jorgenmk/avr-cansat/rapport/acronym.tex

\chapter*{Forkortelser}
\begin{acronym}
	\acro{ESR}{Ekvivalent Serie Resistans}
	\acro{GGA}{Global Positioning System Fixed Data}
	\acro{NMEA}{National Marine Electronics Association}
	\acro{MOSFET}{Metal Oxide Semiconductor Field Effect Transistor}
	\acro{SCL}{Serial Clock}
	\acro{SDA}{Serial Data}
	\acro{CS}{Chip Select}
	\acro{SS}{Slave Select}
	\acro{MISO}{Master Input/Slave Output}
	\acro{MOSI}{Master Output/Slave Input }
	\acro{SCLK}{Serial Clock}
	\acro{DR}{Dead Reckoning}
	\acro{ADC}{Analog-to-Digital Converter}
	\acrodef{AD}{Analog-til-Digital}
	\acro{AGC}{Automatic Gain Control}
	\acro{AES}{Advanced Encryption Standard}
	\acro{AM}{amplitudemodulasjon}
	\acro{API}{Application Programming Interface}
	\acro{AVR}{Alf og Vegards RISC-prosessor}
	\acro{bps}{Baud per second}
	\acro{CAN}{Controller-Area Network}
	\acro{CMOS}{Complementary metal-oxide-semiconductor}
	\acro{CMRR}{Common-Mode Rejection Ratio}
	\acro{CPU}{Central Processing Unit}
	\acro{CTS}{Clear to Send}
	\acro{DAC}{Digital-to-Analog Converter}
	\acro{DC}{Direct Current}
	\acro{EMI}{Electromagnetic Interference}
	\acro{ERC}{European Radiocommunications Office}
	\acro{FAT}{File Allocation Table}	\acro{FET}{Field-effect transistor}
	\acro{FM}{frekvensmodulasjon}
	\acro{IC}{Integrated Circuit}
	\acro{ID}{identifikasjon}
	\acro{IEEE}{Institute of Electrical and Electronics Engineers}
	\acro{I$^{2}$C}{Inter-Integrated Circuit}
	\acro{IR}{infrarød}
	\acro{I/O}{In/Out}
	\acro{ISP}{In-System Programming}
	\acro{JTAG}{Joint Test Action Group}
	\acro{ksps}{Kilo Samples per Second}
	\acro{LED}{Light Emitting Diode}
	\acro{LIN}{Local Interconnect Network}
	\acro{LDO}{Low-Dropout}
	\acro{LSB}{Least Significant Bit}
	\acro{MMC}{Multi-Memory card}
	\acro{MSB}{Most Significant Bit}
	\acro{NAROM}{Nasjonalt senter for romrelatert opplæring}
	\acro{NiCd}{Nickel-Cadmium}
	\acro{NiMH}{Nickel-Metal Hydride}
	\acro{OFM}{overflatemontert}
	\acro{PC}{Personal Computer}
	\acro{PM}{fasemodulasjon}
	\acro{PLL}{Phase Locked Loop}
	\acro{PWM}{Pulse With Modulation}
	\acro{QFN}{Quad Flat No leads}
	\acro{RC}{Resistor-Capacitor}
	\acro{RISC}{Reduced Instruction Set Computer}
	\acro{RF}{radiofrekvens}
	\acro{RPSMA}{Reverse Polarity SMA}
	\acro{RTC}{Real-time Clock}
	\acro{RTS}{Request to Send}
	\acro{RTTY}{Radioteletype}
	\acro{SAR}{Successive Approximation Register}
	\acro{SD}{Secure Digital}
	\acro{SDHC}{Secure Digital High Capacity}
	\acro{S/H}{Sample and Hold}
	\acro{SMA}{SubMiniature version A}
	\acro{SMBus}{System Management Bus}
	\acro{SOT}{Small Outline Transistor}
	\acro{SPI}{Serial Peripheral Interface}
	\acro{SRD}{Short Range Device}
	\acro{TI}{Texas Instruments}
	\acro{UART}{Universal Asynchronous Receiver/Transmitter}
	\acro{UHF}{Ultra High Frequency}
	\acro{USB}{Universal Serial Bus}
	\acro{VCO}{Voltage-controlled oscillator}
	\acro{RH}{Relative Humidity}
	\acro{SMD}{Surface Mounted Device}
	\acro{NTC}{Negative Temperature Coefficient}
\end{acronym}
