jorgenmk/avr-cansat/rapport/handlelister.tex

\chapter{Regnskap}
\label{app:regnskap}

Ett av arbeidsgivers rammer var en øvre økonomisk grense på 5000 norske kroner. Vedlegg \ref{app:regnskap} vil dokumentere alle utgifter relatert til oppgaven.

Tabellene \ref{tab:farnell1}, \ref{tab:farnell3}, \ref{tab:spark}, \ref{tab:spark2}, \ref{tab:farnell2}, \ref{tab:elfa} og \ref{tab:annet} viser detaljerte handlelister fra hver bestillingsrunde. Totalt beløp for alle utgifter havner på 4408 kroner.

\begin{table}[htb]
\centering
\begin{tabular}{llllllllll}
\toprule
\textbf{Komponent}&\textbf{Varenr.}&\textbf{Min antall}&\textbf{Antall}&\textbf{Stk. Pris}&T\textbf{Totalt}\\
\midrule
100 nF kondensator&1414664&Min 10&10&0.31&3.1\\
33 nF kondensator&1414688&Min 10&10&0.4&4\\
22 pF kondensator&1414678&Min 10&10&0.31&3.1\\
10 $\mu$F kondensator&9402136&Min 10&10&3.37&33.7\\
100 $\mu$F kondensator &9695672&&4&3.84&15.36\\
10 pF kondensator&9753559&Min 10&10&0.24&2.4\\
2.2 $\mu$F kondensator&9402152&Min 10&10&2.02&20.2\\
4,7 $\mu$F kondensator&1650928&&1&0.61&0.61\\
8.2 k$\Omega$&9234128&Min 50&50&0.24&12\\
33 k$\Omega$ motstand&9334378&Min 50&50&0.33&16.5\\
10 k$\Omega$ motstand&9332391&Min 50&50&0.37&18.5\\
300 $\Omega$ motstand&9332987&Min 50&50&0.37&18.5\\
1 M$\Omega$ motstand&9332413&Min 50&50&0.37&18.5\\
1 k$\Omega$ motstand&9332383&Min 50&50&0.37&18.5\\
2,2 $\Omega$ shunt&1652978&&1&0.74&0.74\\
5,6 $\Omega$ shunt&1399730&Min 10&10&0.77&7.7\\
1,5 $\Omega$ shunt&1399714&Min 10&10&0.77&7.7\\
100 $\Omega$&9333703&Min 50&50&0.16&8\\
4.22 k$\Omega$&1653139&&2&0.74&1.48\\
2.2 k$\Omega$ motstand&1469887&Min 50&50&0.3&15\\
100 k$\Omega$&1652905&&2&0.74&1.48\\
INA193AIDBVT&1564940&&3&24.06&72.18\\
LP2985IM5-3.3&9778284&&3&14.09&42.27\\
LP2985IM5-5.0&9778306&&1&13.76&13.76\\
MMBT2222&1459098&&4&0.25&1\\
BSS138 N-MOSFET&1431319&&2&1.51&3.02\\
BAS16 DIODE&1621825&Min 10&10&0.48&4.8\\
LED 0805 green&1685052&&4&3.02&12.08\\
LED 0805 red&1685054&&1&3.03&3.03\\
IR RECEIVER &4913139&&1&17.99&17.99\\
3.6864MHz Krystall&1079075&&4&6.02&24.08\\
32kHz Krystall&1457088&&1&7.87&7.87\\
Bus-connector&359907&&5&40.06&200.3\\
Thermistor&1187086&Min 5&5&7.75&38.75\\
Thermistor&9707174&&1&50.3&50.3\\
Fuktsensor&1566264&&1&67.1&67.1\\
Akselerometer&1566157&&1&110.06&110.06\\
Hex spacer&R401001402 &&1&104.2&104.2\\
\midrule
Total kostnad:&&&&&999.86\\
\bottomrule
\end{tabular}
\caption{Første handleliste Farnell(alle priser i NOK)}
\label{tab:farnell1}
\end{table}

\begin{longtable}{p{2.3cm}lllllllll}
\caption{Tredje handleliste Farnell(alle priser i NOK)}
\label{tab:farnell3}\\
\toprule
\textbf{Varenr.} & \textbf{Antall} & \textbf{Komponent} & \textbf{Stk. Pris} & \textbf{Totalt}\\
\midrule
\endfirsthead

\multicolumn{4}{l}{{\bfseries \tablename\ \thetable{} -- forts. fra forrige side}}\\
\textbf{Komponent}&\textbf{Varenr.}&\textbf{Antall}&\textbf{Stk. Pris}&\textbf{Totalt}\\
\midrule
\endhead

\multicolumn{4}{l}{\bfseries \tablename\ \thetable{} forst. neste side}\\
\multicolumn{3}{r}{{}}
\endfoot

\bottomrule
\endlastfoot

1056234 & 10 & SOCKET, SMD, 6WAY & 4.58 & 45.8\\
1081473 & 5 & MOSFET, N, SOT-23 & 2.19 & 10.95\\
1100337 & 5 & RESISTOR, 1206 0R2 & 5.13 & 25.65\\
1212263 & 1 & CHARGE MANAGER LIION LDO, SMD, 2057 & 36.39 & 36.39\\
1216982 & 1 & PLUG, LOW VOLTAGE, 0.7MM & 9.49 & 9.49\\
1216988 & 1 & SOCKET, LOW VOLTAGE, 0.65MM & 10.53 & 10.53\\
1294480 & 5 & CAPACITOR, 0603, 100PF, 200V, C0G & 2.3 & 11.5\\
1362560 & 10 & CAPACITOR, 0805, 47PF, 50V, NP0 & 0.26 & 2.6\\
1399696 & 10 & RESISTOR, 0R3 1\% 0805 0.125W & 0.79 & 7.9\\
1414573 & 10 & CAPACITOR, 0402, 1NF, 50V, X7R & 0.13 & 1.34\\
1414664 & 30 & CAPACITOR, 0805, 100NF, 50V, X7R & 0.32 & 9.6\\
1414678 & 10 & CAPACITOR, 0805, 22PF, 50V, NP0 & 0.32 & 3.2\\
1437701 & 1 & SLIDE SWITCH, SPDT, R/A, ON-ON & 47.75 & 47.75\\
1515671 & 5 & FERRITE BEAD, 0603 CASE, 1KOHM & 0.67 & 3.35\\
1559374 & 1 & Voltage Regulator IC & 12.65 & 12.65\\
1564940 & 1 & CURRENT SHUNT MONITOR, 500KHZ & 25.3 & 25.3\\
1576013 & 5 & RESISTOR, 97K6, 0805 0.1\% 25PPM 0.1W & 5.68 & 28.4\\
1578142 & 5 & RECEPTACLE, FREE, 6WAY & 1.22 & 6.1\\
1578205 & 5 & HEADER, R/ANGLE, SMT, 6WAY & 6.18 & 30.9\\
1640891 & 1 & CRYSTAL, 8.000MHZ & 15.74 & 15.74\\
1650863 & 1 & CAPACITOR, CERAMIC MULTILAYER & 0.65 & 0.65\\
1652811 & 1 & THICK FILM CHIP RESISTOR & 0.74 & 0.74\\
1652905 & 2 & THICK FILM CHIP RESISTOR & 0.74 & 1.48\\
1652924 & 2 & THICK FILM CHIP RESISTOR & 0.74 & 1.48\\
1652925 & 1 & THICK FILM CHIP RESISTOR & 0.74 & 0.74\\
1653139 & 2 & THICK FILM CHIP RESISTOR & 0.74 & 1.48\\
1656583 & 2 & LEAD, SKT/FREE END, 150MM, PK10 & 41.72 & 83.44\\
1685052 & 3 & LED, SMD, 0805, PURE GRN & 3.02 & 9.06\\
359907 & 1 & SOCKET, PC104, THROUGH, 40WAY & 40.06 & 40.06\\
3908021 & 1 & RECEPTACLE, SMT, U.FL & 18.74 & 18.74\\
613009 & 50 & RESISTOR, 0805 180R & 0.09 & 4.65\\
7568355 & 5 & CAPACITOR, 0603, 27PF, 100V & 3.09 & 15.45\\
9227806 & 10 & CAPACITOR, 0805, 1UF, 16V & 0.42 & 4.2\\
9227849 & 10 & CAPACITOR, 0805, 4.7UF, 16V & 2.8 & 28\\
9234284 & 50 & RESISTOR, RC11 0805 180K & 0.24 & 12\\
9236392 & 50 & RESISTOR, RC11 0805 10M & 0.19 & 9.6\\
9332456 & 50 & RESISTOR, 0805 11K & 0.18 & 9.05\\
9333991 & 50 & RESISTOR, 0805 16K & 0.16 & 8\\
9334580 & 50 & RESISTOR, 0805 4K7 & 0.16 & 8\\
9334653 & 50 & RESISTOR, 0805 51K & 0.16 & 8\\
9402136 & 10 & CAPACITOR, 0805, 10UF, 10V, X5R & 3.37 & 33.7\\
9402152 & 10 & CAPACITOR, 0805, 2.2UF, 10V, X7R & 2.02 & 20.2\\
9406352 & 10 & CAPACITOR, 0805, 10NF, 50V & 0.52 & 5.2\\
9526625 & 5 & TRANSISTOR, PNP, SOT-223 & 16.27 & 81.35\\
9695672 & 1 & CAPACITOR, CASE D, 100UF, 16V & 3.84 & 3.84\\
9728937 & 1 & HEADER, SOCKET, 2MM, 50WAY & 59.44 & 59.44\\
9753559 & 10 & CAPACITOR, 0805, 10PF, 50V & 0.24 & 2.4\\
9778284 & 1 & V REG LDO +3.3V, SMD, 2985, SOT235 & 14.37 & 14.37\\
9778306 & 1 & V REG LDO +5.0V, SMD, 2985, SOT235 & 14.04 & 14.04\\
9846336 & 1 & MOSFET, P, SOT-23 & 7.73 & 7.73\\
9962832 & 1 & SWITCH, SPNO, SMD & 2.74 & 2.74\\
\midrule
Totalt: &  &  &  & 1143.71
\end{longtable}

\begin{table}[htb]
\centering
\begin{tabular}{lllll}
\toprule
\textbf{Varenummer}&\textbf{Beskrivelse}&\textbf{Antall}&\textbf{Pris}&\textbf{Totalt}\\
\midrule
COM-08226 & DOSOnChip & 2 &12,95 & 25,90\\
GPS-00178 & GPS-antenne ekstern & 1 &18,95 & 18,95\\
GPS-08418 & GPS chipantenne & 2 &2,95 & 5,90\\
GPS-08825 & GPS mottaker MN5010HS & 2 &39,95 & 79,90\\
PRT-00127 & microSD socket & 2 &3,95 & 7,90\\
\midrule
Frakt: &&&& 4,20\\
Totalt:&&&& 142,75\\
\bottomrule
\end{tabular}
\caption{Første handleliste Sparkfun.com(alle priser i US\$)}
\label{tab:spark}
\end{table}

\begin{table}[htb]
\centering
\begin{tabular}{lllll}
\toprule
\textbf{Varenummer}&\textbf{Beskrivelse}&\textbf{Antall}&\textbf{Pris}&\textbf{Totalt}\\
\midrule
PRT-00341 & Li-Ion Batteri & 2 & 8,95 & 17,90\\
COM-00650 & FT232USB-UART & 1 & 3,95 & 3,95\\
PRT-08612 & Batterikonnektor SMD & 4 & 0,95 & 3,80\\
PRT-00587 & MiniUSB konnektor & 1 & 1,50 & 1,50\\
\bottomrule
\end{tabular}
\caption{Andre handleliste Sparkfun.com(alle priser i US\$)}
\label{tab:spark2}
\end{table}

\begin{table}[htb]
\centering
\begin{tabular}{lllll}
\toprule
\textbf{Varenummer} & \textbf{Beskrivelse} & \textbf{Antall} & \textbf{Pris} & \textbf{Total}\\
\midrule
359907 & SOCKET, PC104, THROUGH, 40WAY & 3 & 40.06 & 120.18\\
9778284 & V REG LDO +3.3V, SMD, 2985, SOT235 & 4 & 14.37 & 57.48\\
3908100 & RECEPTACLE, SMT, H.FL & 1 & 25.5 & 25.5\\
1564940 & CURRENT SHUNT MONITOR, 500KHZ & 3 & 25.3 & 75.9\\
7569564 & CAPACITOR, S/TERM, 0805, 100NF, 50V & 20 & 0.96 & 19.2\\
9695672 & CAPACITOR, CASE D, 100UF, 16V & 3 & 3.84 & 11.52\\
1685052 & LED, SMD, 0805, PURE GRN & 1 & 3.02 & 3.02\\
1685054 & LED, SMD, 0805, RED & 1 & 3.03 & 3.03\\
1651700 & SPACERS, 15MM & 12 & 4.46 & 53.52\\
1632238 & PCB Connector  & 2 & 15.87 & 31.74\\
\midrule
Total: &  &  &  & 576.36\\
\bottomrule
\end{tabular}
\caption{Andre handleliste Farnell(alle priser i NOK)}
\label{tab:farnell2}
\end{table}

\begin{table}[htb]
\centering
\begin{tabular}{lllll}
\toprule
\textbf{Varenummer}&\textbf{Beskrivelse}&\textbf{Antall}&\textbf{Pris}&\textbf{Totalt}\\
\midrule
43-543-12 & Plugg & 1 & 12,60 & 12,60\\
43-544-03 & Motstykke  & 1 & 0,92 & 0,92\\
43-544-78 & Ledning & 6 & 10,10 & 60,60\\
48-012-43 & Distans & 20 & 2,80 & 56,00\\
65-612-52 & EMI-filter & 5 & 8,65 & 43,25\\
\midrule Totalt: &&&&173,37\\
\bottomrule
\end{tabular}
\caption{Handleliste Elfa(alle priser i NOK)}
\label{tab:elfa}
\end{table}

\begin{table}[htb]
\centering
\begin{tabular}{lll}
\toprule
\textbf{Beskrivelse}&\textbf{Totalt}\\
\midrule
Jernvare Clas Ohlsson & 188,00\\
Fallskjerm & 150,00\\
Tollutgifter første bestilling Sparkfun & 249,00\\
\midrule
Totalt: & 587,00\\
\bottomrule
\end{tabular}
\caption{Andre utgifter(alle priser i NOK)}
\label{tab:annet}
\end{table}
