jorgenmk/avr-cansat/rapport/title.tex

\begin{titlepage}

\begin{center}

% Upper part of the page
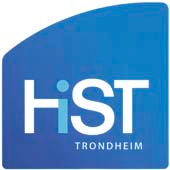
[picture p11: rapport/logo.png]
\\[1cm]
 %bb=0 0 170 170,
\textsc{\LARGE HiST Bacheloroppgave}\\[1.5cm]

% Title
\HRule \\[0.4cm]
{ \huge \bfseries CanSat}\\[0.4cm]

\HRule \\[1.5cm]

\textsc{\Large Satelitt i en colaboks}\\[0.5cm]
% Author and supervisor
\begin{minipage}{0.4\textwidth}
\begin{flushleft} \large
\emph{Gruppedeltakere:}\\
Mats Møller \textsc{Bæren}\\
Jørgen Moe \textsc{Kvalvaag}\\
Gaute \textsc{Nilsson}\\
Joakim André \textsc{Tønnesen}\\[0.5cm]
\emph{Studieretning}\\
\textsc{Elektronikk}\\[0.5cm]
\emph{Oppdragsgiver}\\
\textsc{narom}
\end{flushleft}
\end{minipage}
\begin{minipage}{0.4\textwidth}
\begin{flushright} \large
\emph{Startdato}\\
6 Januar 2009\\[0.5cm]
\emph{Veiledere:} \\
Valdemar \textsc{Finanger}\\
Stein \textsc{Øvstedal}\\[0.5cm]
\emph{Prosjektnummer}\\
\textsc{hpe} 0914\\[0.5cm]
\emph{Kontaktperson hos oppdragsgiver}\\
Torstein \textsc{Wang}\\
Jøran \textsc{Antonsen}
\end{flushright}
\end{minipage}

\vfill

% Bottom of the page
{\large \today}

\end{center}

\end{titlepage}
