jorgenmk/avr-cansat/rapport/GPS-Software-flytskjema.pdf

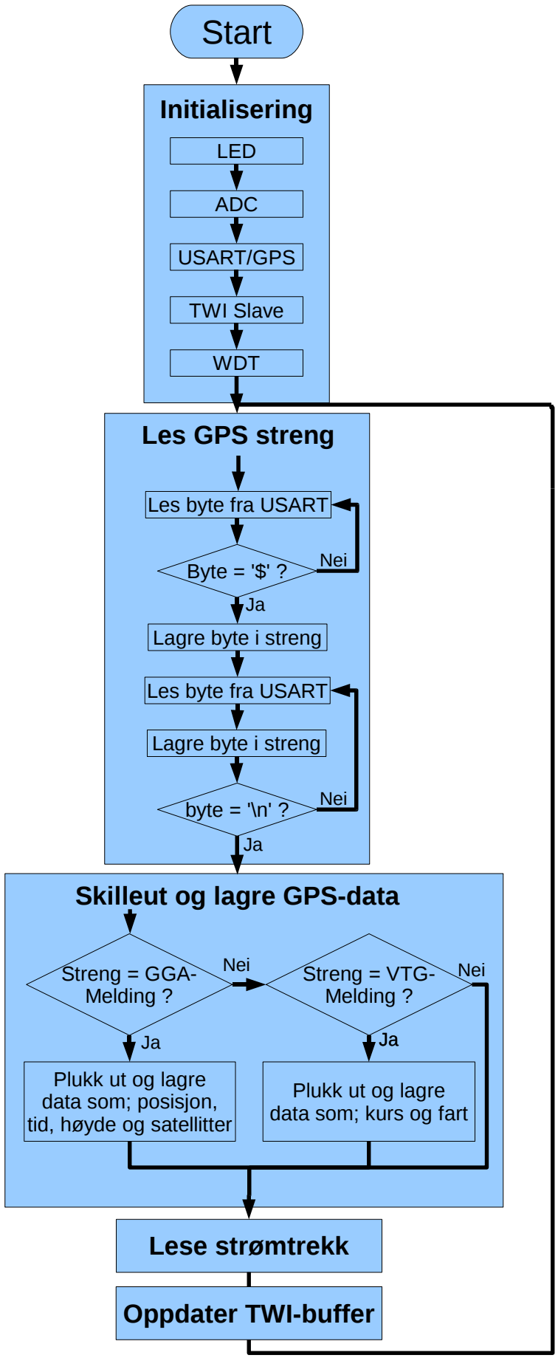
[picture p13: figure]
Start; LED; Initialisering; ADC; USART/GPS; TWI Slave; WDT; Les byte fra USART; Oppdater TWI-buffer; Byte = '$' ?; Lagre byte i streng; Les GPS streng; byte = '\n' ?; Plukk ut og lagre data som; posisjon, tid, høyde og satellitter; Skilleut og lagre GPS-data; Streng = VTG- Melding ?; Plukk ut og lagre data som; kurs og fart; Streng = GGA- Melding ?; Nei; Lese strømtrekk
