jorgenmk/avr-cansat/rapport/datablad/TN-090013-1D_Cansat_TX.pdf

# Technical Note

# Cansat TX

TN-090013

TN-090013 revision 1

Revision | 1
Date | 2009-03-13
Prepared by | SK

Checked by

Approved by

# 1. Introduction

This note contains some ideas for implementation of a telemetry transmitter in the 860MHz band for low data rates up to 10km distance.

# 2. Transmission budgets

Transmission loss calculated from the free space loss equation (860MHz, 10km):

A=20×log

L
4××d

=20×log

0.349m
4××10000m

=−111.1dB

and the thermal noise:

P=k×t×b=1.38×10

−23×300=−173.8dBm/Hz

Norbit AS | TN-090013-1 Cansat TX | 2/5
| dB | dBm | Comments
TX power | | 27 | 0.5W
TX antenna gain | 0 | 27
Free space loss | -111.1 | -84.1 | 10km, 860MHz
RX antenna gain | 0 | -84.1
| RX signal level | -84.1 | Signal power at RX
Thermal noise | | -173.8 | ktb
RX bandwidth | 37 | -136.8 | 5kHz
RX noise figure | 5 | -121.8 | Noise power at RX
Signal to noise | 10 | -126.8 | Depends on BER
| RX sensitivity | -121.8
Link margin | 37.7

# 3. Block diagram

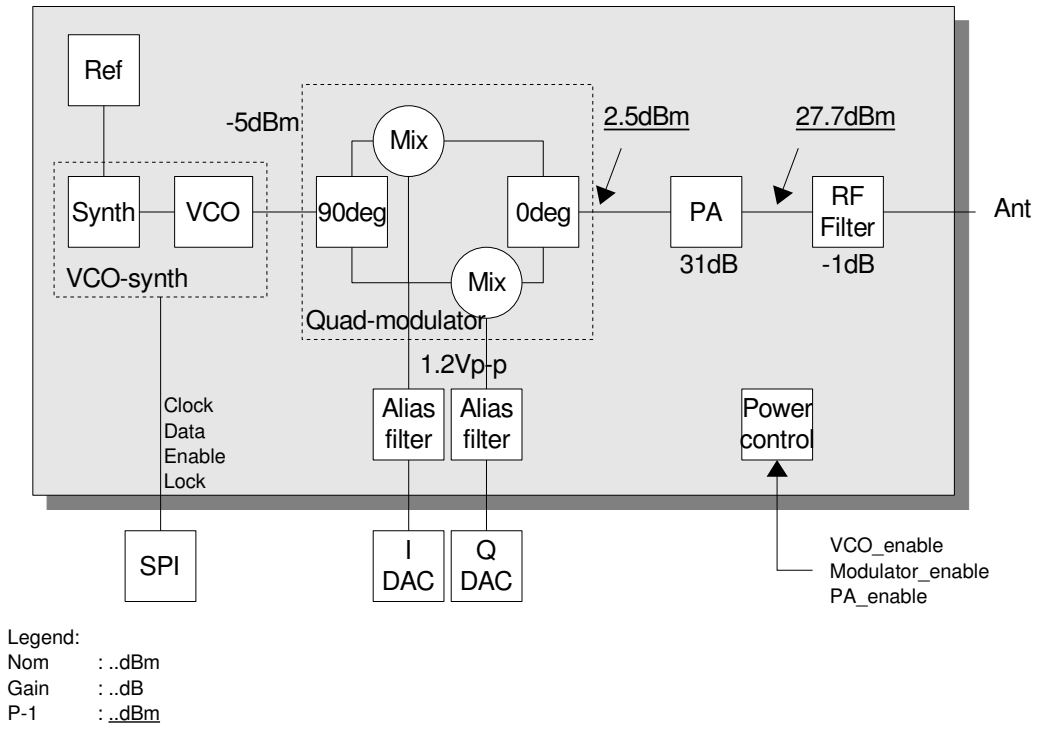
[picture p14: figure]
Ref; Synth; VCO; Alias filter; 90deg; Mix; 0deg; RF Filter; Ant; I DAC; Q DAC; SPI; -5dBm; 2.5dBm; 27.7dBm; Quadmodulator; VCO-synth; Legend:; Nom; : ..dBm; Gain; Clock Data Enable Lock; Power control; VCO_enable Modulator_enable PA_enable

# 4. Specifications

Frequency | : 860MHz band, programmable
Accuracy | : +/-2ppm
Transmit power : 27dBm | 0.5W
Power supply : 3V, 85mA
| : 5V, 240mA
Modulation | : FM, PSK, AM
Bandwidth | : DC .. 4kHz | narrow
: DC .. 100kHz wideband
Programming : 3-wire serial

5

C

o

# mponent

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
oscilla

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
Clip

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
vice

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
vice

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
m I/Q: 1.2Vpp diff
e

r

e

n

tial hig

h im

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
Minici

rcuit

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
filt

e

r

:
Minici

rcuit

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
alias

filt

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
vice

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
m I/Q : 1Vpp 5V, 100mA Opt modulator (

p

assiv

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
Minici

rcuits

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
868 .. 895MHz
LO: 10dBm
P-1: 1dBm

Opt driver:
Analog Devices, ADL5541
15dB
6GHz
P-1: 19.7dBm
5V, 90mA

Opt PA:
Analog Devices, ADL5322
700 .. 1000MHz
Gain: 20dB
P-1: 27dBm
5V, 320mA

Opt Antialias filter (2 of): Analog Devices, AD8132
2.7 .. 5.5V, 10mA
