jorgenmk/avr-cansat/rapport/Hovedkort/flytskjema.pdf

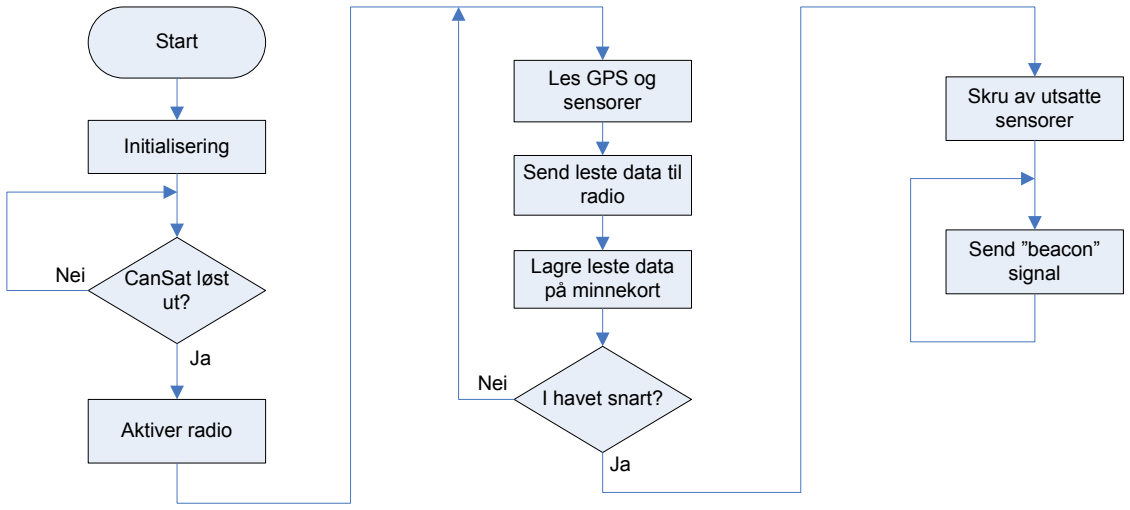
[picture p15: figure]
CanSat løst ut?; Start; Aktiver radio; Nei; Les GPS og sensorer; Send leste data til radio; Lagre leste data på minnekort; I havet snart?; Skru av utsatte sensorer; Send ”beacon” signal; Initialisering
