jorgenmk/avr-cansat/rapport/sensorkort/flytskjema.pdf

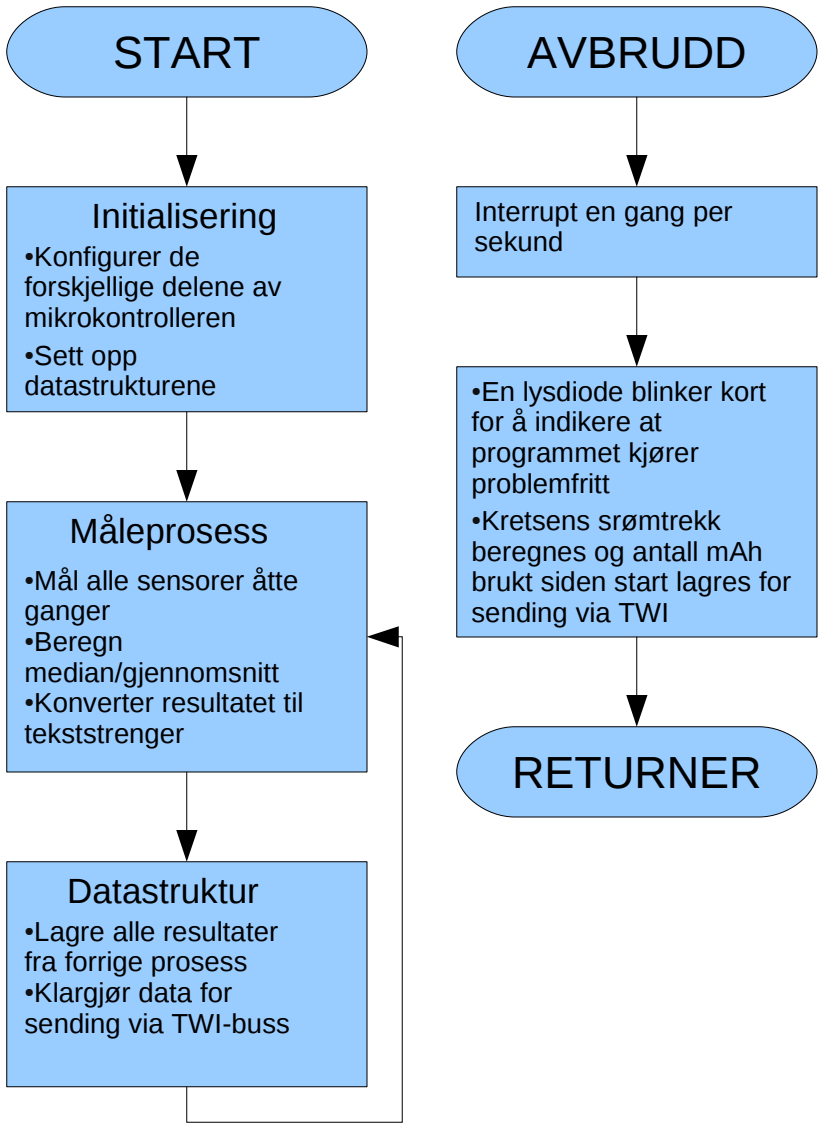
[picture p16: figure]
START; Initialisering ●Konfigurer de forskjellige delene av mikrokontrolleren ●Sett opp datastrukturene; Måleprosess; ●Mål alle sensorer åtte ganger ●Beregn median/gjennomsnitt ●Konverter resultatet til tekststrenger; Datastruktur ●Lagre alle resultater fra forrige prosess ●Klargjør data for sending via TWI-buss; Interrupt en gang per sekund; ●En lysdiode blinker kort for å indikere at programmet kjører problemfritt ●Kretsens srømtrekk beregnes og antall mAh brukt siden start lagres for sending via TWI; RETURNER

AVBRUDD | AVBRUDD

Hovedkortet ønsker data
sendt via TWI

Alle lagrede sensordata I
tillegg til kretsens forbruk av mAh sendes tilbake til
hovedkortet

## RETURNER
