jorgenmk/avr-cansat/rapport/intro.tex

\chapter{Innledning}

\section{Hva er CanSat}

Ideen om CanSat oppsto i USA på slutten av nittitallet. Målet var å øke interessen for romfart og teknologi blant studentene. I dag avholdes det årlige konkurranser i USA og Japan.

CanSat er på vei framover også i Norge gjennom romfartsorganisasjonen NAROM, som også er oppdragsgiver for prosjektet. I år er fire videregående skoler med på et pilotprosjekt der de skal sette sammen et CanSat byggesett og skyte dem opp.

\section{Problemstilling}
