jorgenmk/avr-cansat/rapport/master.tex

\documentclass[11pt,norsk,a4paper,twoside]{report}

\usepackage{mystyle}

\date{\today}

\begin{document}
\pagestyle{empty}
\input{./title.tex}
\pagenumbering{roman}
\clearpage
\include{abstract}

\include{forord}
\newpage
\tableofcontents
\listoffigures
\listoftables

\pagestyle{headings}
\include{innledning}
\pagenumbering{arabic}
\include{teori}
\cleardoublepage
\include{hovedkort}
\cleardoublepage
\include{gpskort}
\cleardoublepage
\include{sensorboard}
\cleardoublepage
\include{radiokort}
\cleardoublepage
\include{xbeekort}
\cleardoublepage
\include{konklusjon}
\cleardoublepage
\include{acronym}
\cleardoublepage
\include{bibliografi}
\cleardoublepage
\appendix
\include{handlelister}
\include{kretsskjema}

\end{document}
