jorgenmk/avr-cansat/rapport/moduler.tex

\chapter{Cansat Moduler}

Introduksjon til de forskjellige modulene oppbygning etc
