jorgenmk/avr-cansat/CPU-kort/Rapport/master.tex

%\ifx\pdfoutput\undefined % If you are running latex then:
%\documentclass[a4paper,11pt,twoside,final]{report}
%\usepackage[dvips]{graphicx}
%\else
\documentclass[pdftex,a4paper,11pt,twoside,final]{report}

\DeclareGraphicsExtensions{.pdf,.png,.jpg,.mps}
%\usepackage{hyperref}

%\fi

\date{\today}

\usepackage{mystyle}

\begin{document}

%\input{./title.tex}

%\include{forord}

\tableofcontents
\listoffigures
\listoftables

%\include{abstract}

%\include{intro}

\include{hovedkort}

%\include{gpskort}

%\include{sensorboard}

%\include{radiokort}

%\include{bibliografi}

\end{document}
