jorgenmk/avr-cansat/aliasInngSys.png

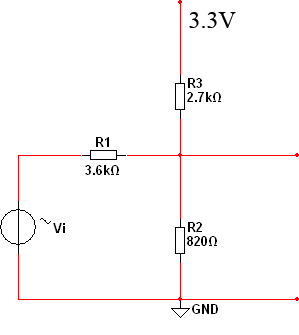
aliasInngSys.png
