jorgenmk/avr-cansat/dobbleBandMod.png

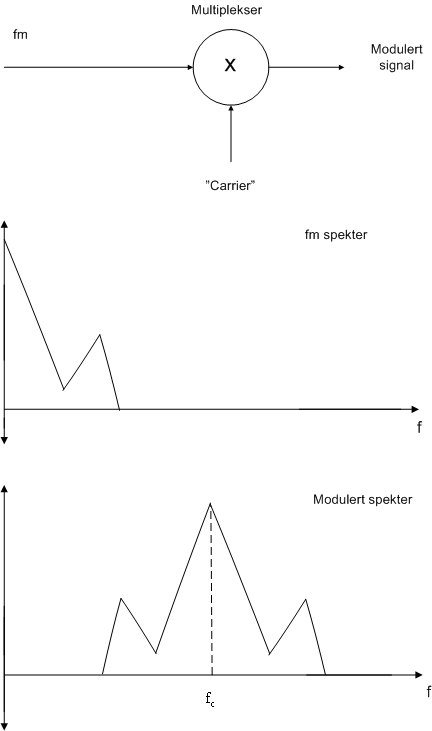
dobbleBandMod.png
