jorgenmk/avr-cansat/fagartikkel/batterikort.jpg

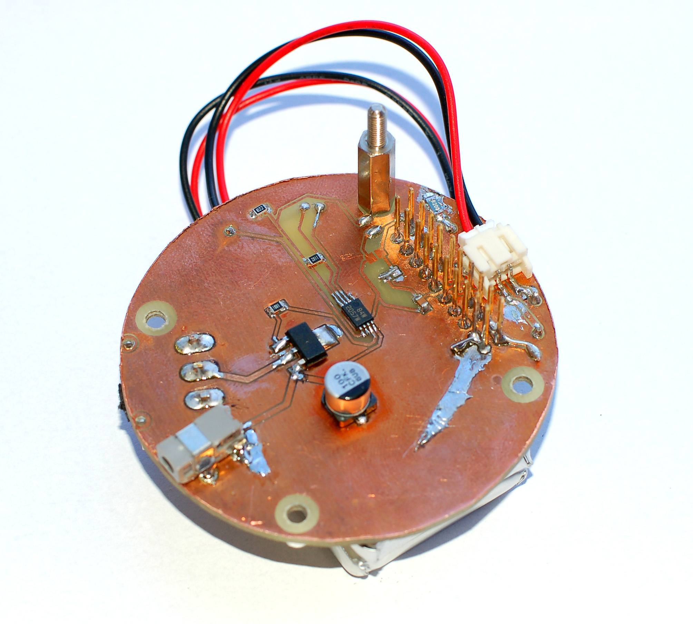
fagartikkel/batterikort.jpg
