jorgenmk/avr-cansat/fagartikkel/cansat2.png

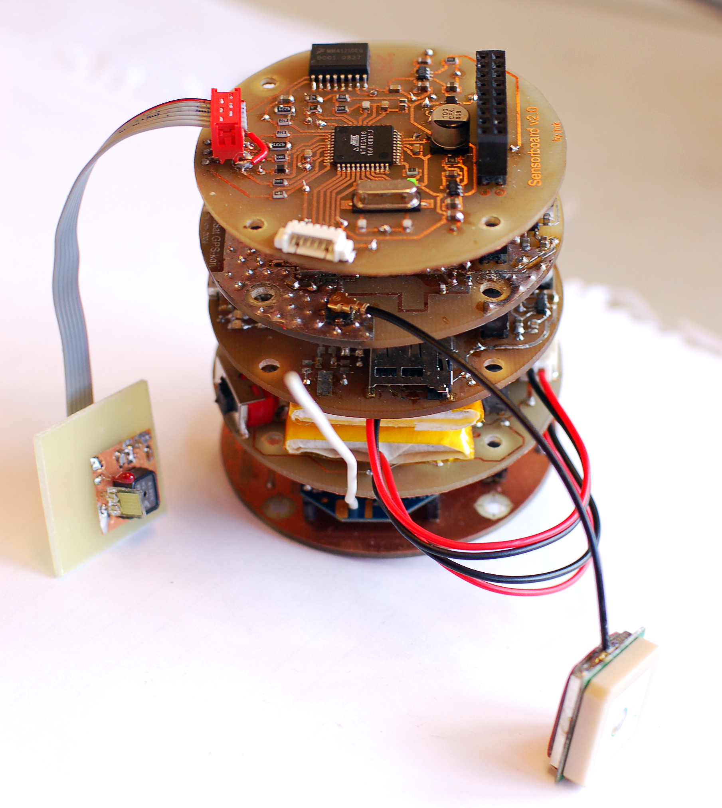
fagartikkel/cansat2.png
