jorgenmk/avr-cansat/fagartikkel/cansat_alle_kort.jpg

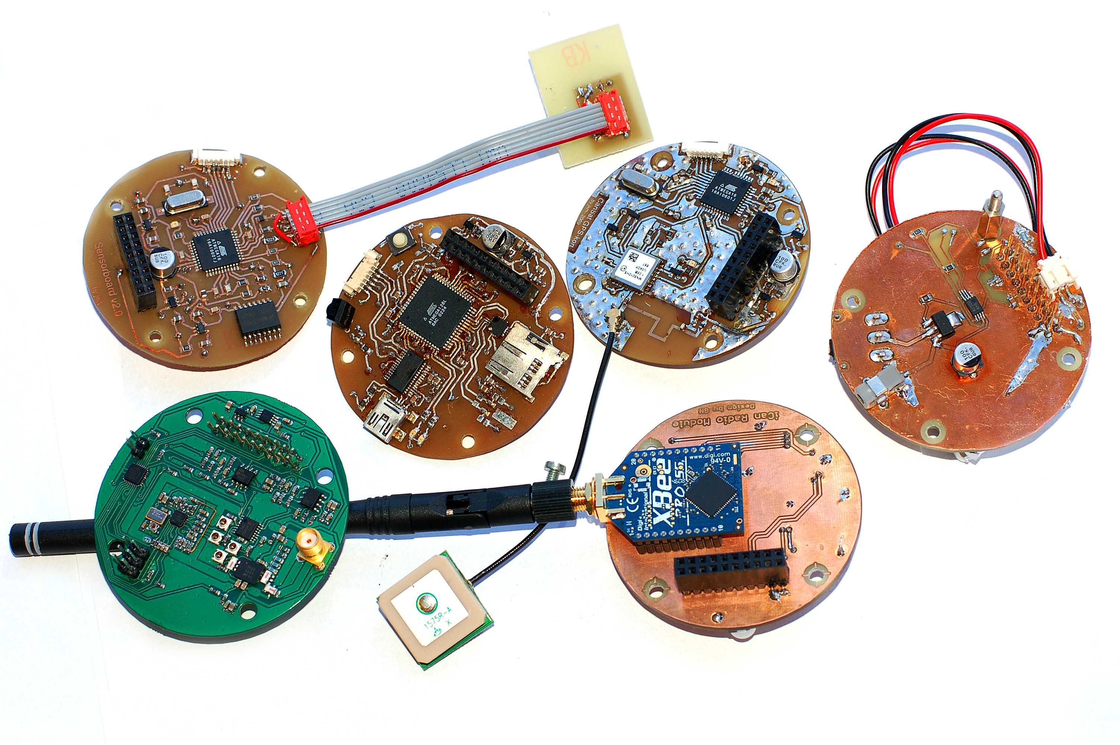
fagartikkel/cansat_alle_kort.jpg
