jorgenmk/avr-cansat/fagartikkel/cansat_hel.jpg

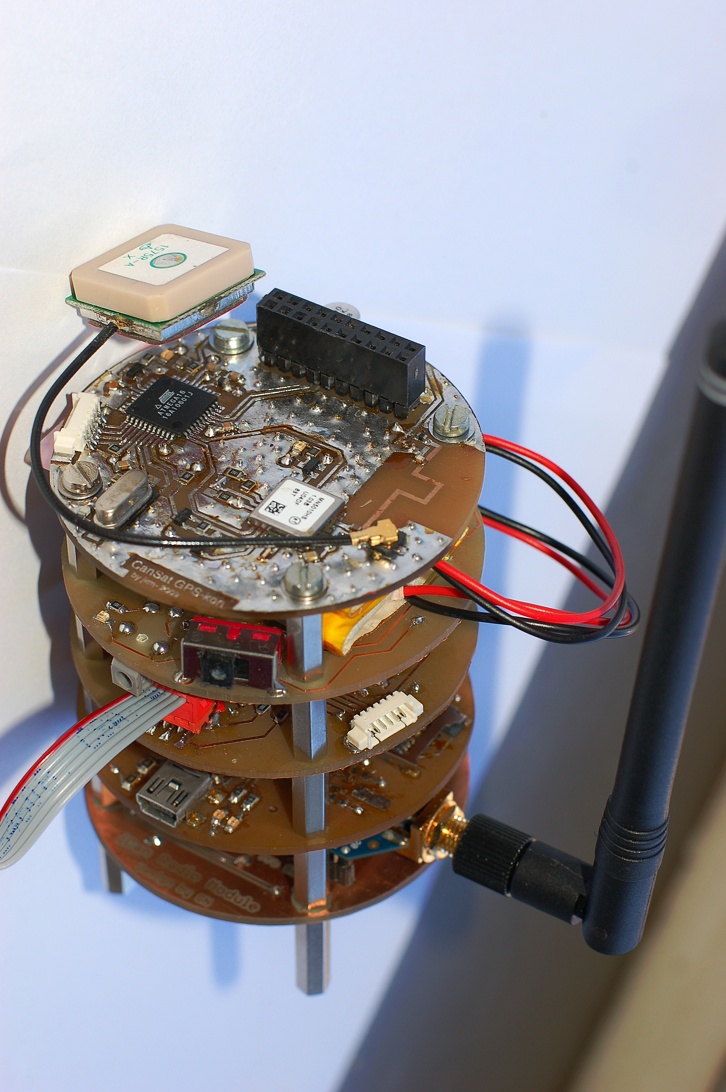
fagartikkel/cansat_hel.jpg
