jorgenmk/avr-cansat/fagartikkel/gpskort.jpg

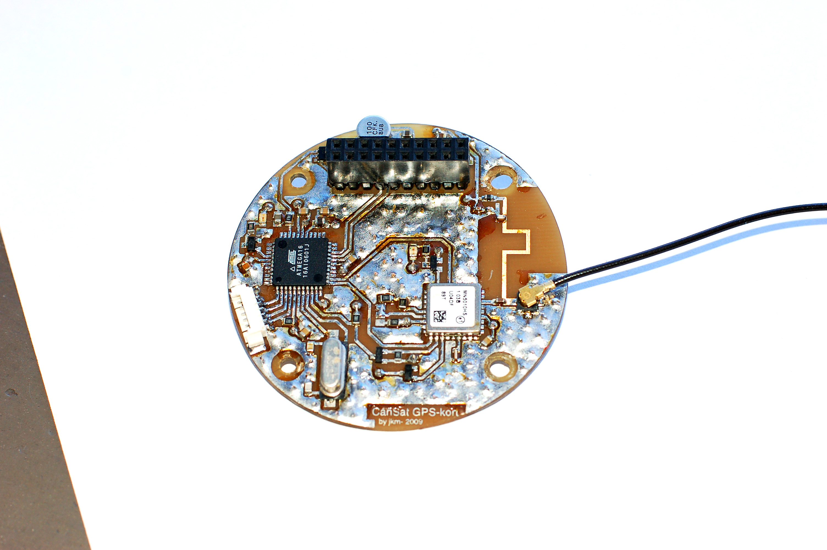
fagartikkel/gpskort.jpg
