jorgenmk/avr-cansat/fagartikkel/hobedkort.jpg

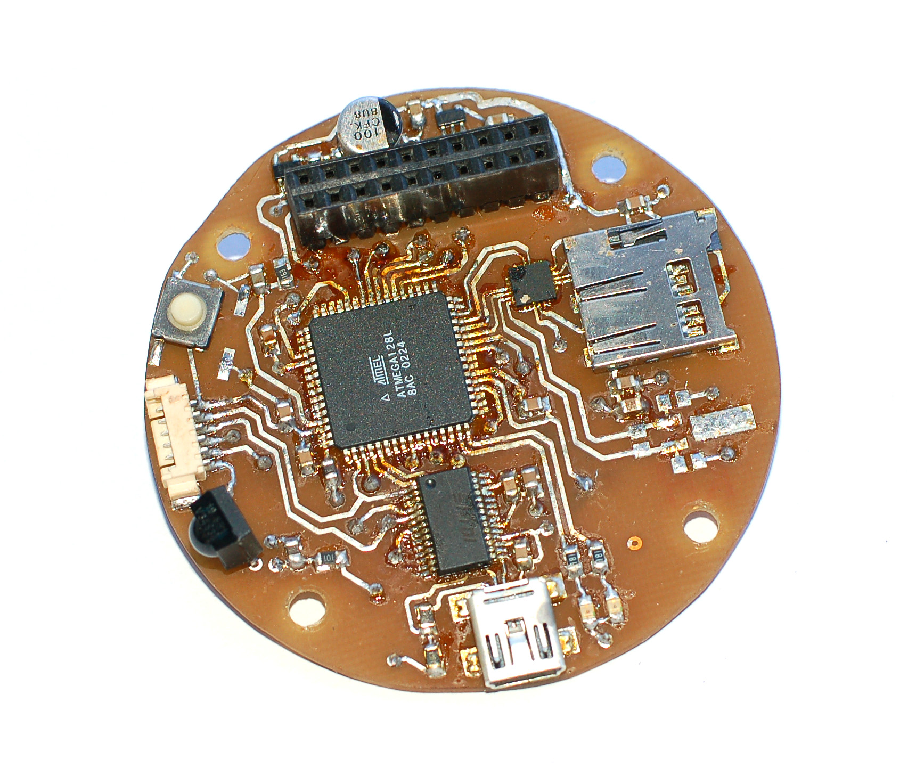
fagartikkel/hobedkort.jpg
