jorgenmk/avr-cansat/fagartikkel/sensorkort.jpg

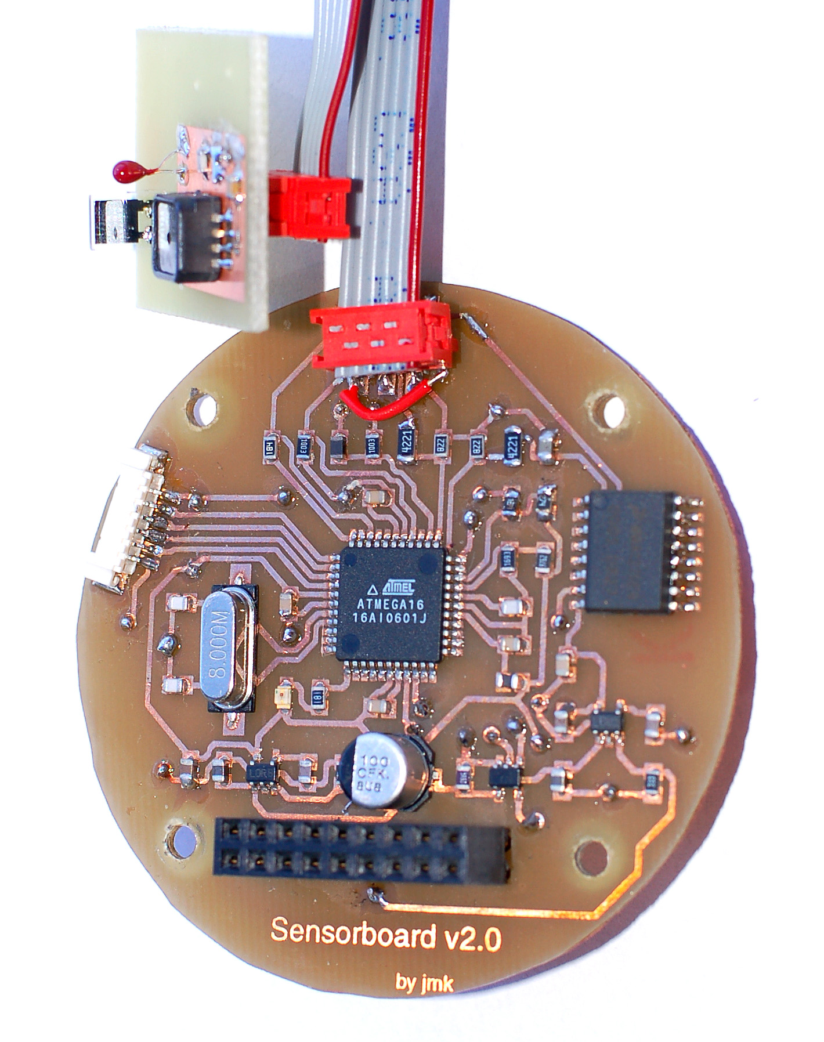
fagartikkel/sensorkort.jpg
