jorgenmk/avr-cansat/fagartikkel/xbeekort.jpg

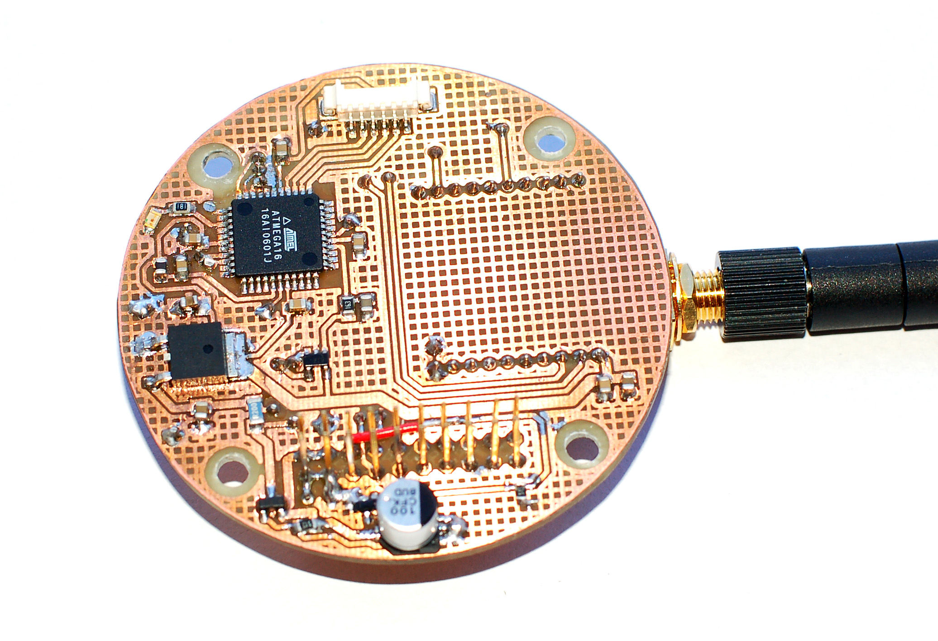
fagartikkel/xbeekort.jpg
