jorgenmk/avr-cansat/rapport/figurer/referanseSP.PNG

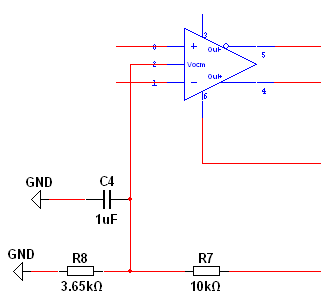
rapport/figurer/referanseSP.PNG
