jorgenmk/avr-cansat/rapport/figurer/singleBandMod.png

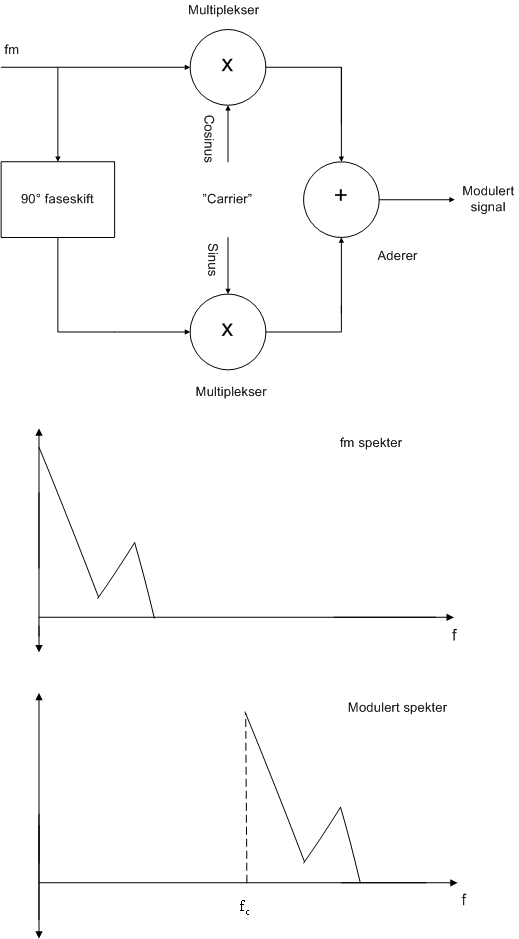
rapport/figurer/singleBandMod.png
