jorgenmk/avr-cansat/rapport/GPSkortbrd.png

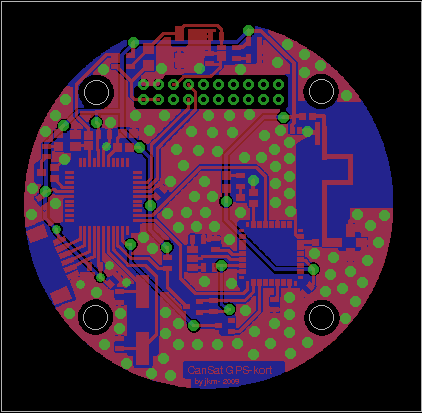
rapport/GPSkortbrd.png
