jorgenmk/avr-cansat/rapport/scope/FSK0XAA.png

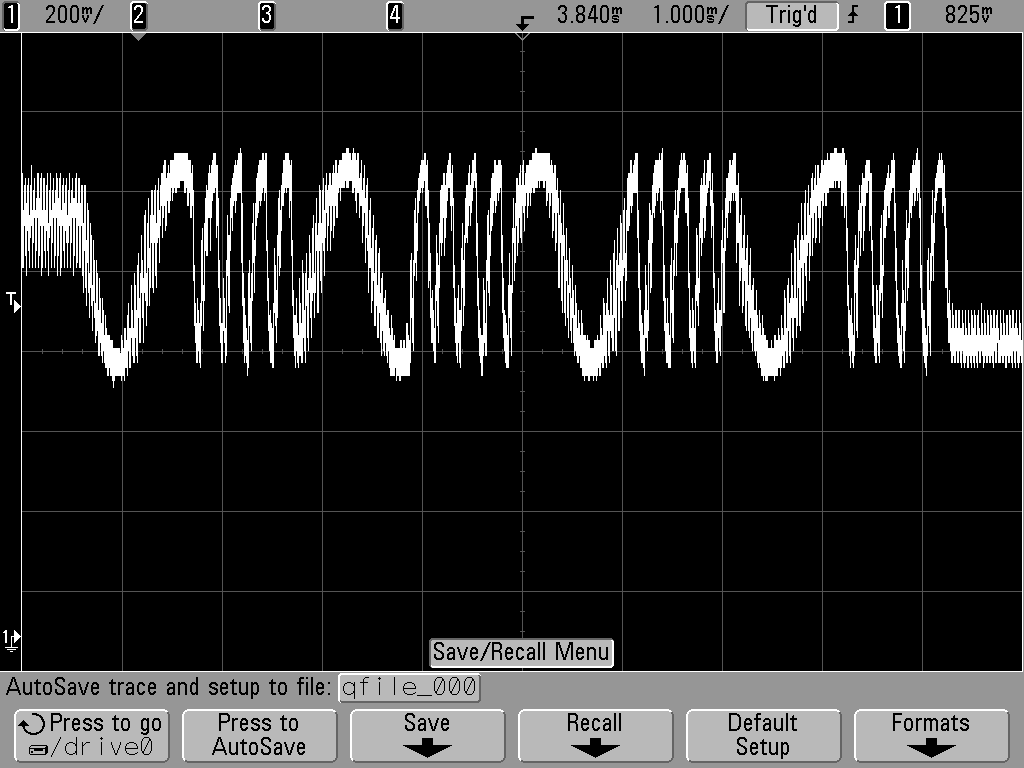
rapport/scope/FSK0XAA.png
