jorgenmk/avr-cansat/rapport/scope/sin250Hz.bmp

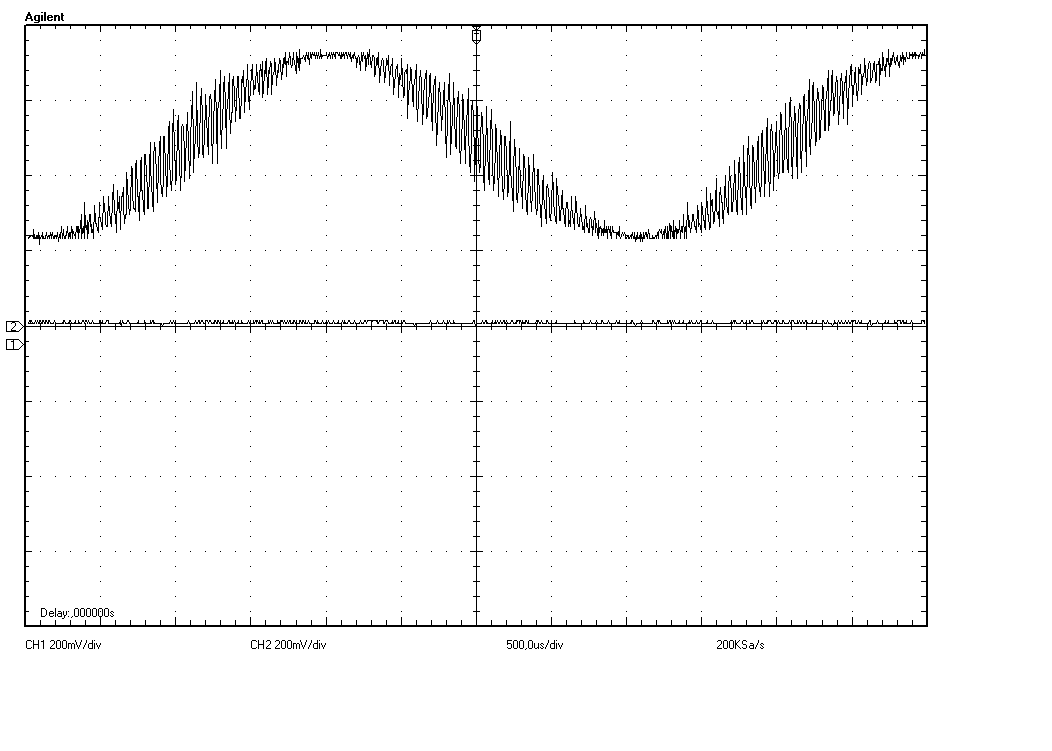
rapport/scope/sin250Hz.bmp
