jorgenmk/avr-cansat/rapport/scope/sin1250HzDCinng.bmp

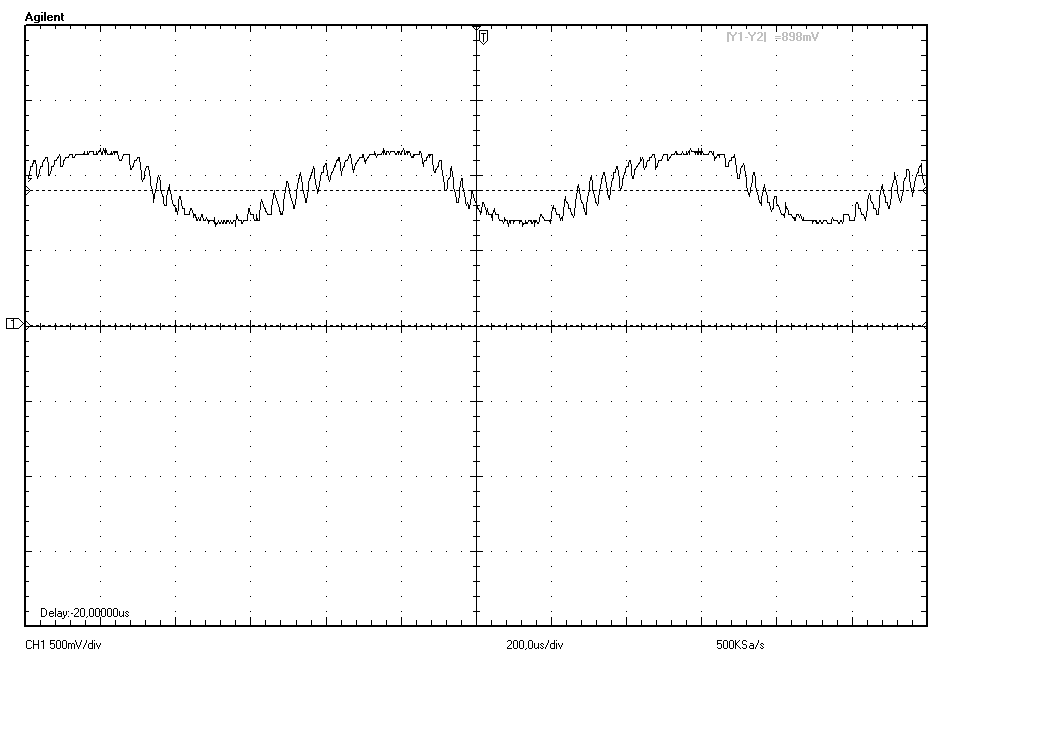
rapport/scope/sin1250HzDCinng.bmp
