jorgenmk/avr-cansat/rapport/scope/sin1250HzVpp.bmp

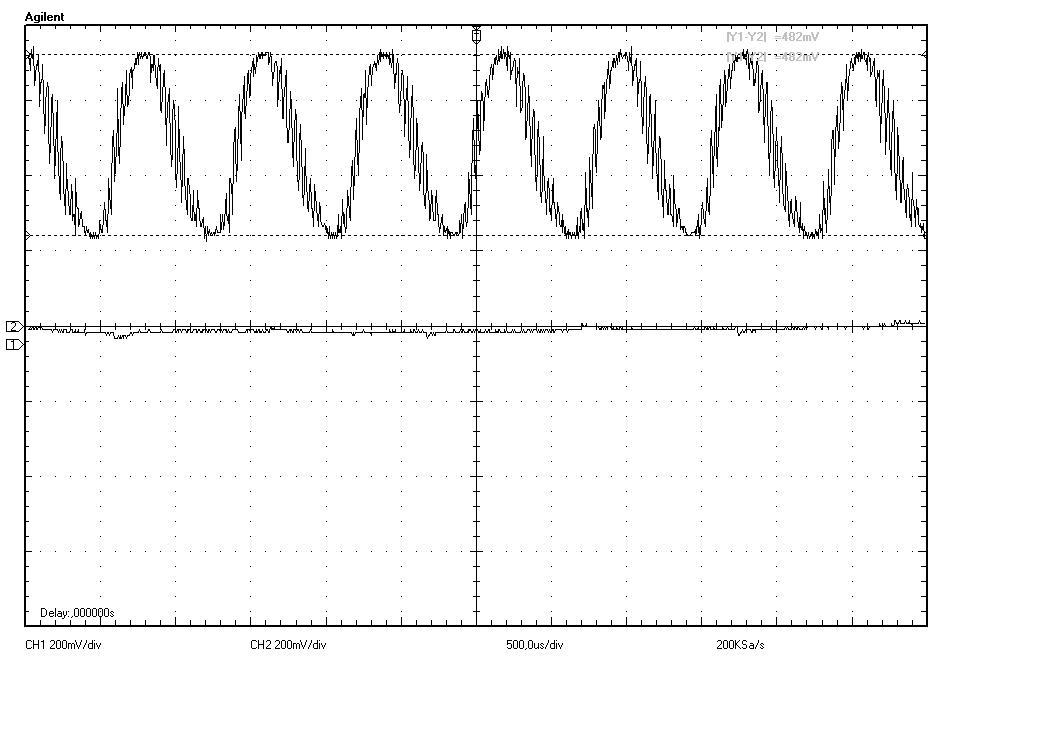
rapport/scope/sin1250HzVpp.bmp
