jorgenmk/avr-cansat/rapport/scope/sin1250HzVppC.bmp

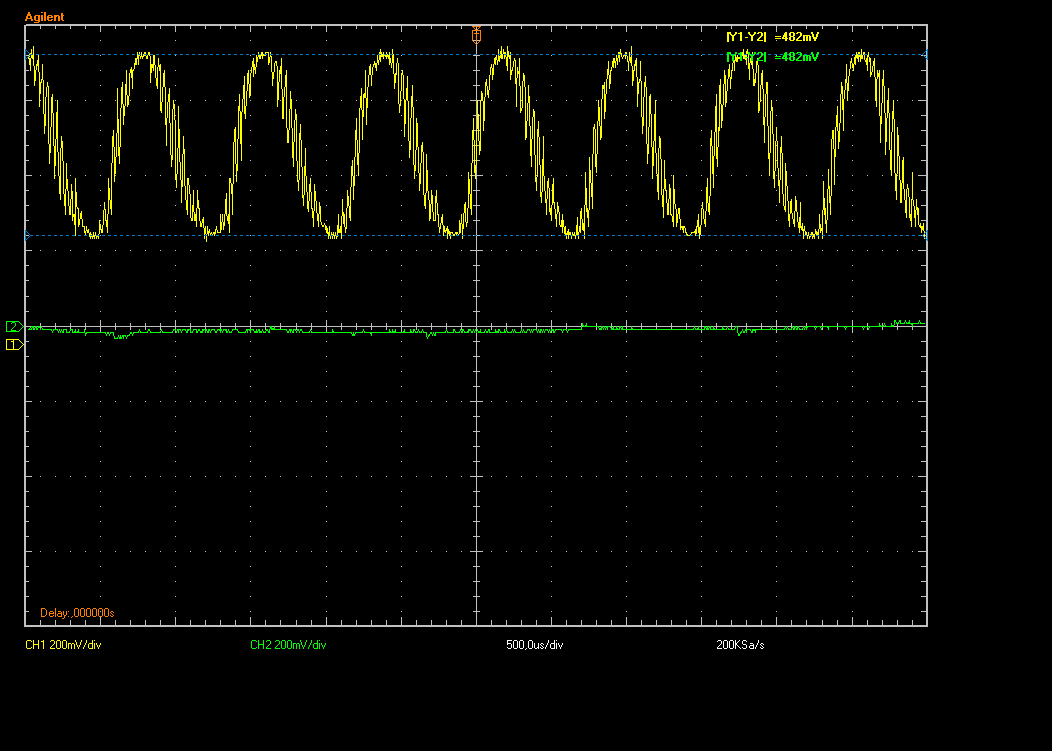
rapport/scope/sin1250HzVppC.bmp
