jorgenmk/avr-cansat/rapport/scope/sinCos1250Hz.bmp

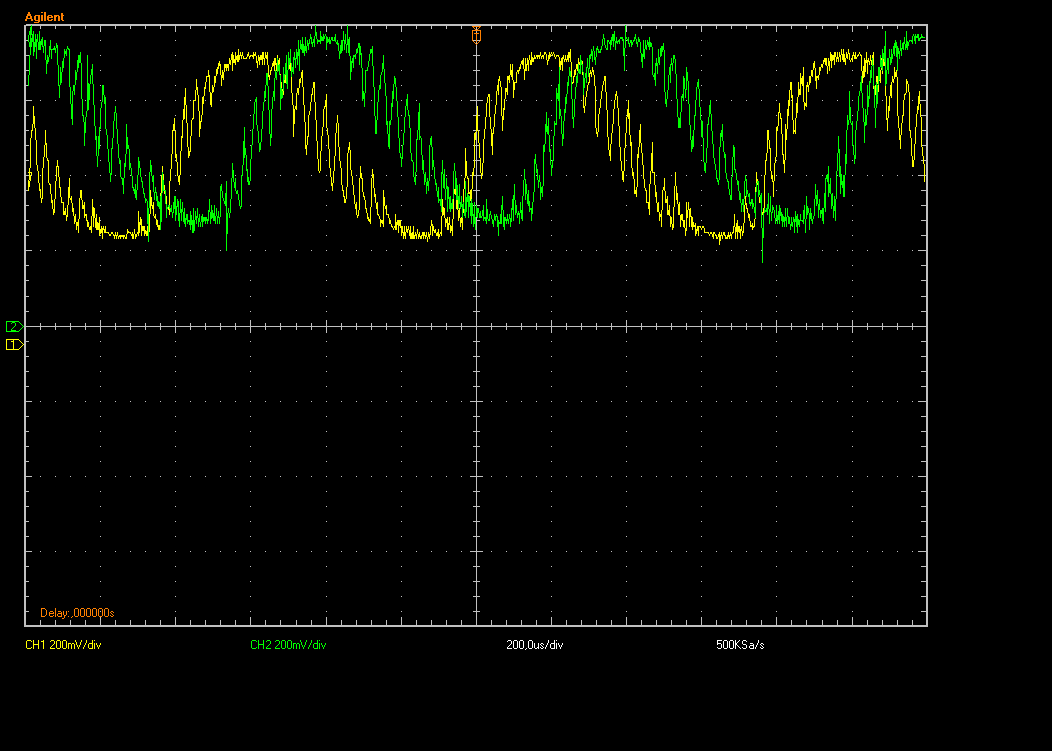
rapport/scope/sinCos1250Hz.bmp
