jorgenmk/avr-cansat/rapport/scope/sinCos1250HzTime2.bmp

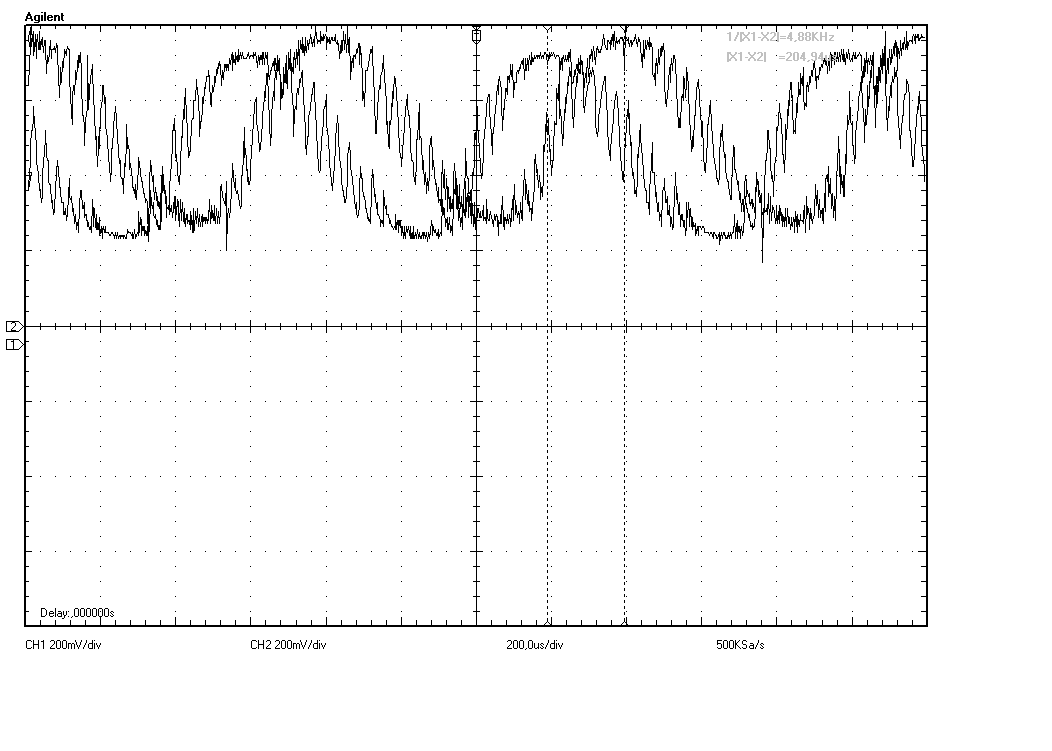
rapport/scope/sinCos1250HzTime2.bmp
