jorgenmk/avr-cansat/rapport/scope/sinCos1250HzZoom.bmp

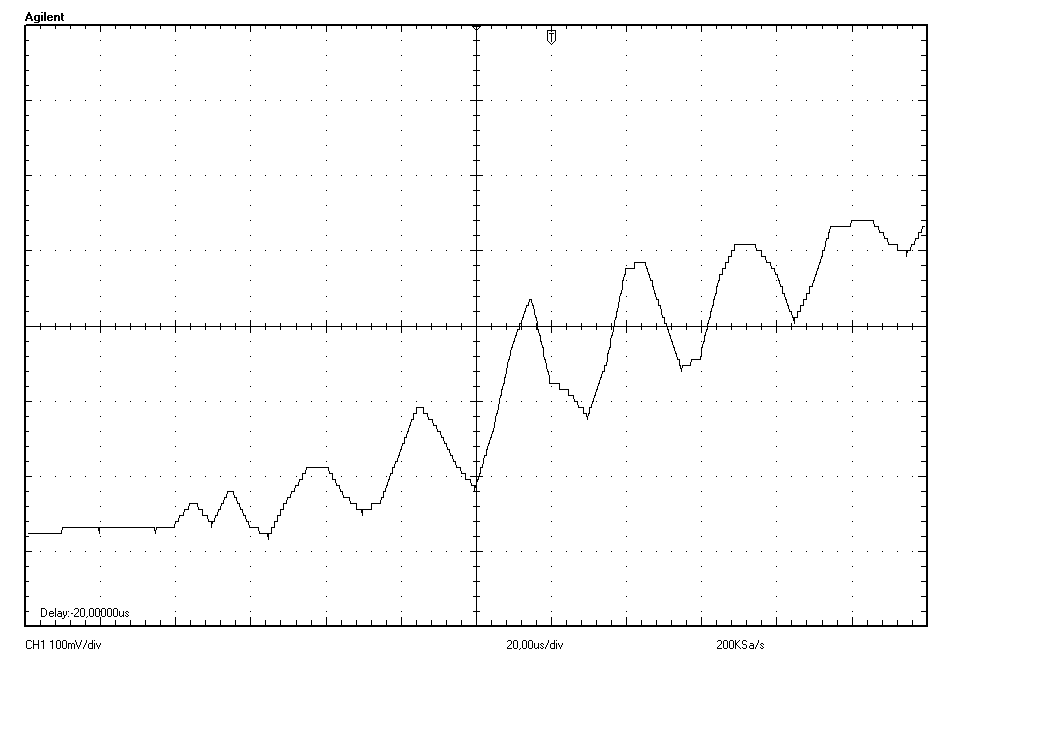
rapport/scope/sinCos1250HzZoom.bmp
