jorgenmk/avr-cansat/rapport/scope/sinus1250Hz.bmp

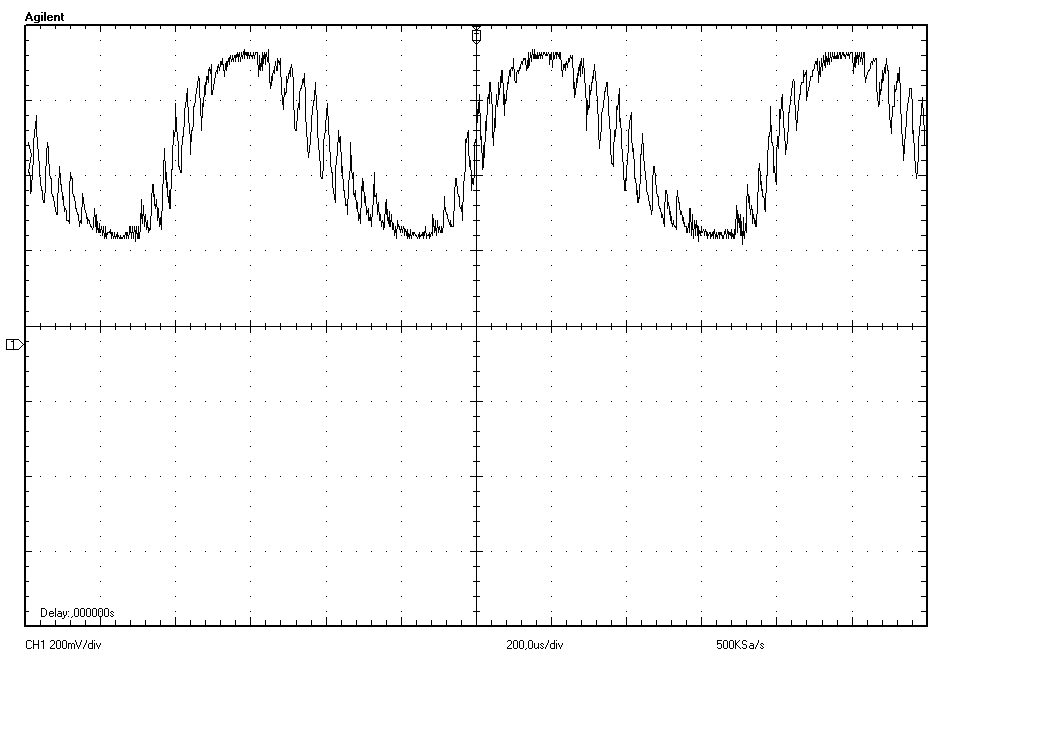
rapport/scope/sinus1250Hz.bmp
