jorgenmk/avr-cansat/rapport/scope/sinus1250HzDiff.bmp

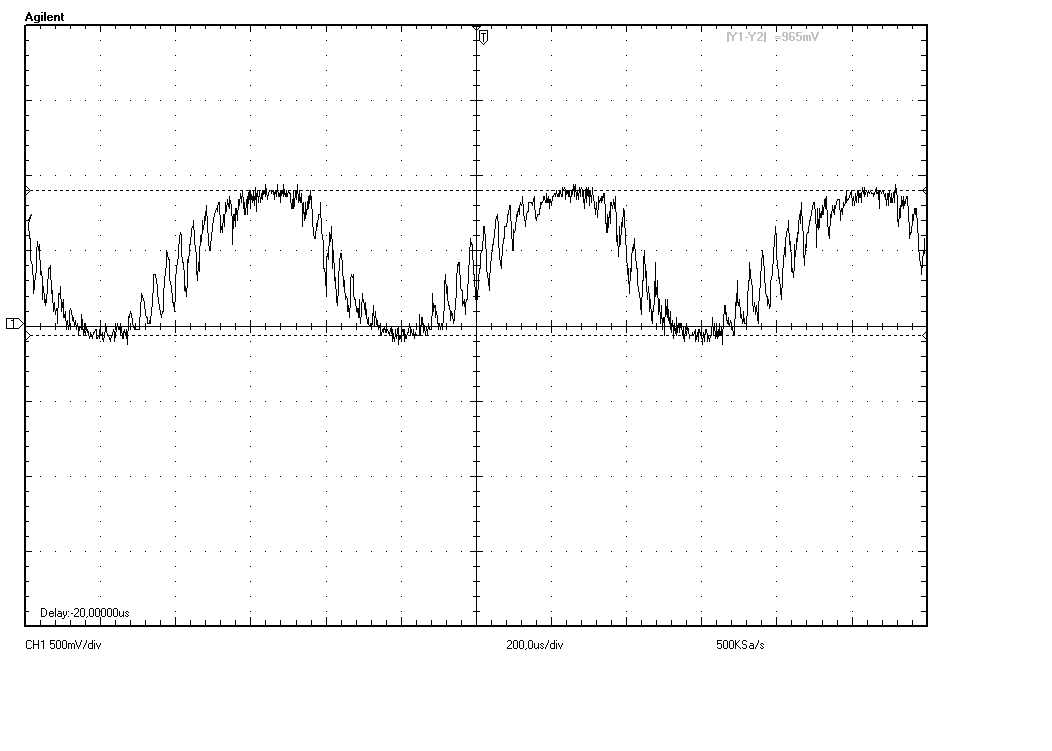
rapport/scope/sinus1250HzDiff.bmp
