jorgenmk/avr-cansat/rapport/spektrum/P130509_12.11.jpg

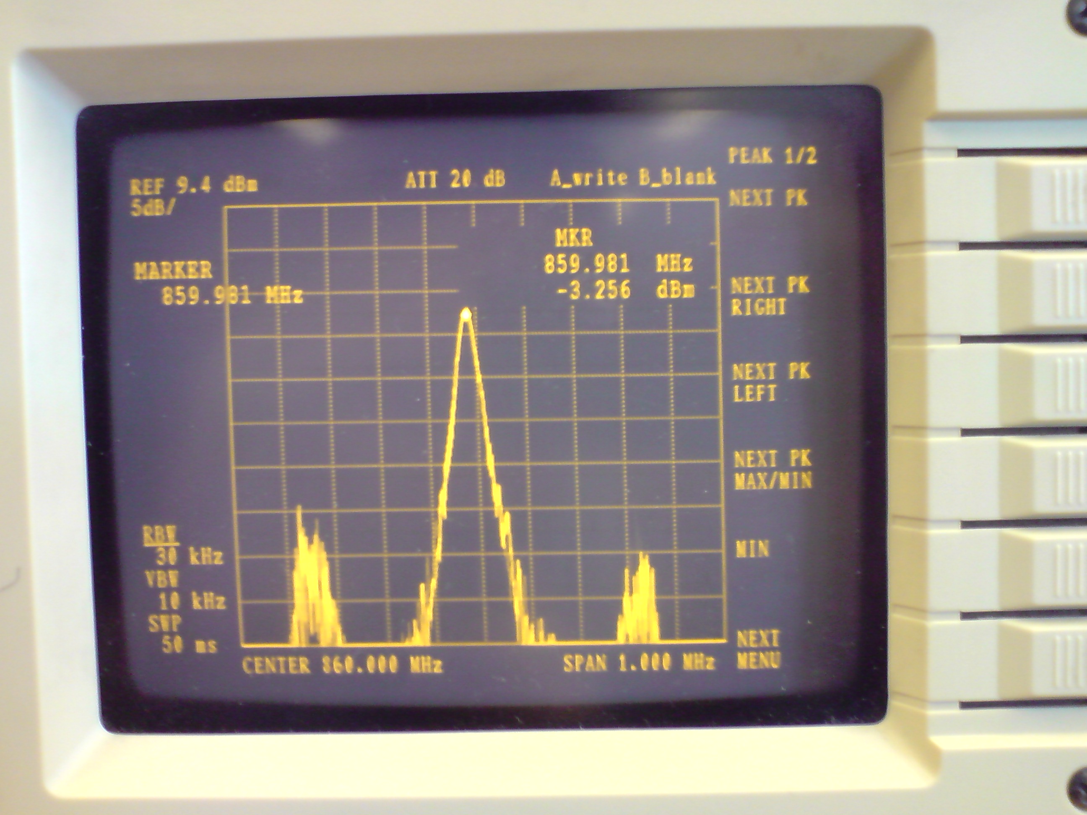
rapport/spektrum/P130509_12.11.jpg
