jorgenmk/avr-cansat/rapport/spektrum/P130509_12.55.jpg

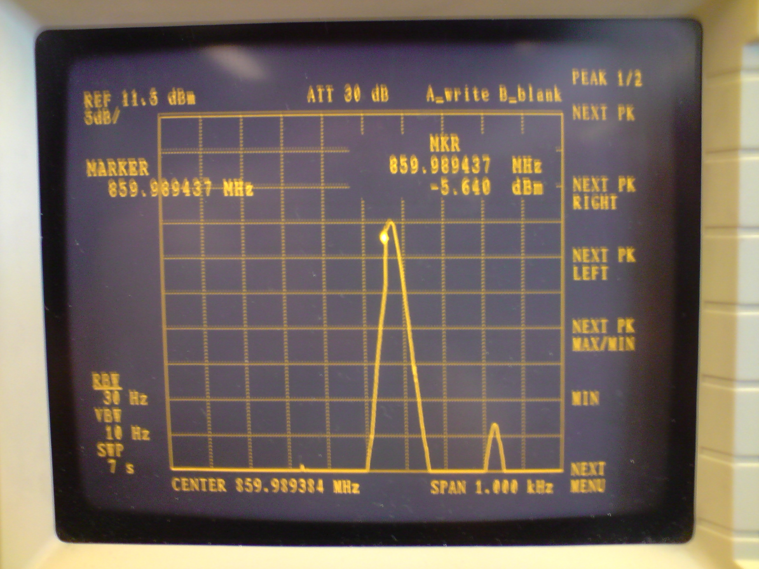
rapport/spektrum/P130509_12.55.jpg
