jorgenmk/avr-cansat/rapport/spektrum/P130509_12.57.jpg

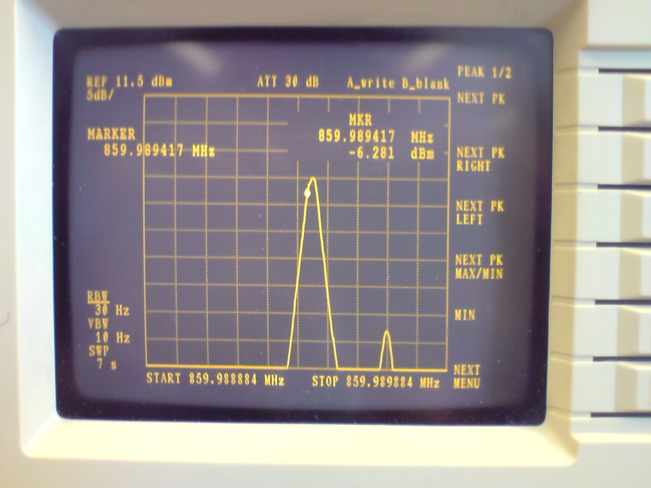
rapport/spektrum/P130509_12.57.jpg
