jorgenmk/avr-cansat/rapport/spektrum/P130509_12.58.jpg

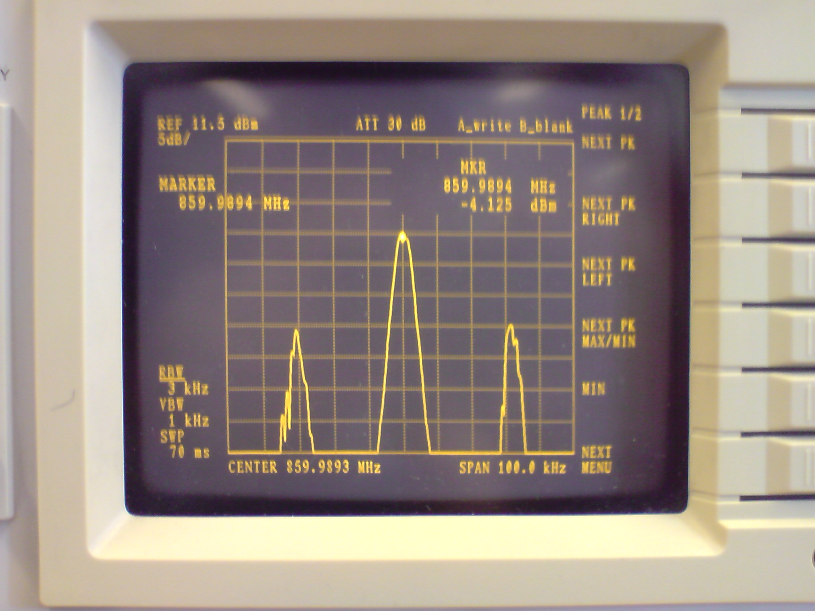
rapport/spektrum/P130509_12.58.jpg
