jorgenmk/avr-cansat/rapport/spektrum/P130509_13.00.jpg

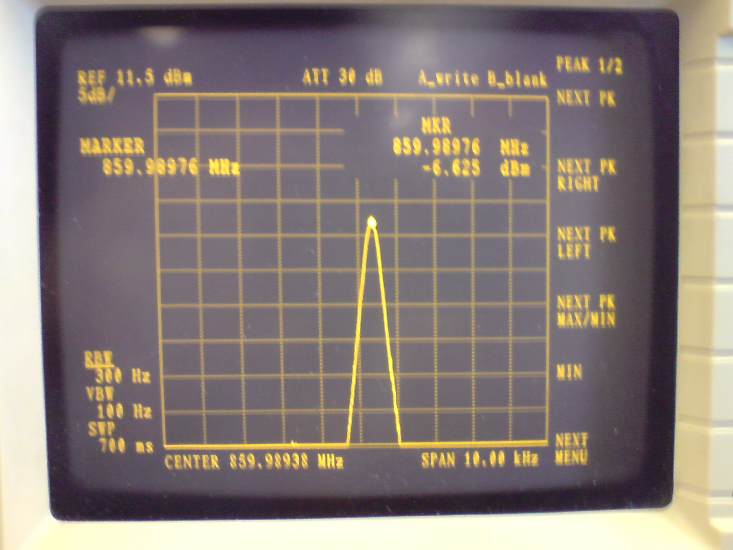
rapport/spektrum/P130509_13.00.jpg
