jorgenmk/avr-cansat/rapport/spektrum/P130509_13.00[01].jpg

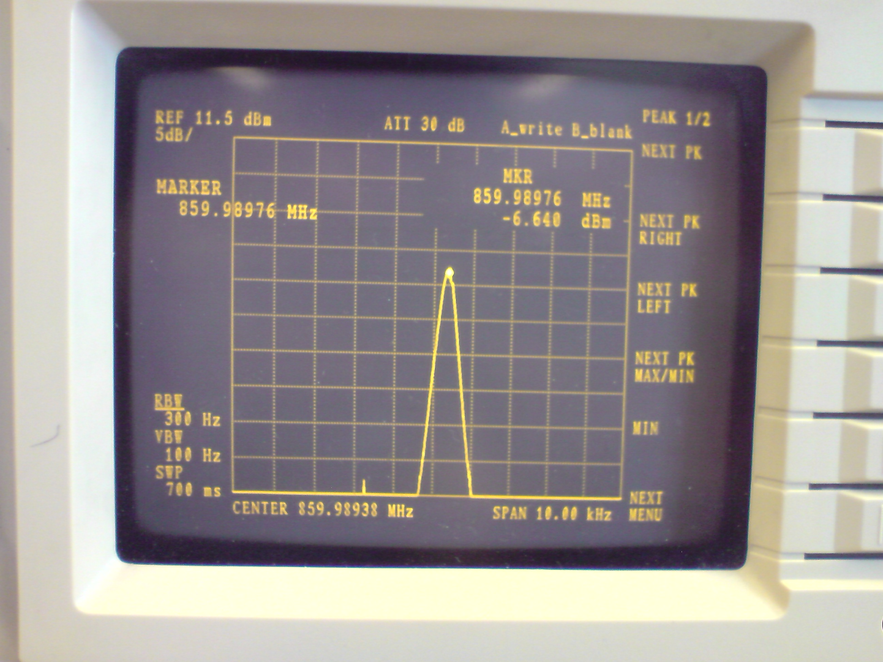
rapport/spektrum/P130509_13.00[01].jpg
