jorgenmk/avr-cansat/rapport/spektrum/P130509_15.41[01].jpg

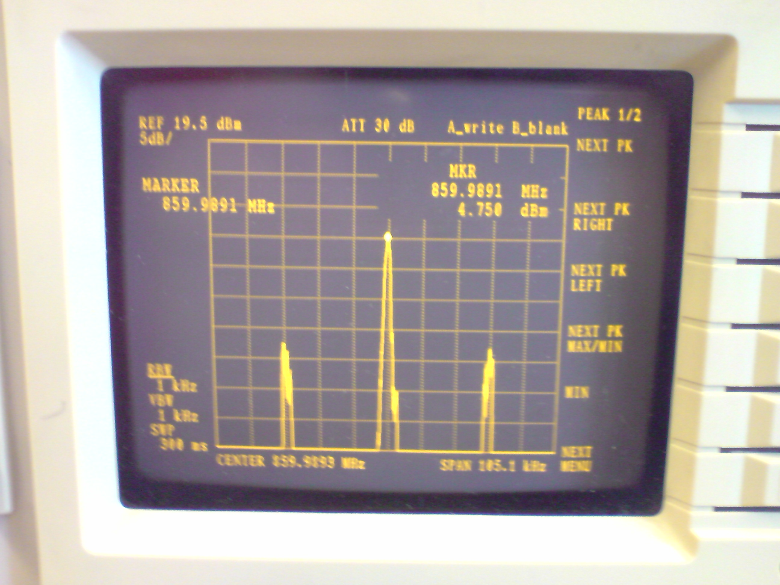
rapport/spektrum/P130509_15.41[01].jpg
