jorgenmk/avr-cansat/rapport/spektrum/P130509_15.44.JPG

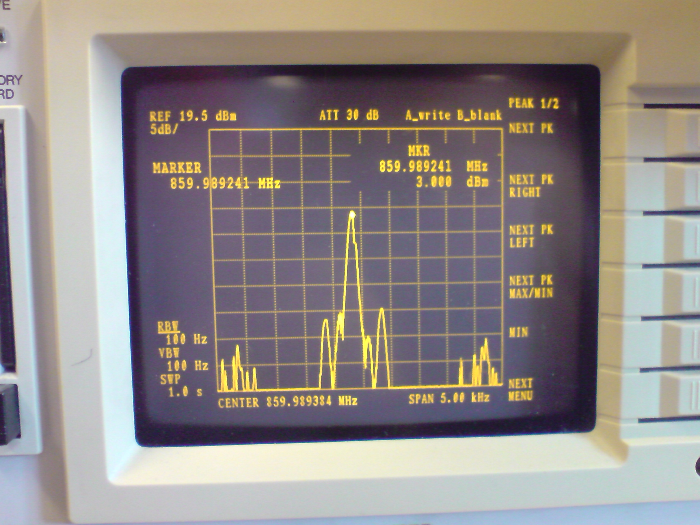
rapport/spektrum/P130509_15.44.JPG
