jorgenmk/avr-cansat/rapport/GPS-kort-skjema.pdf

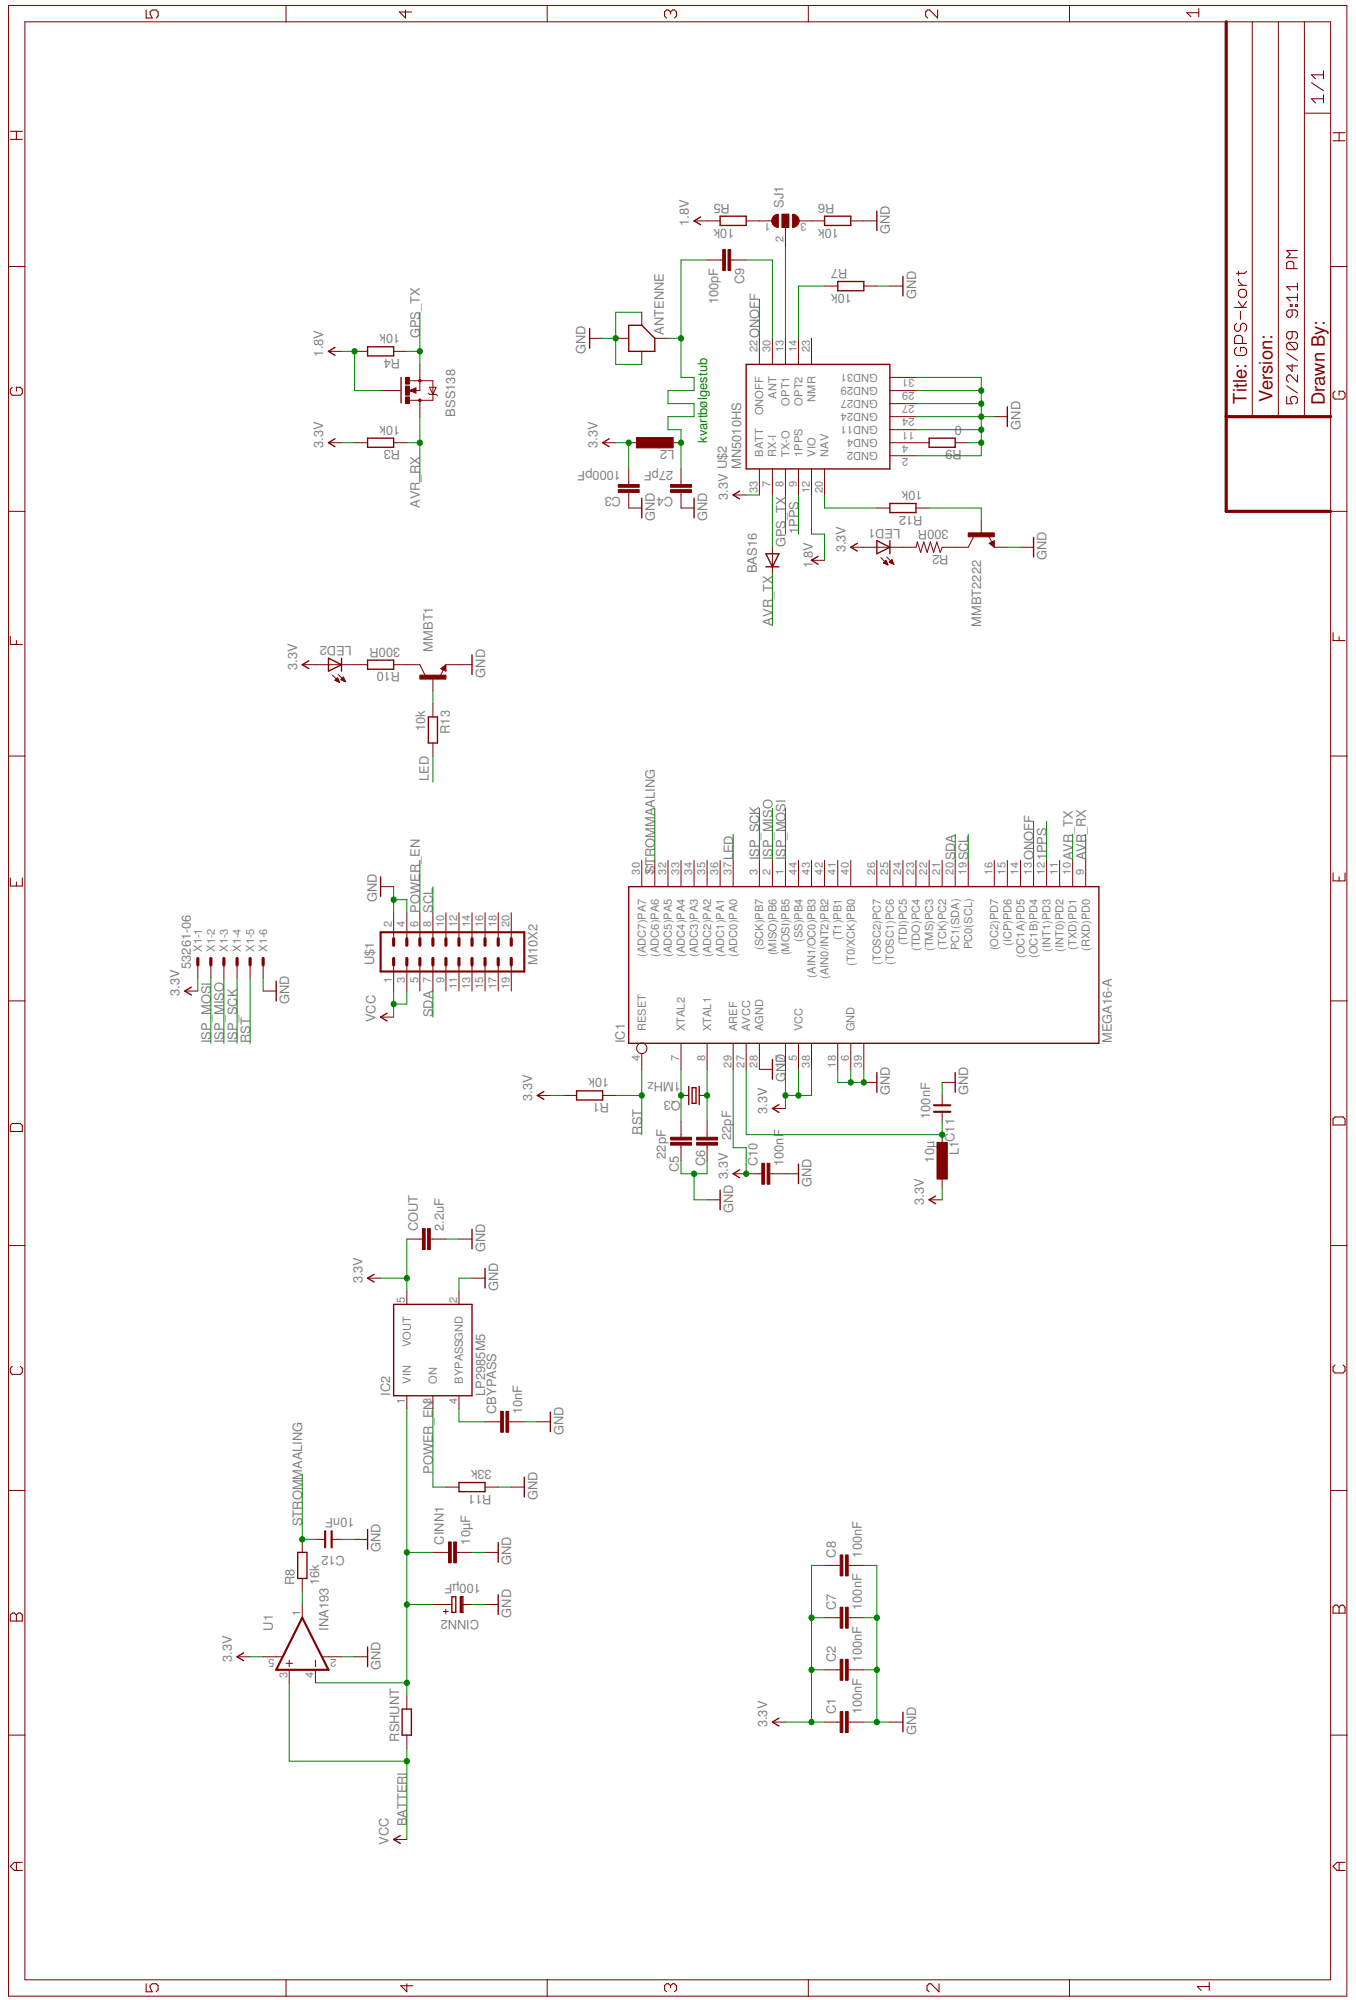
[picture p83: page 1]

MEGA16-A 100nF 100nF 3.3V GND GND GNk01 D MN5010HS 1.8V R003 k01 k01 k01 k01k01 1.8V GND GND 3.3V 0 3.3V 1.8V GND 3.3V GND 3.3V 3.3V GND z HM1 22pF22pF GND M10X2 3.3VR003 GND 100nF 100nF INA193 LP2985M5 GND GND 10µF Fµ001 GND GND 10nF GND 2.2uF GND GNDk33 3.3V VCC 3.3V VCGCND 3.3V53261-06 GND 3.3V Fp0001 Fp72 100pF GND GND 3.3V100nF GND10µ 100nF 3.3V GND 16k Fn01 GND k01 10k (ADC7)PA7 30 (ADC6)PA6 31 (ADC5)PA5 32 (ADC4)PA4 33 (ADC3)PA3 34 (ADC2)PA2 35 (ADC1)PA1 36 (ADC0)PA0 37 (SCK)PB7 3 (MISO)PB6 2 (MOSI)PB5 1 (SS)PB4 44 (AIN1/OC0)PB3 43 (AIN0/INT2)PB2 42 (T1)PB1 41 (T0/XCK)PB0 40 (TOSC2)PC7 26 (TOSC1)PC6 25 (TDI)PC5 24 (TDO)PC4 23 (TMS)PC3 22 (TCK)PC2 21 PC1(SDA) 20 PC0(SCL) 19 AGND 28 AVCC 27 AREF 29 XTAL1 8 XTAL2 71839 RESET 4 (RXD)PD0 9 (TXD)PD1 10 (INT0)PD2 11 (INT1)PD3 12 (OC1B)PD4 13 (OC1A)PD5 14 (ICP)PD6 15 (OC2)PD7 16 IC1 17 VCC 538 GND 6 C1 C2 1 R 1PPS 9 ANT 30 BATT 33 2 DNG 2 11 DNG 11 42 DNG 42 72 DNG 72 92 DNG 92 13 DNG 13 NAV 20 NMR 23 ONOFF 22 OPT1 13 OPT2 14 RX-I 7 TX-O 8 VIO 12 U$2 4 DNG 4 BSS138 MMBT2222 2 R 1 DEL 3 R4 R 1 3 SJ1 2 5 R 6 R7 R 9 R BAS16 3 QC5C6 1 2 3 4 5 U$1 6 7 8 9 10 11 12 13 14 15 16 17 18 19 20 2 DEL 01 R MMBT1 C7 C8 34 1 U1 5 2 VIN 1 ON 3 BYPASS 4 VOUT 5 GND 2 IC2 RSHUNT CINN1 2 NNI C CBYPASS COUT 11 R X1-1 X1-2 X1-3 X1-4 X1-5 X1-6 3 C 4 C C9 2L C10L1C11 R8 21 C 21 R R13 SCL SCL SDA SDA ONOFF ONOFF 1PPS 1PPS POWER_EN POWER_EN STROMMAALING STROMMAALING LED LED ISP_MISO ISP_MISO ISP_MOSI ISP_MOSI ISP_SCK ISP_SCK RST RST ANTENNE BATTERI AVR_RX AVR_RX AVR_TX AVR_TX GPS_TX GPS_TX Drawn By: Title: Version: kvartbølgestub
