jorgenmk/avr-cansat/rapport/hovedkort skjema.pdf

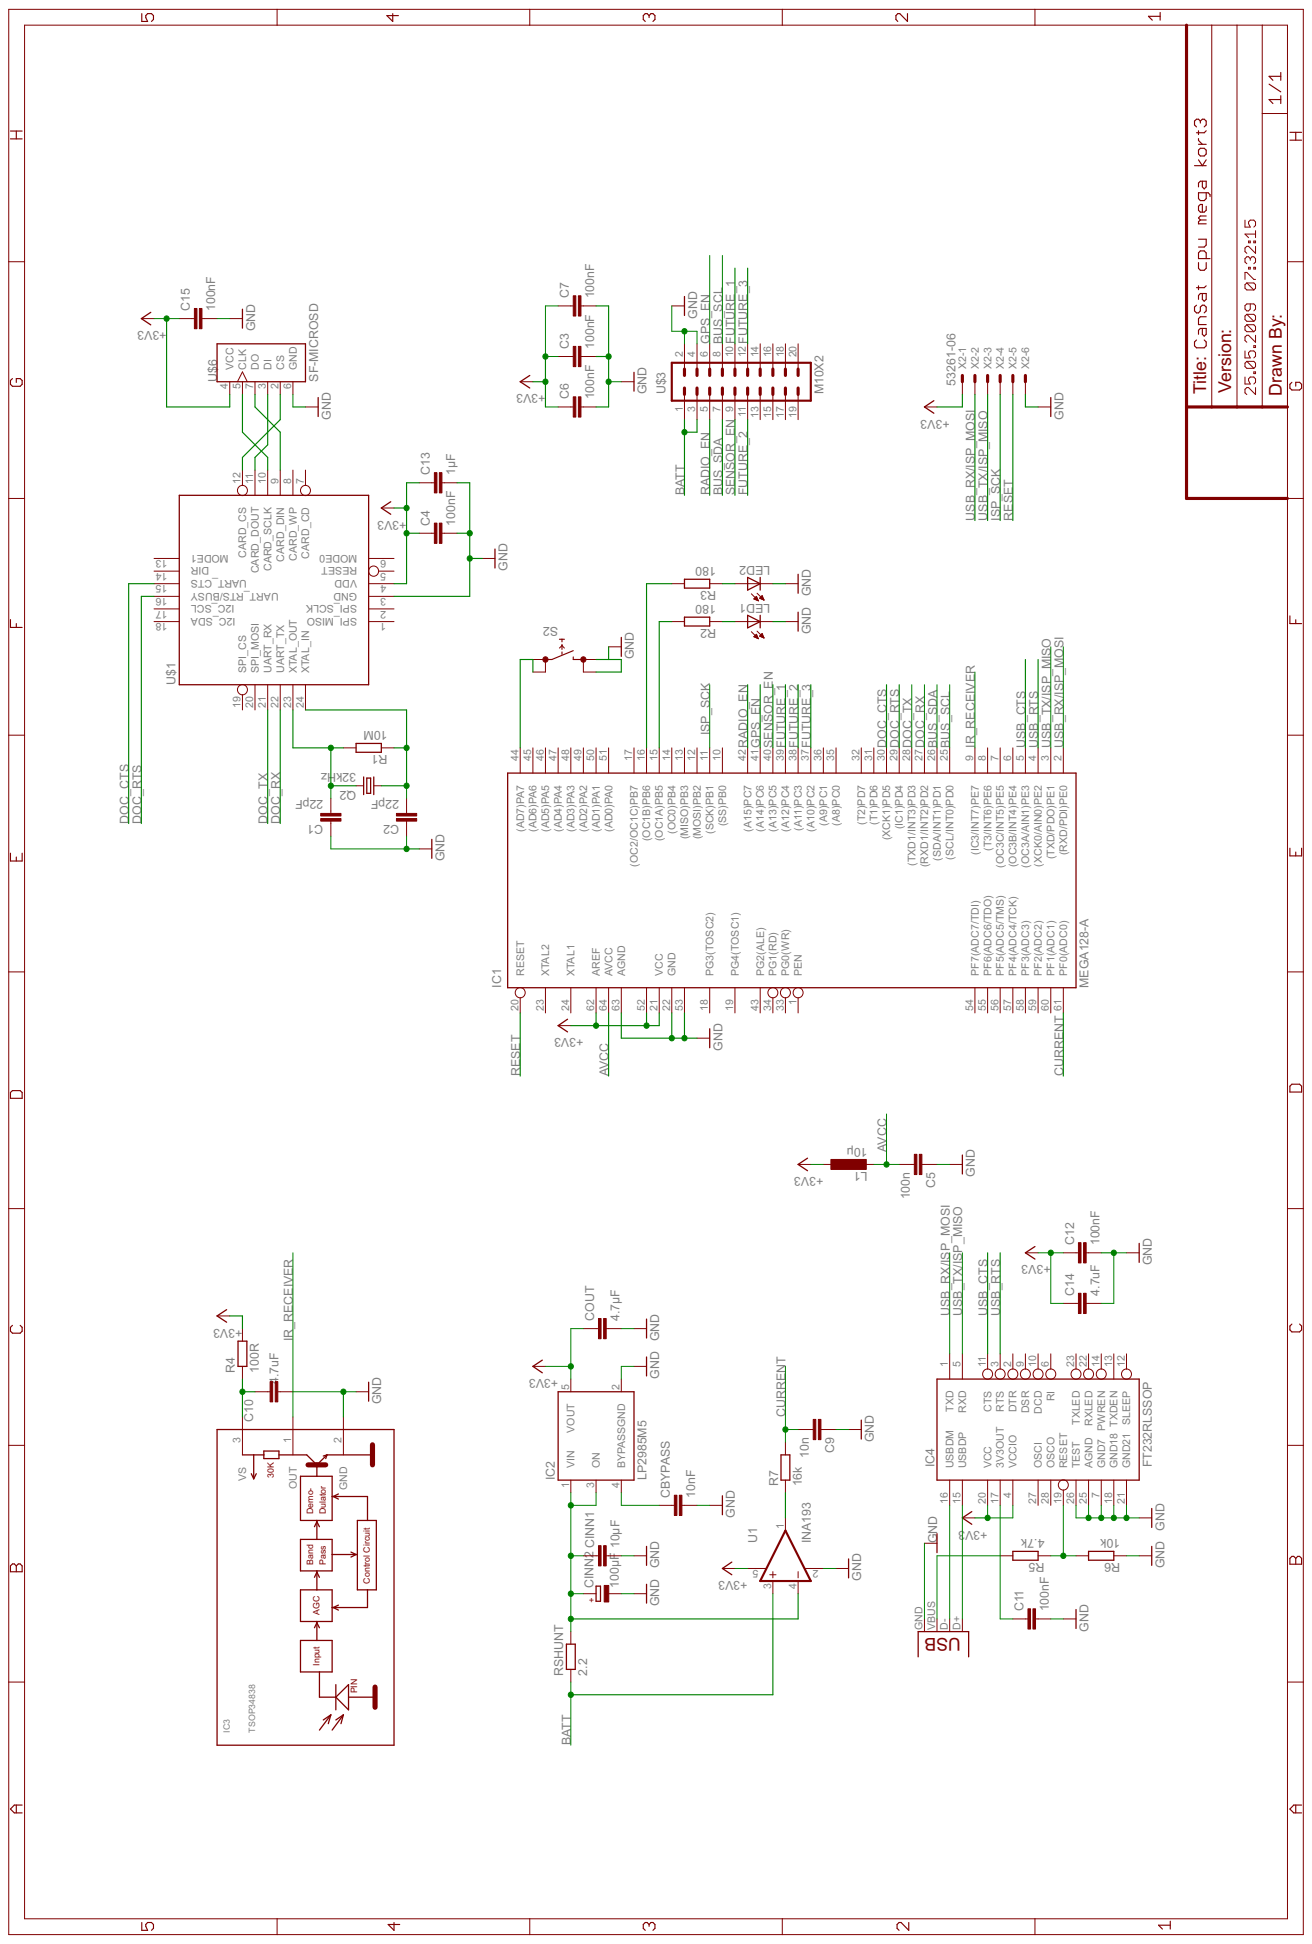
[picture p84: page 1]

Drawn By: Title: Version:

PF0(ADC0) 61 PF1(ADC1) 60 PF2(ADC2) 59 PF3(ADC3) 58 PF4(ADC4/TCK) 57 PF5(ADC5/TMS) 56 PF6(ADC6/TDO) 55 PF7(ADC7/TDI) 54

Band Pass Demo- Dulator Control Circuit
