jorgenmk/avr-cansat/rapport/sprangresponsRC-v2.pdf

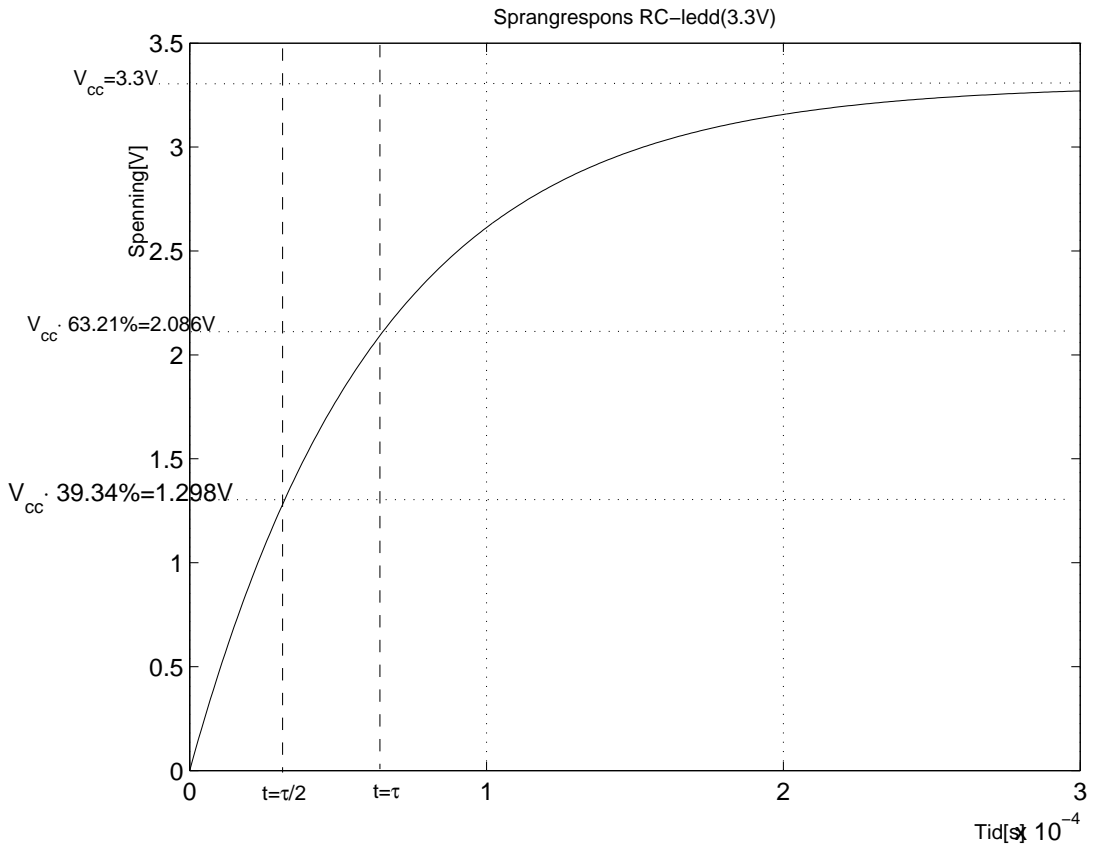
[picture p85: page 1]
Tid[s]; Spenning[V]; Vcc

Sprangrespons RC−ledd(3.3V)
