jorgenmk/avr-cansat/rapport/Hovedkort/shunt-measure-error.pdf

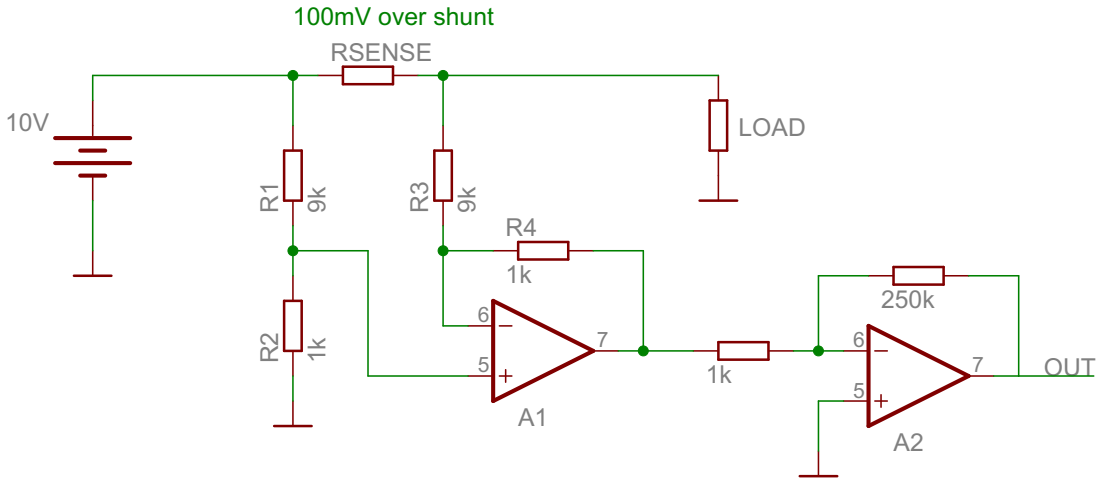
[picture p86: page 1]

1k 1k 9k 1k 9k 10V 250k LOAD A1 A2 56 7 56 7 R2 RSENSE R4 R1R3 OUT 100mV over shunt
