jorgenmk/avr-cansat/rapport/sensorkort/sprangrespons.pdf

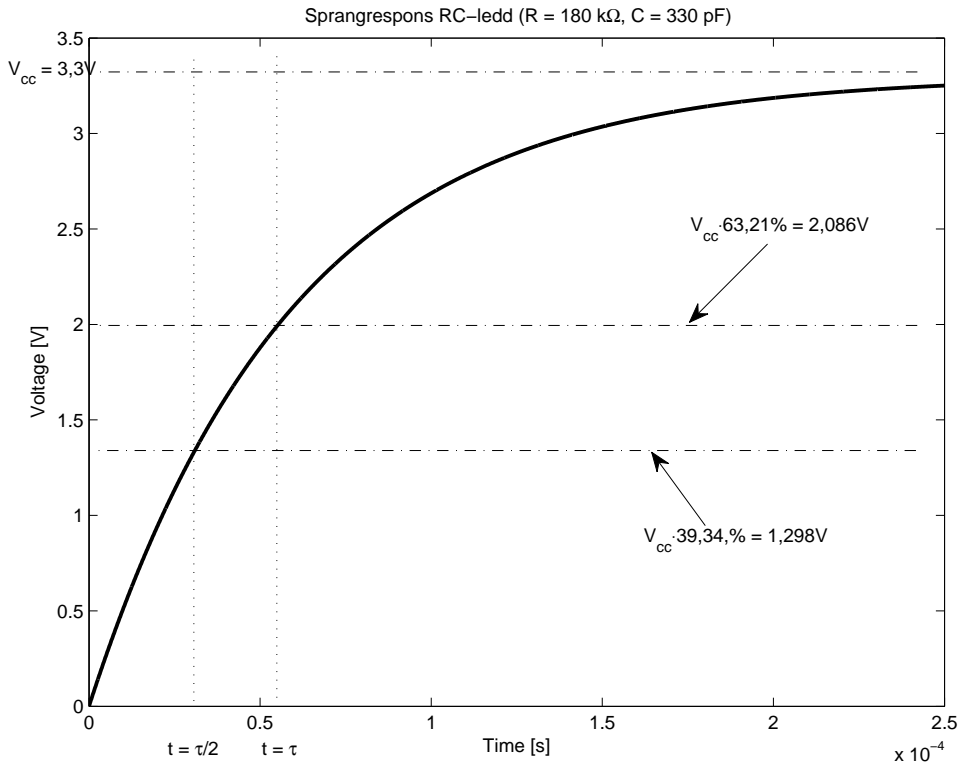
[picture p87: page 1]
Time [s]; Voltage [V]; Vcc

Sprangrespons RC−ledd (R = 180 kΩ, C = 330 pF)
