jorgenmk/avr-cansat/rapport/vedlegg/kretsutleggradiokort.pdf

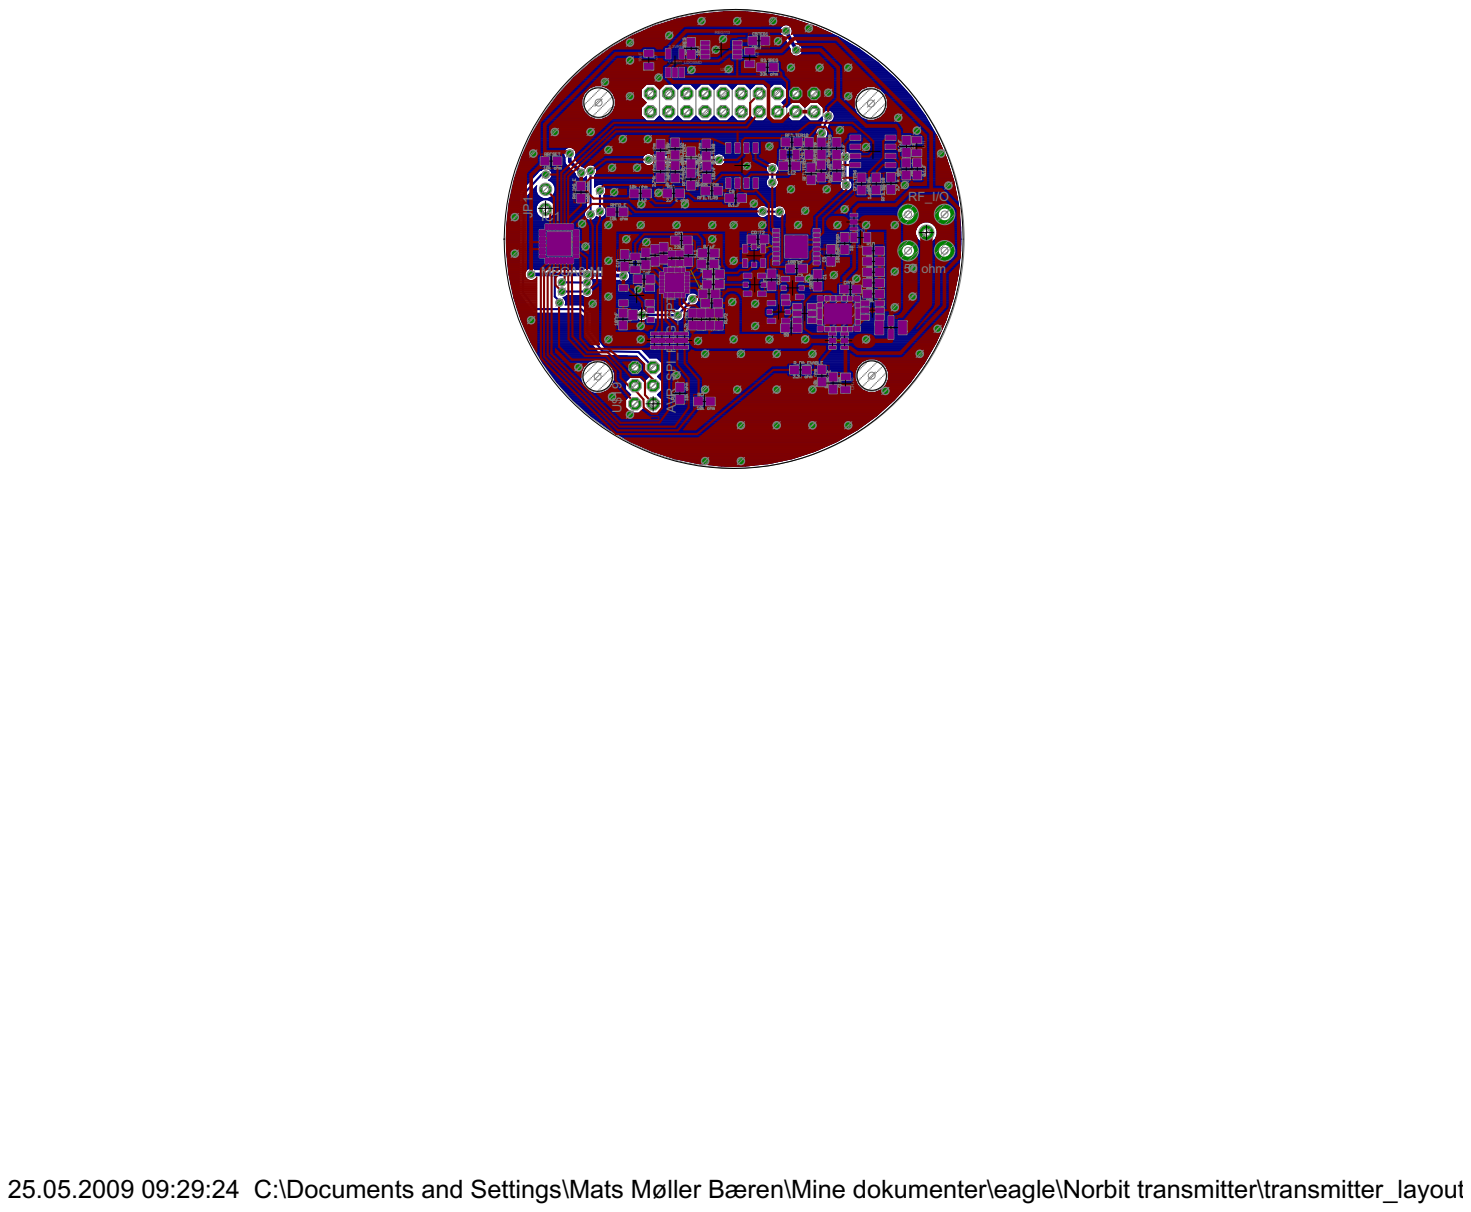
[picture p88: page 1]

2.2uF | 50 ohm

MEGA8-MI

25.05.2009 09:29:24 C:\Documents and Settings\Mats Møller Bæren\Mine dokumenter\eagle\Norbit transmitter\transmitter_layout_v2._mGND.brd
