jorgenmk/avr-cansat/rapport/ATMega16-sch.pdf

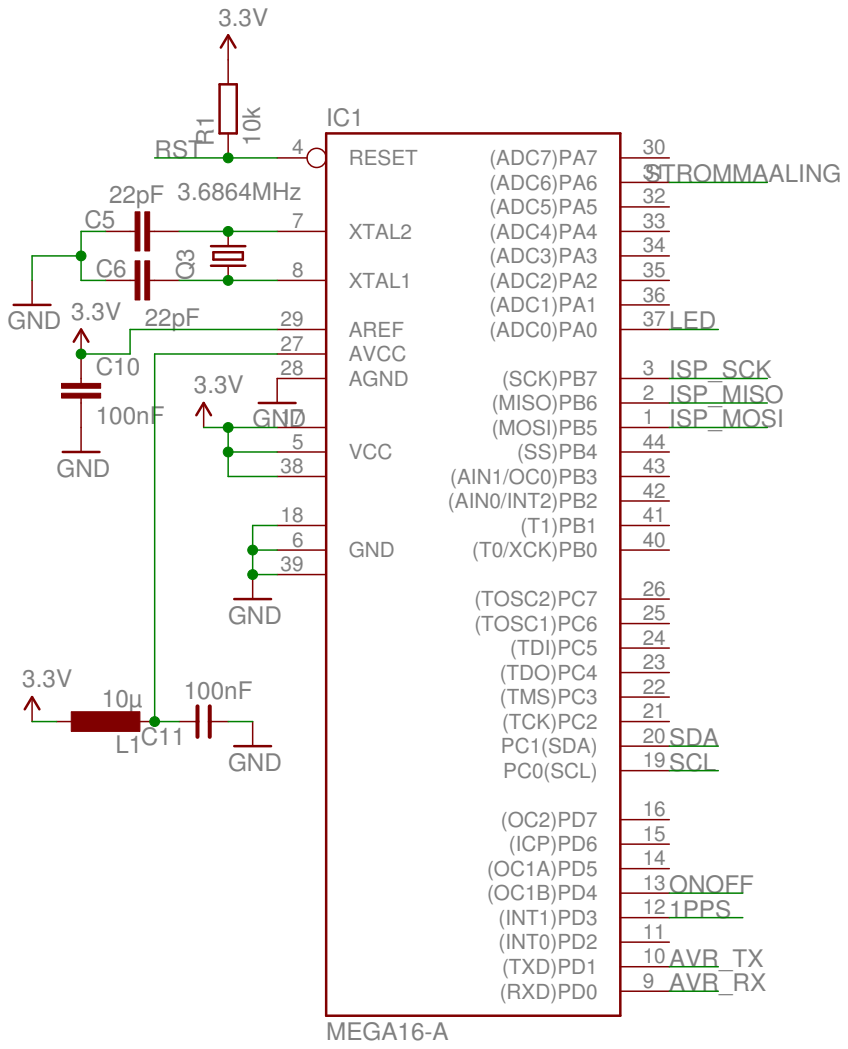
[picture p89: page 1]
