jorgenmk/avr-cansat/rapport/bias-tee.pdf

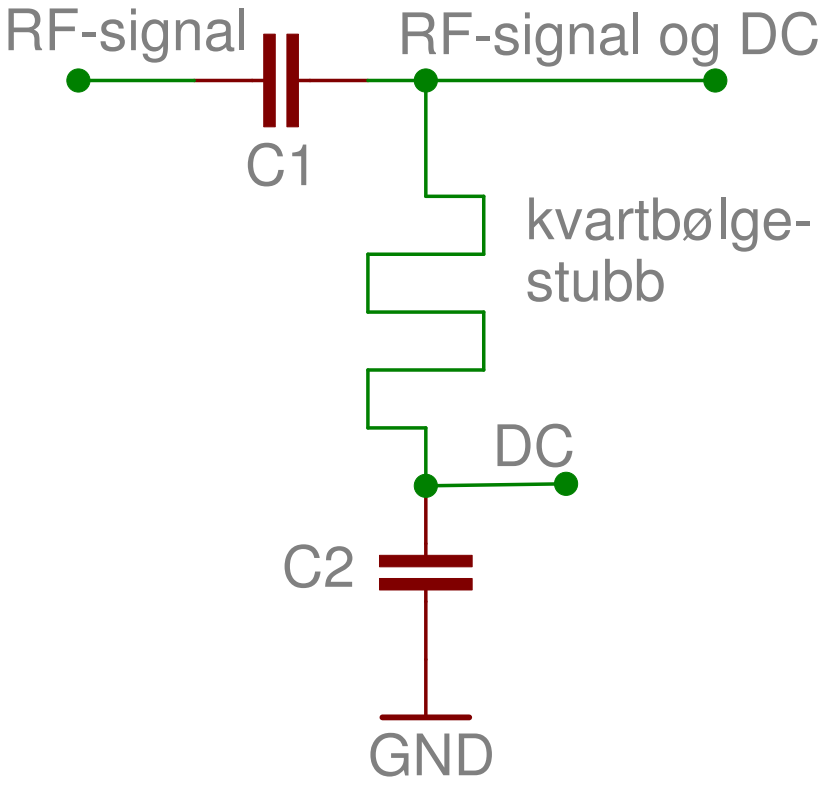
[picture p90: page 1]
