jorgenmk/avr-cansat/rapport/CanSat hoved skjema.pdf

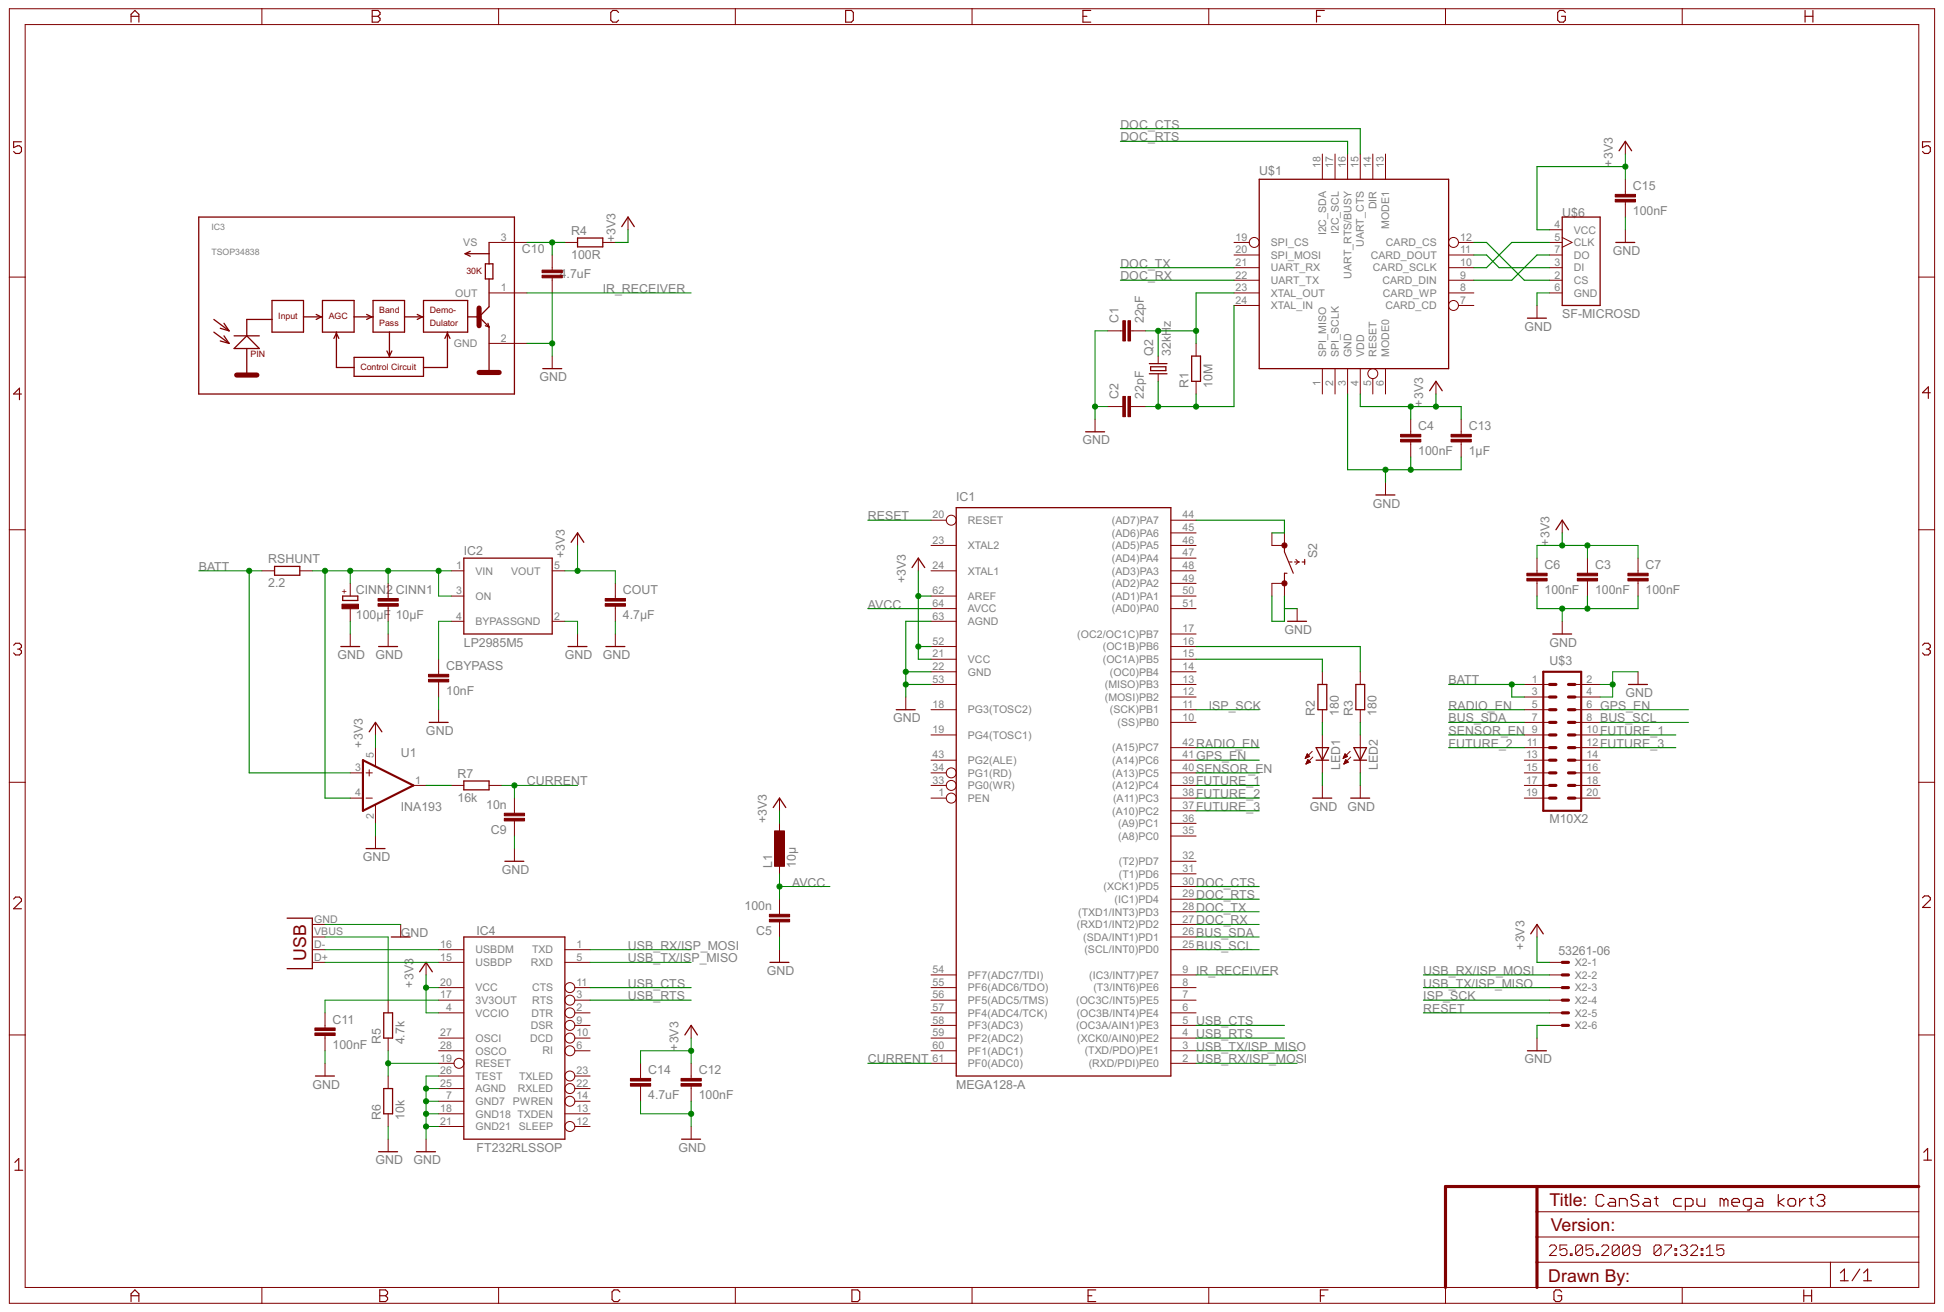
[picture p91: page 1]

Drawn By: Title: Version:
