jorgenmk/avr-cansat/rapport/CanSat hoved utlegg.pdf

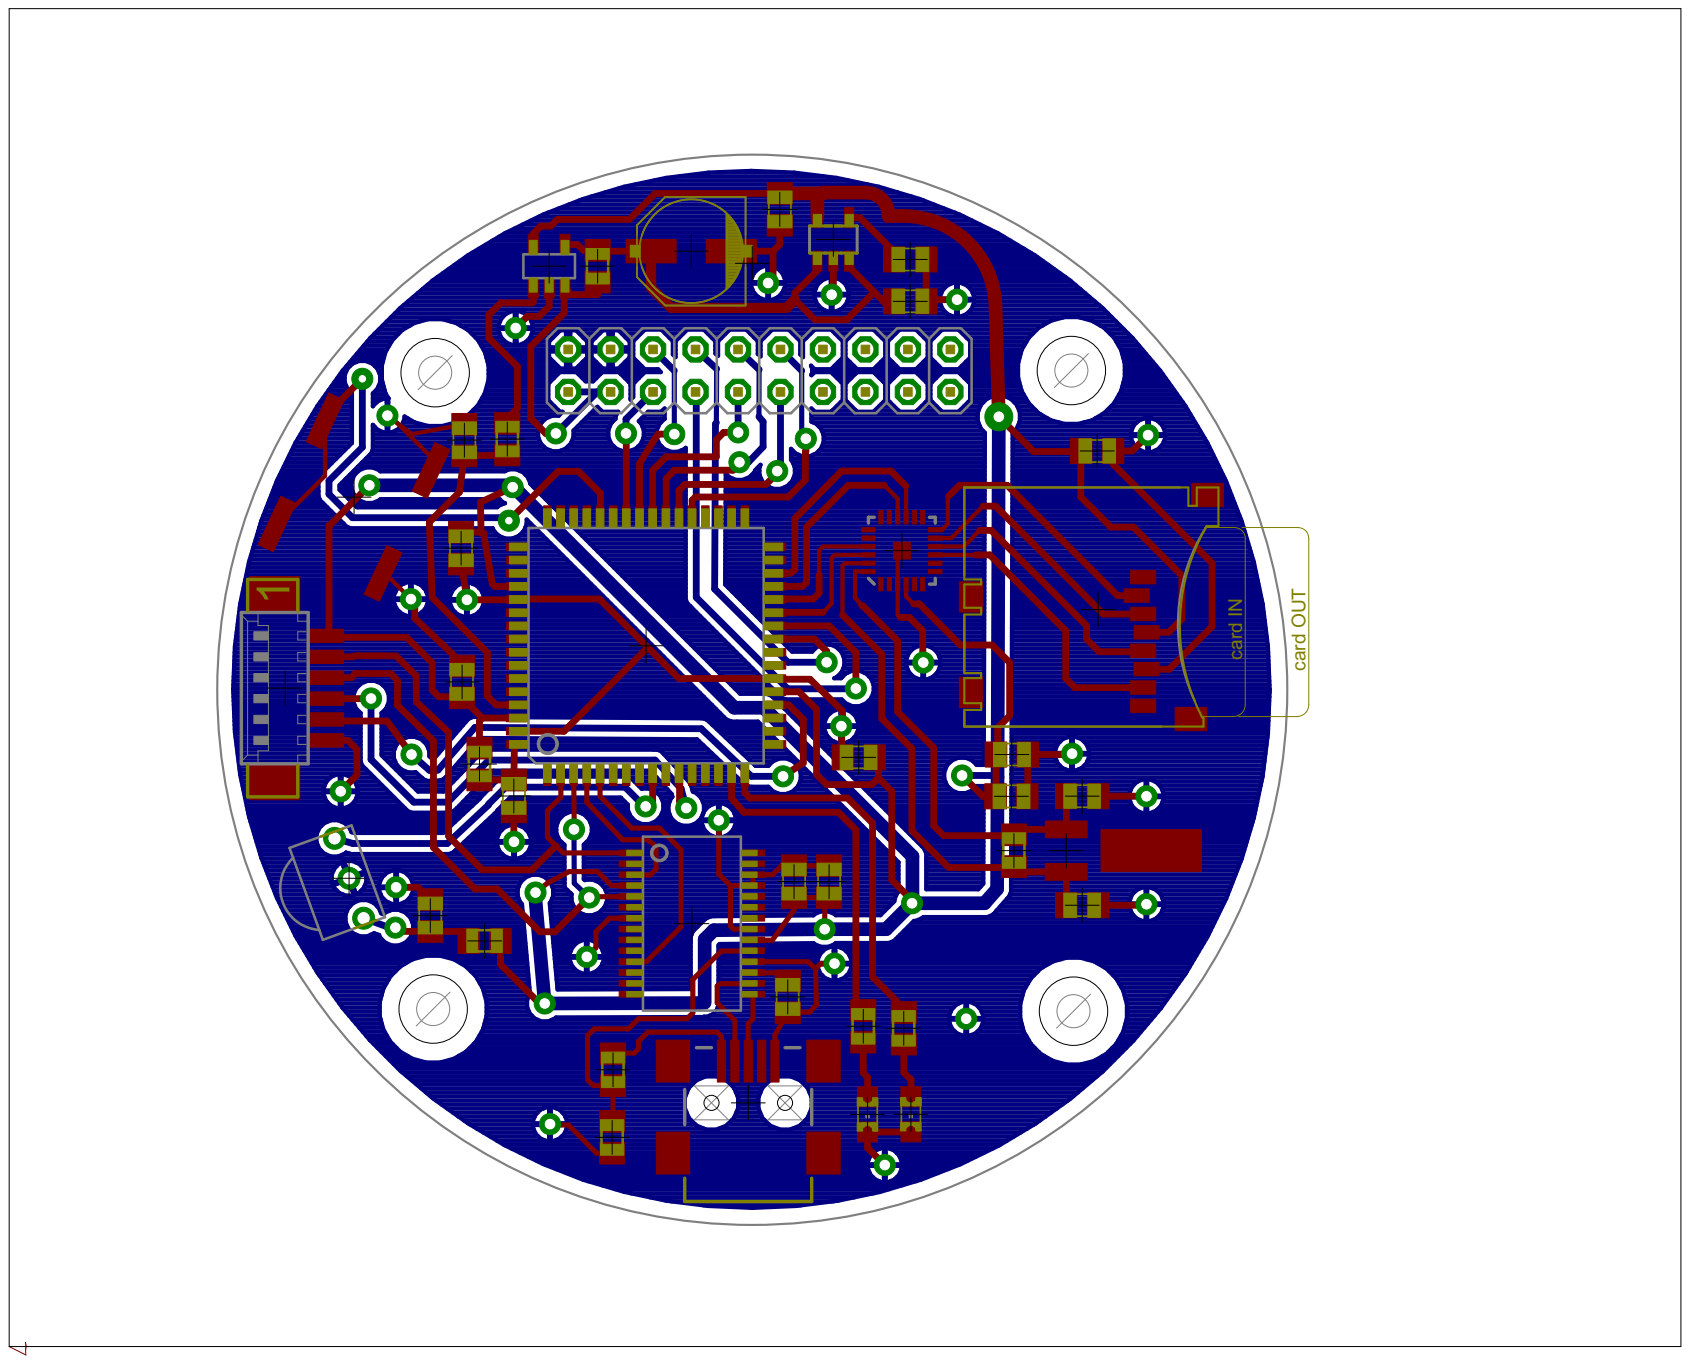
[picture p92: page 1]
