jorgenmk/avr-cansat/rapport/CanSat xbee skjema.pdf

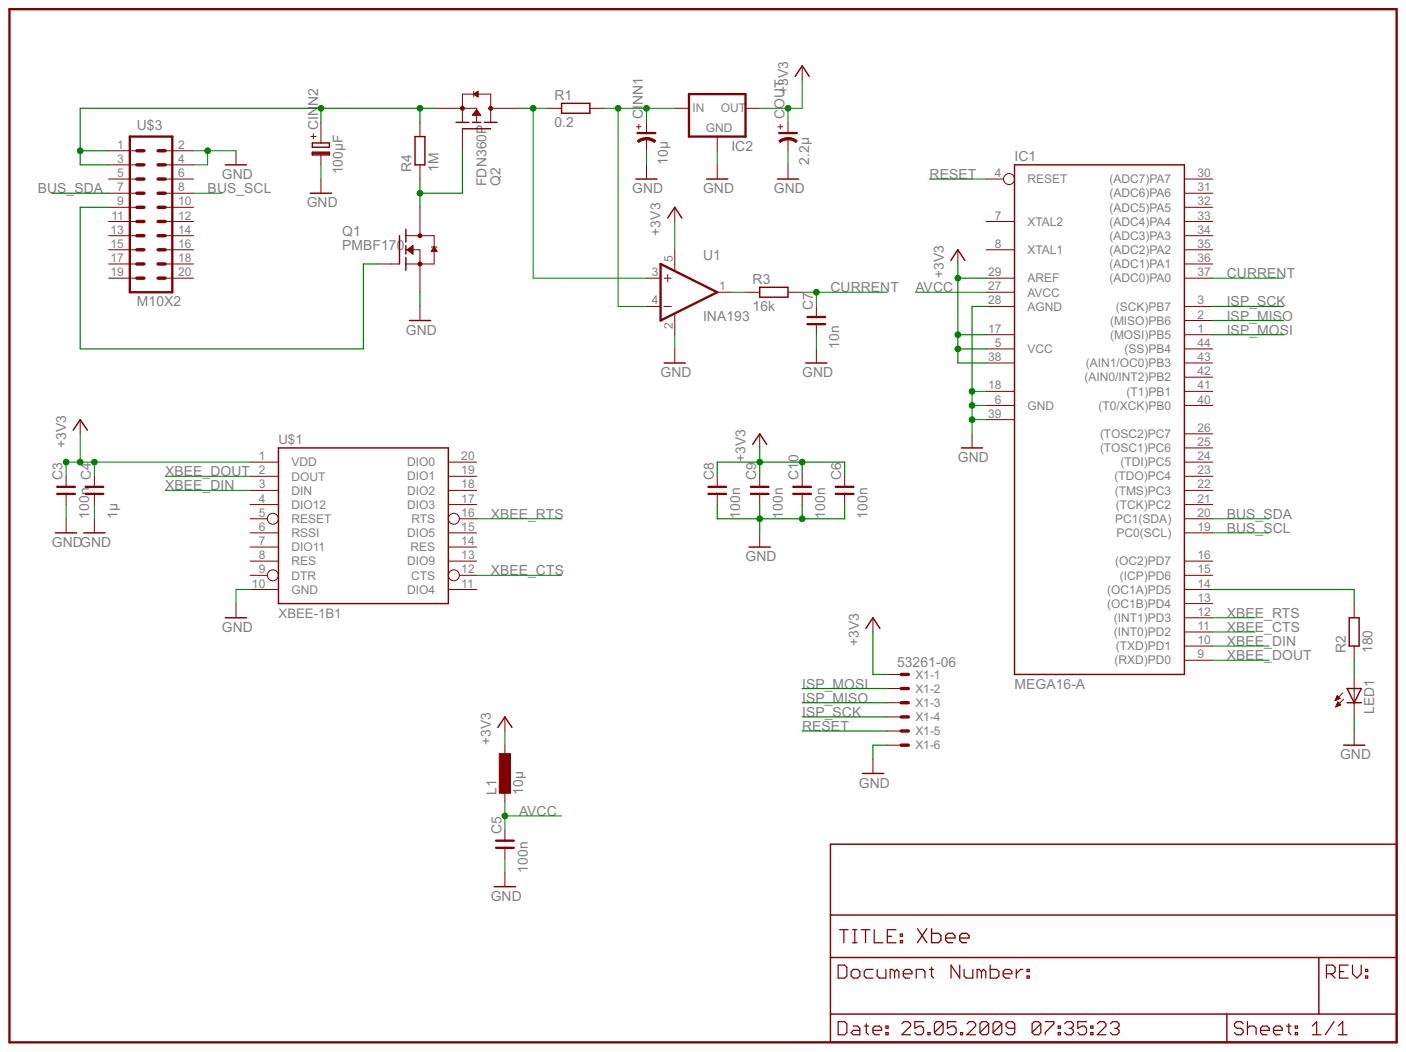
[picture p93: page 1]

38
