jorgenmk/avr-cansat/rapport/CanSat xbee utlegg.pdf

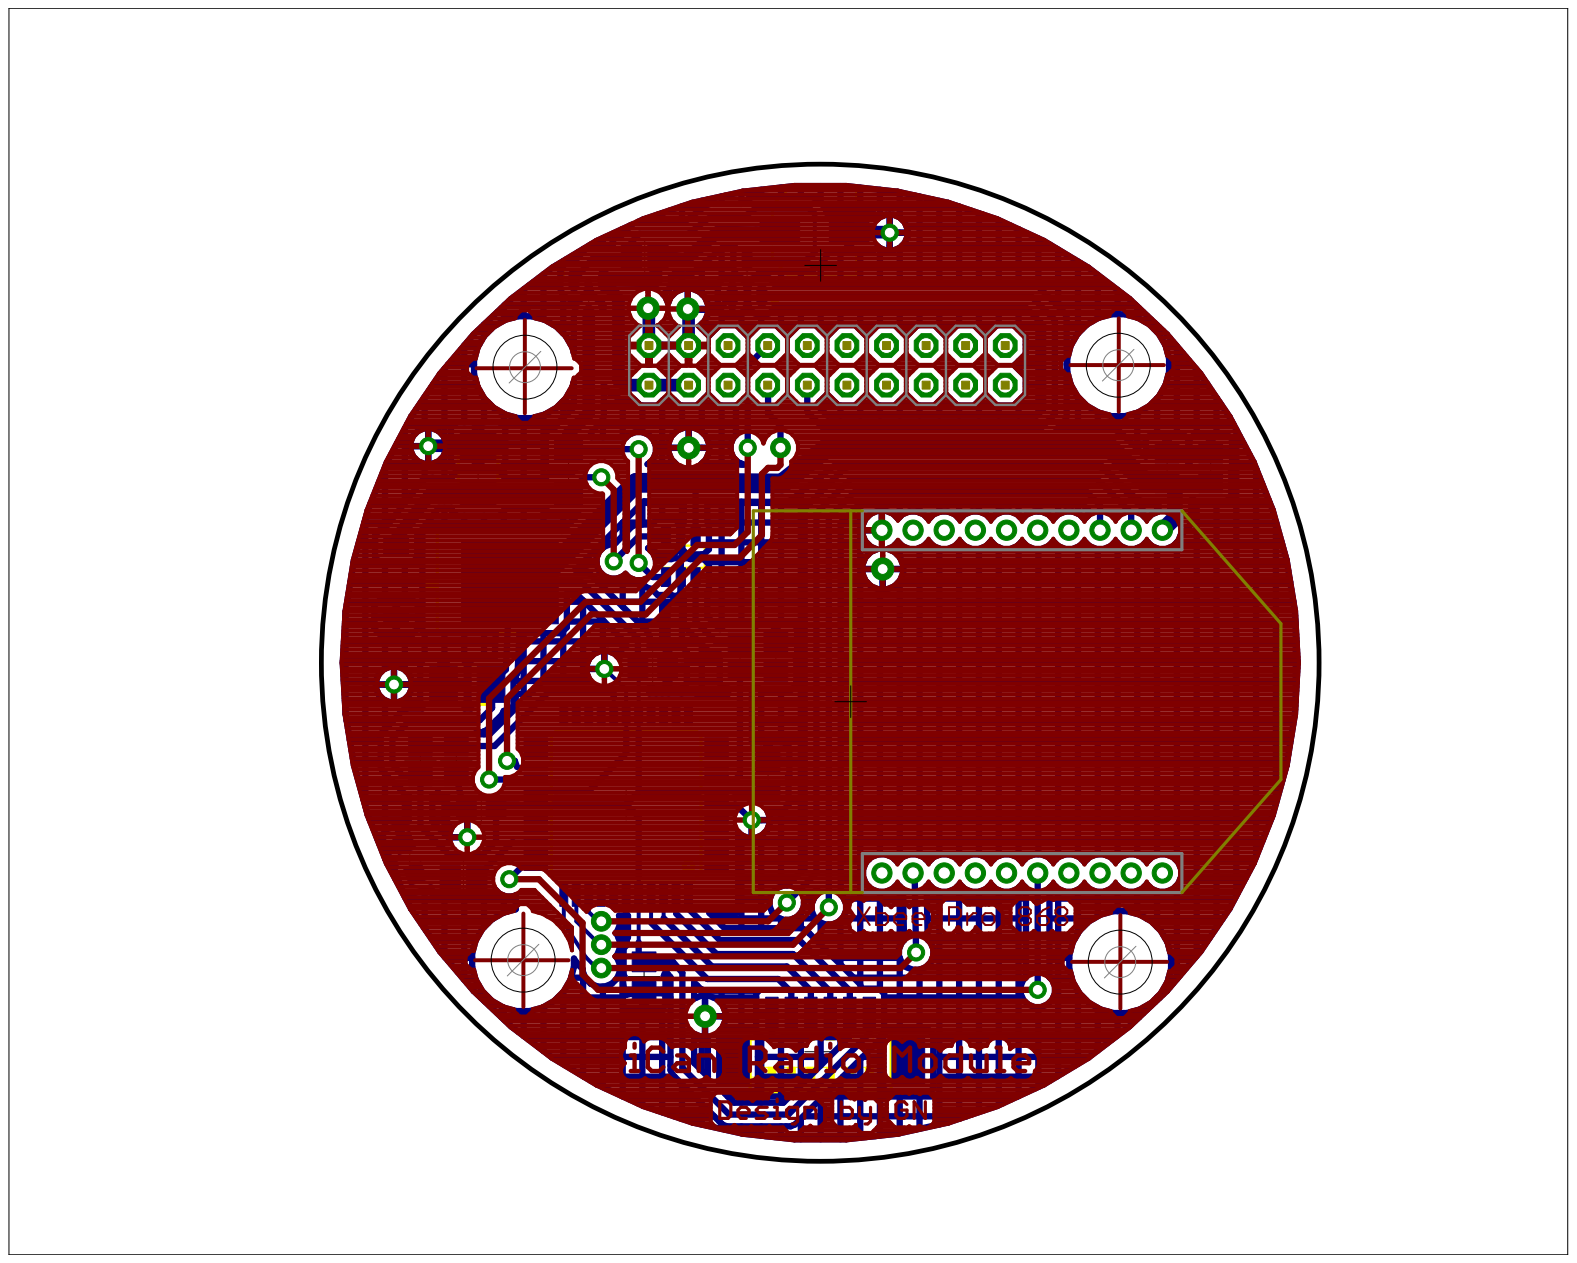
[picture p94: page 1]
