jorgenmk/avr-cansat/rapport/GPS-kort-brd-bunn.pdf

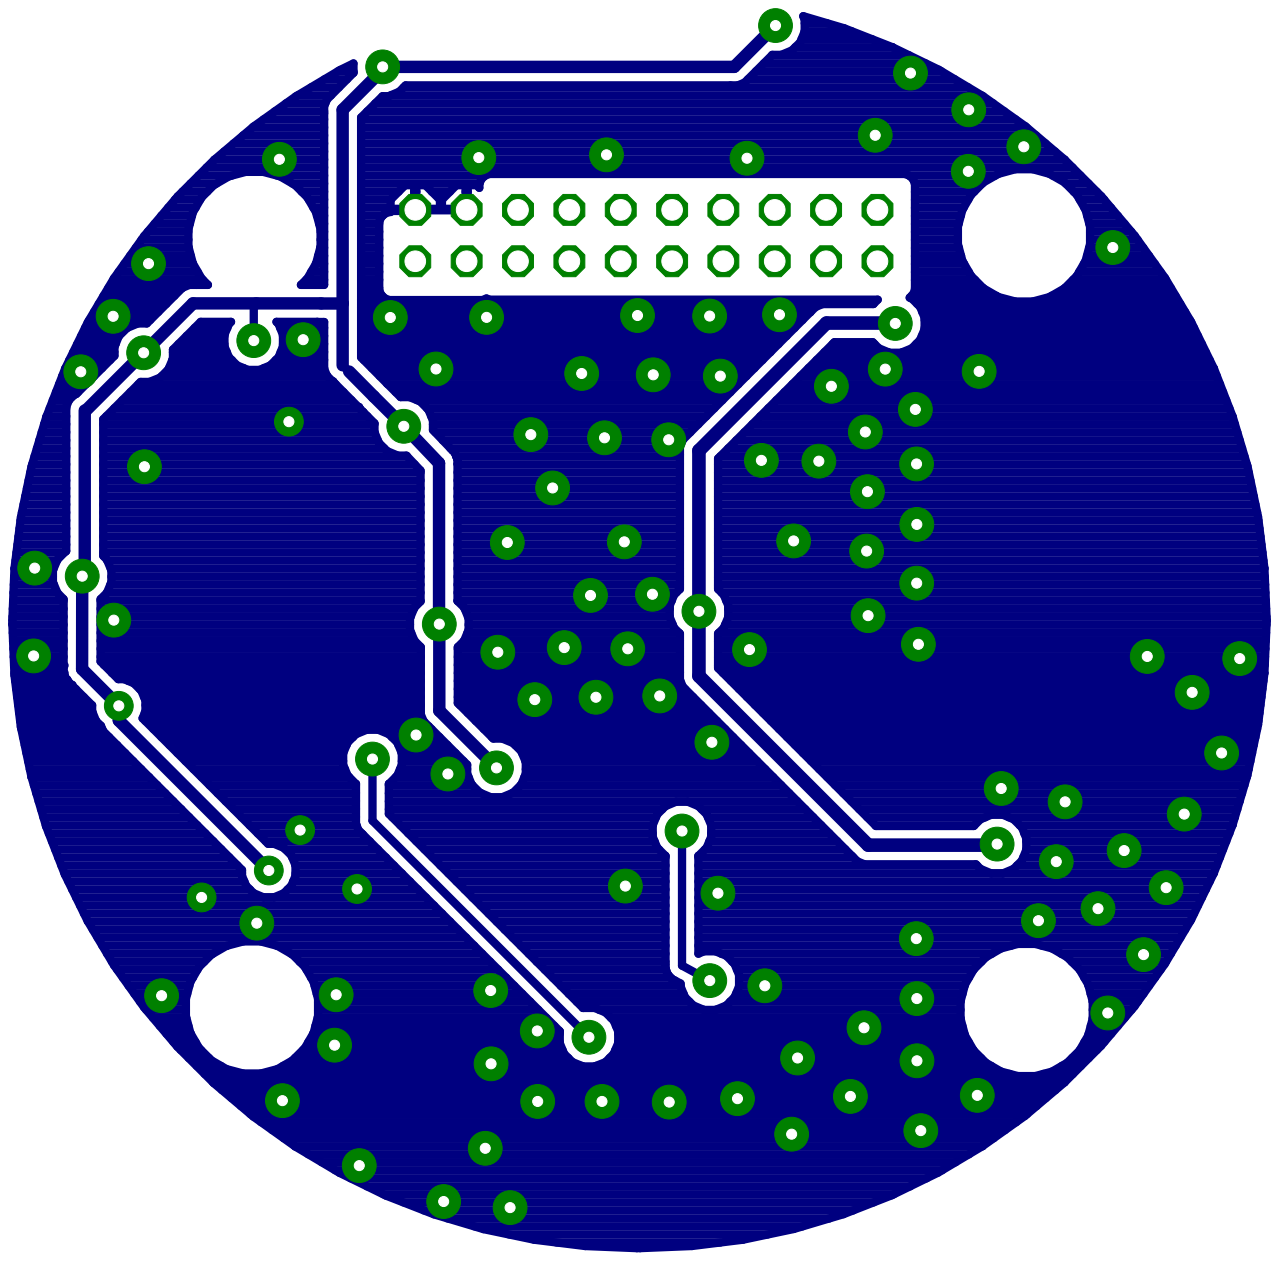
[picture p95: page 1]
