jorgenmk/avr-cansat/rapport/GPS-kort-brd-topp.pdf

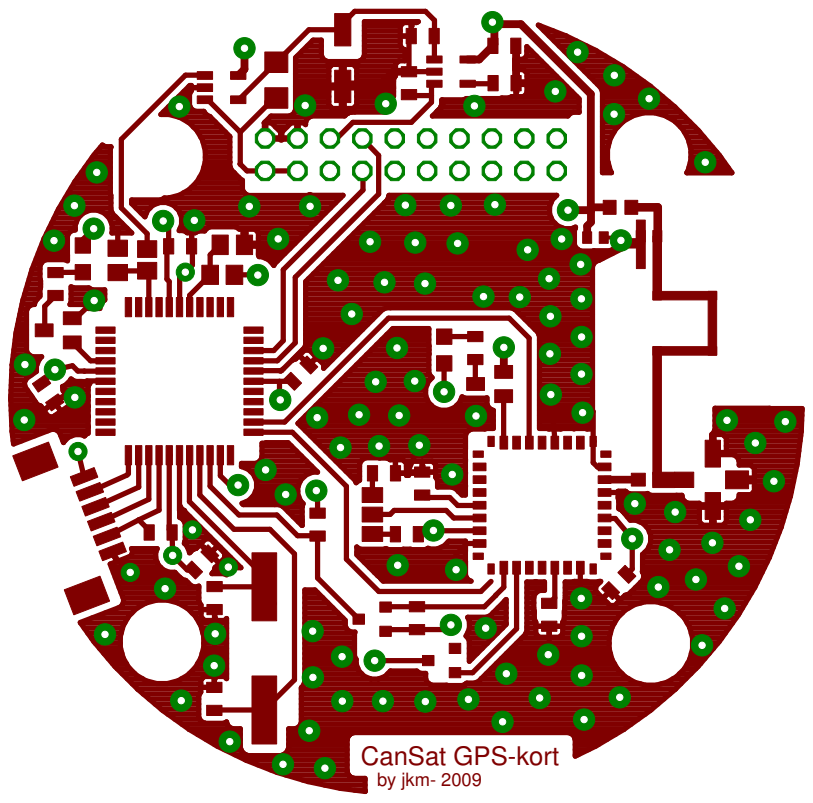
[picture p96: page 1]
