jorgenmk/avr-cansat/rapport/GPS-kort-brd.pdf

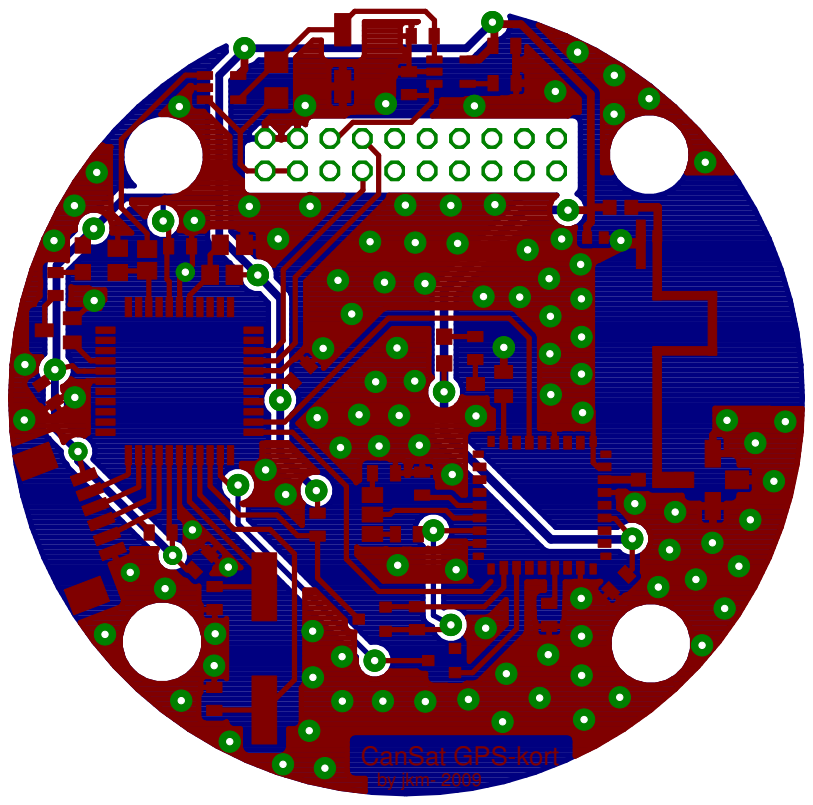
[picture p97: page 1]
