jorgenmk/avr-cansat/rapport/GPS-modul-oppkobling.pdf

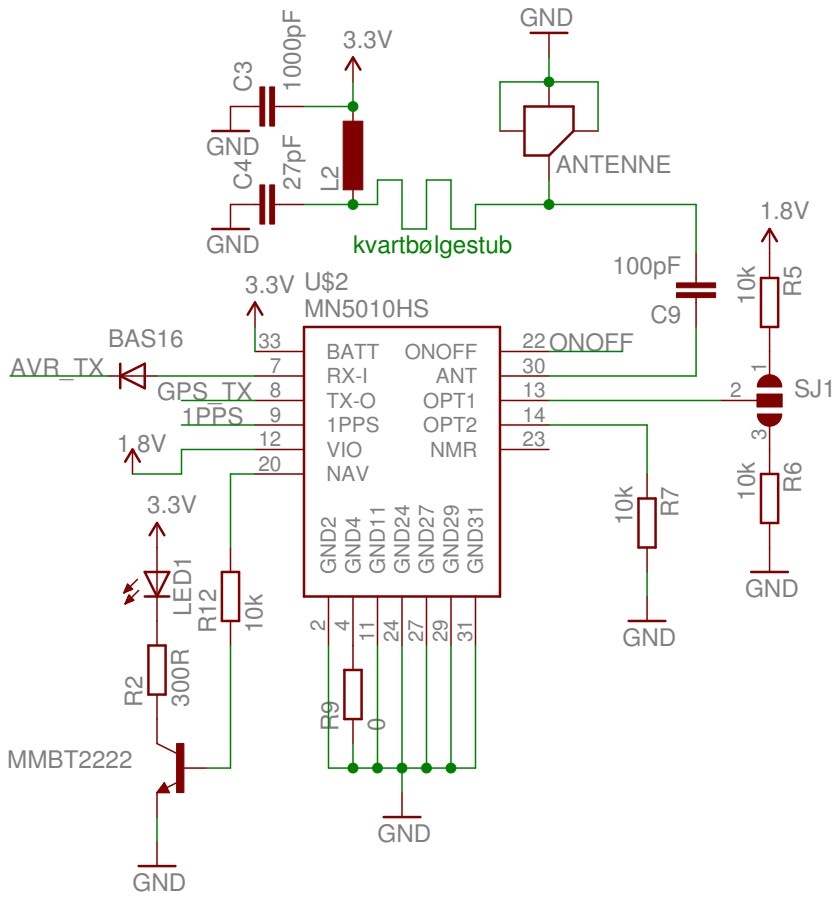
[picture p98: page 1]
