jorgenmk/avr-cansat/rapport/i2c-fig.pdf

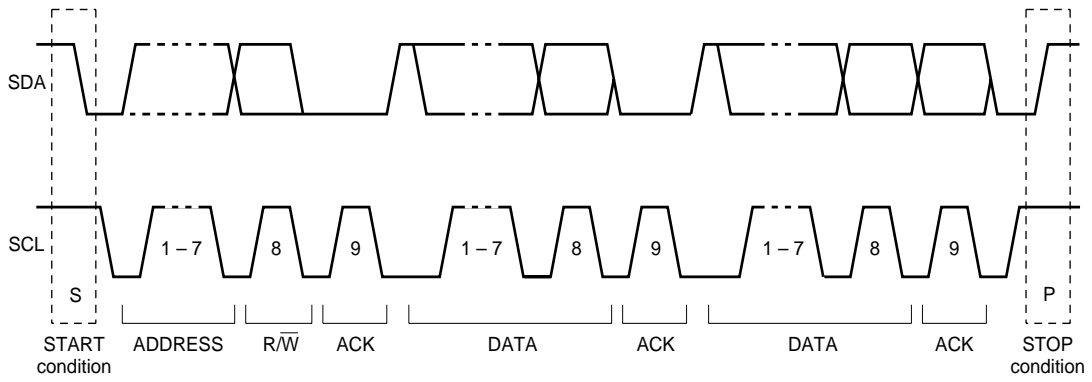
[picture p99: page 1]
STOP condition; START condition; ADDRESS; ACK R/W; DATA; ACK; SDA; SCL

handbook, full pagewidth
