jorgenmk/avr-cansat/rapport/kvartbolgestub.pdf

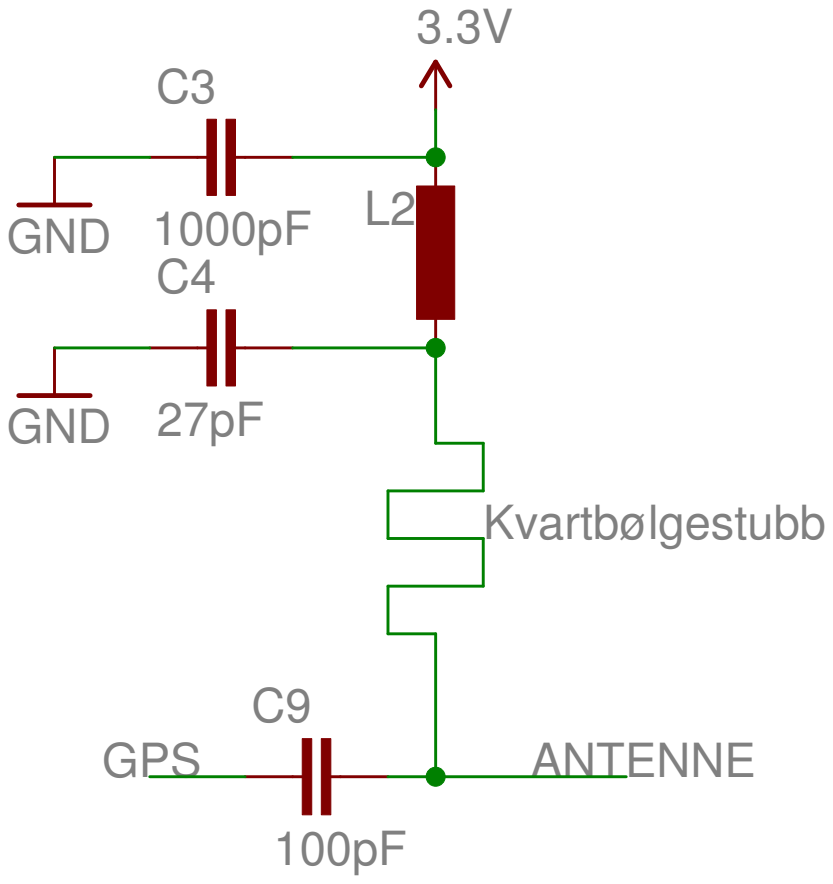
[picture p100: page 1]
