jorgenmk/avr-cansat/rapport/LED.pdf

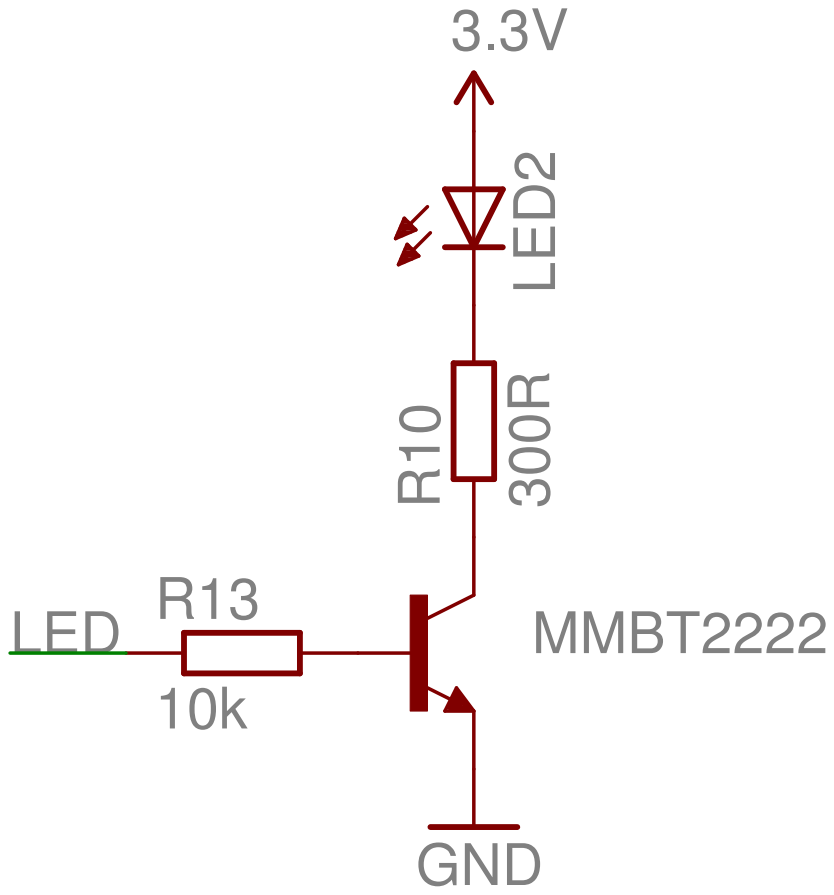
[picture p101: page 1]
