jorgenmk/avr-cansat/rapport/nivakonv.pdf

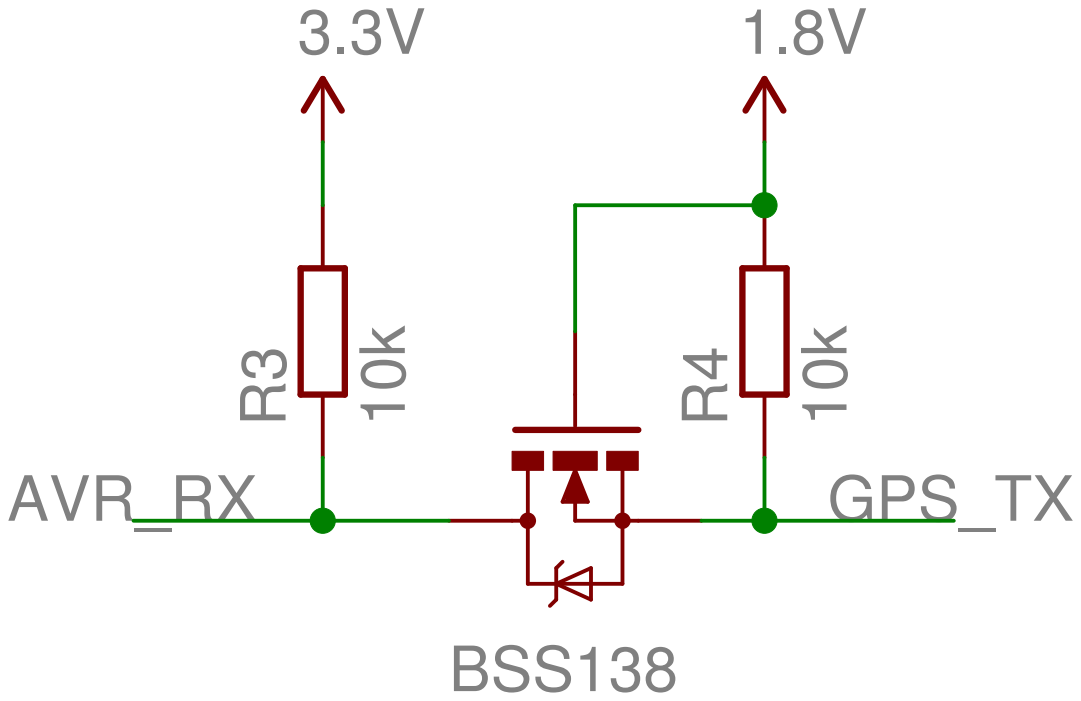
[picture p102: page 1]
