jorgenmk/avr-cansat/rapport/programmeringsplugg.pdf

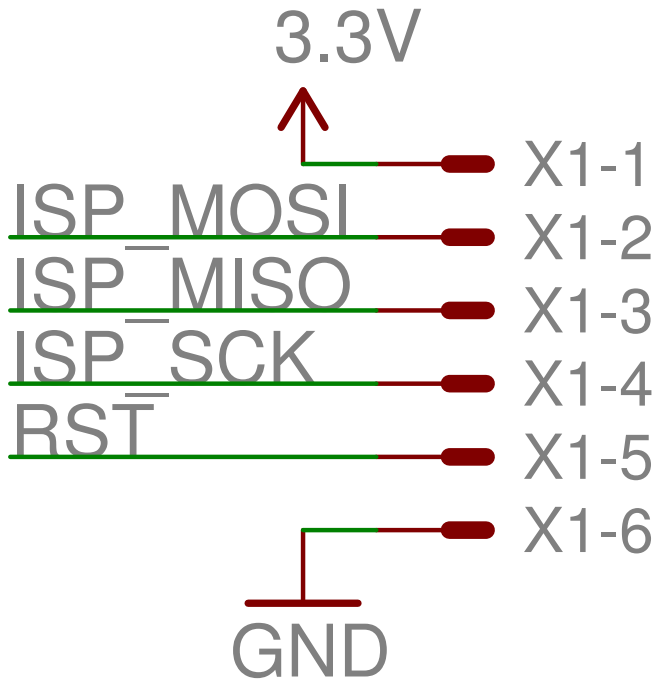
[picture p103: page 1]
