jorgenmk/avr-cansat/rapport/xbee skjema.pdf

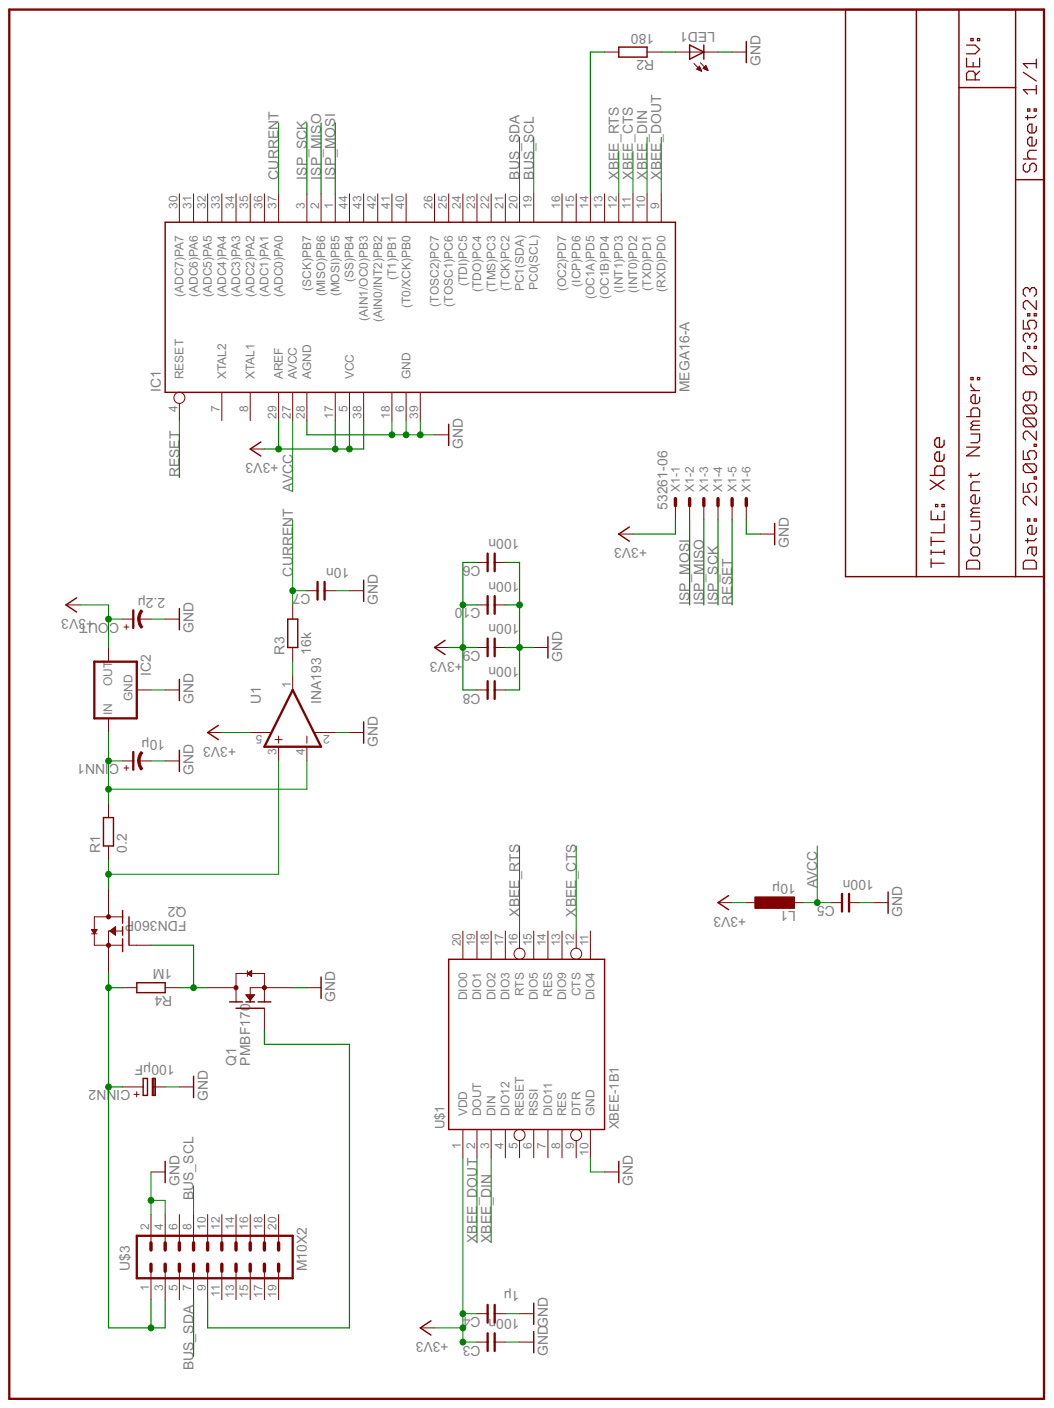
[picture p104: page 1]
