jorgenmk/avr-cansat/rapport/xbee-power.pdf

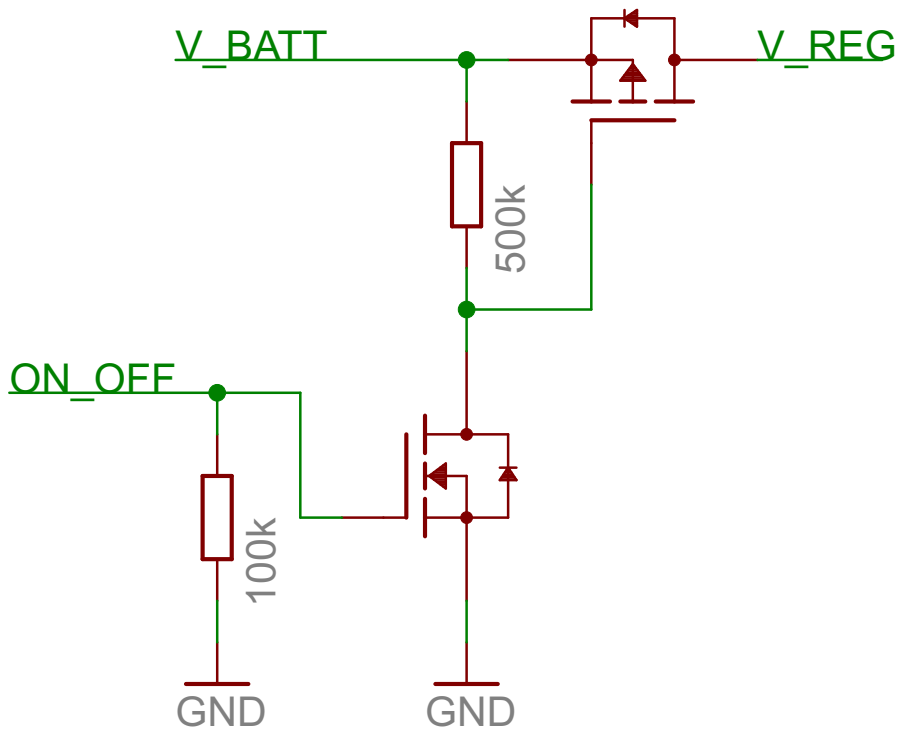
[picture p105: page 1]
