jorgenmk/avr-cansat/CPU-kort/Rapport/doc-circuit.pdf

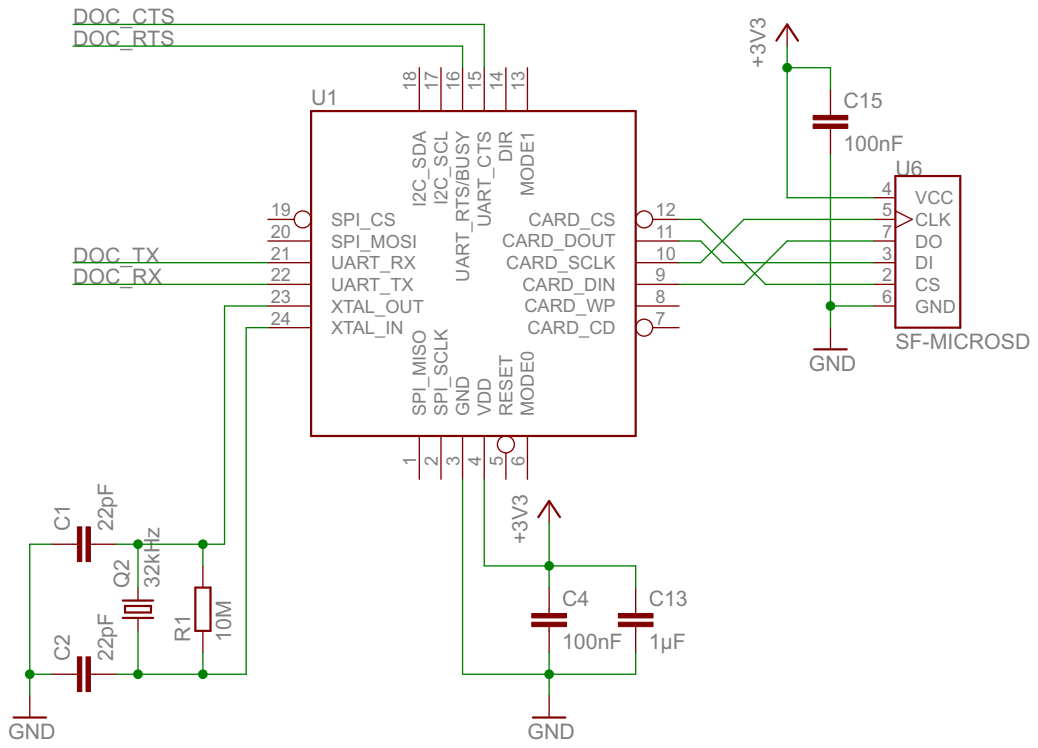
[picture p106: page 1]
