jorgenmk/avr-cansat/CPU-kort/Rapport/FT232RL-circuit.pdf

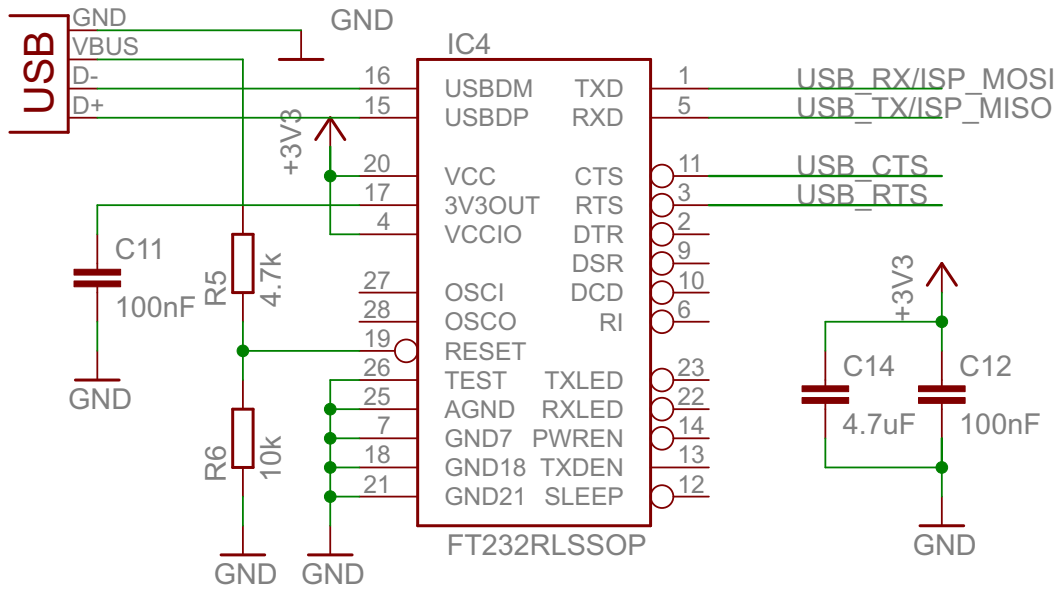
[picture p107: page 1]
