jorgenmk/avr-cansat/CPU-kort/Rapport/ina193-circuit.pdf

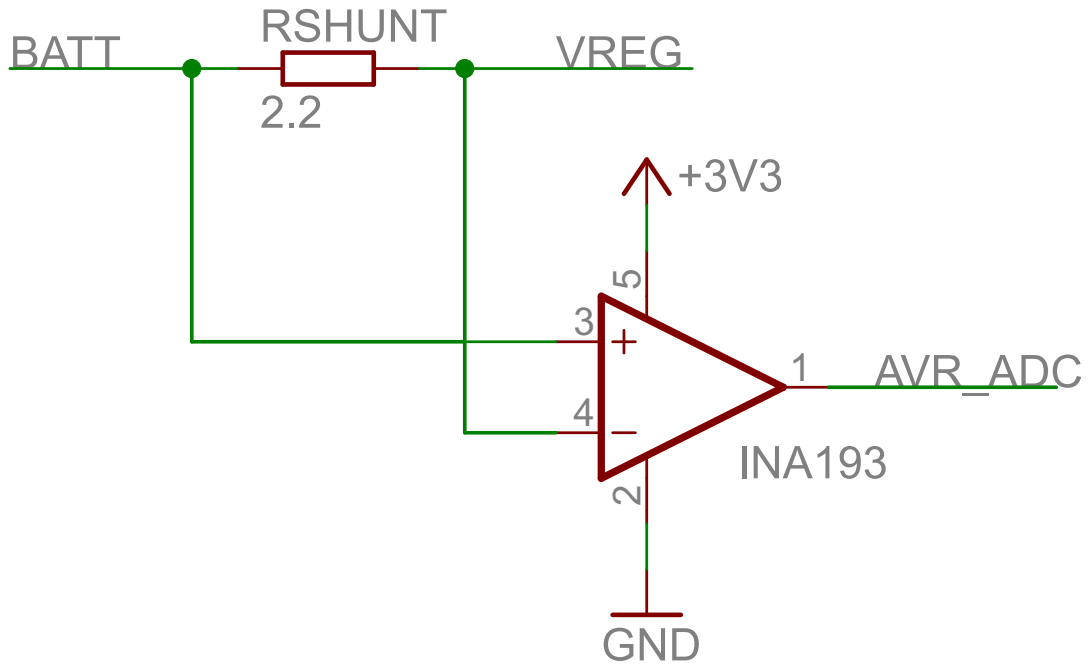
[picture p108: page 1]
