jorgenmk/avr-cansat/CPU-kort/Rapport/lp2985-circuit.pdf

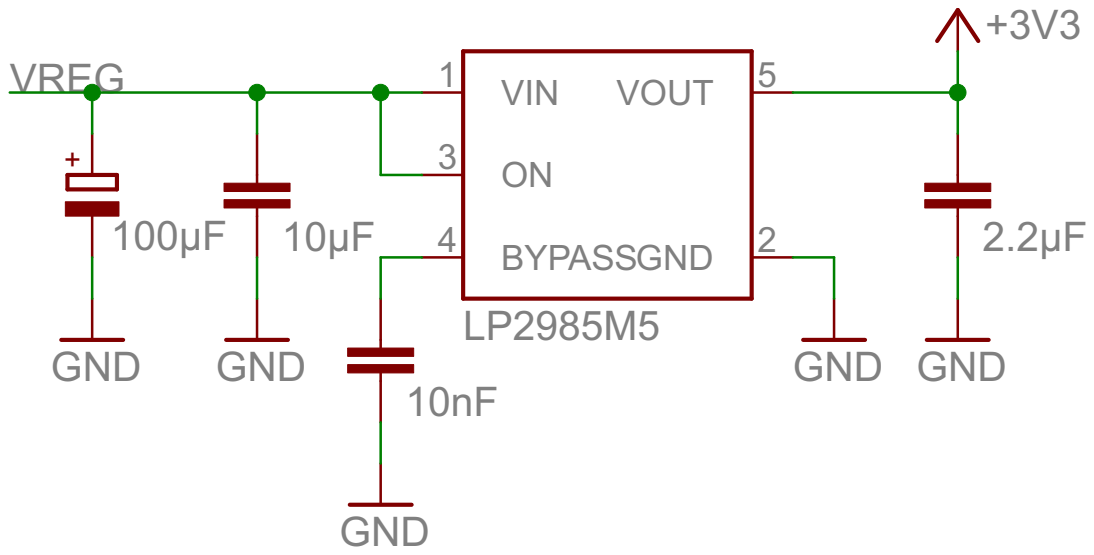
[picture p109: page 1]
