jorgenmk/avr-cansat/CPU-kort/Rapport/tsop348-pack.pdf

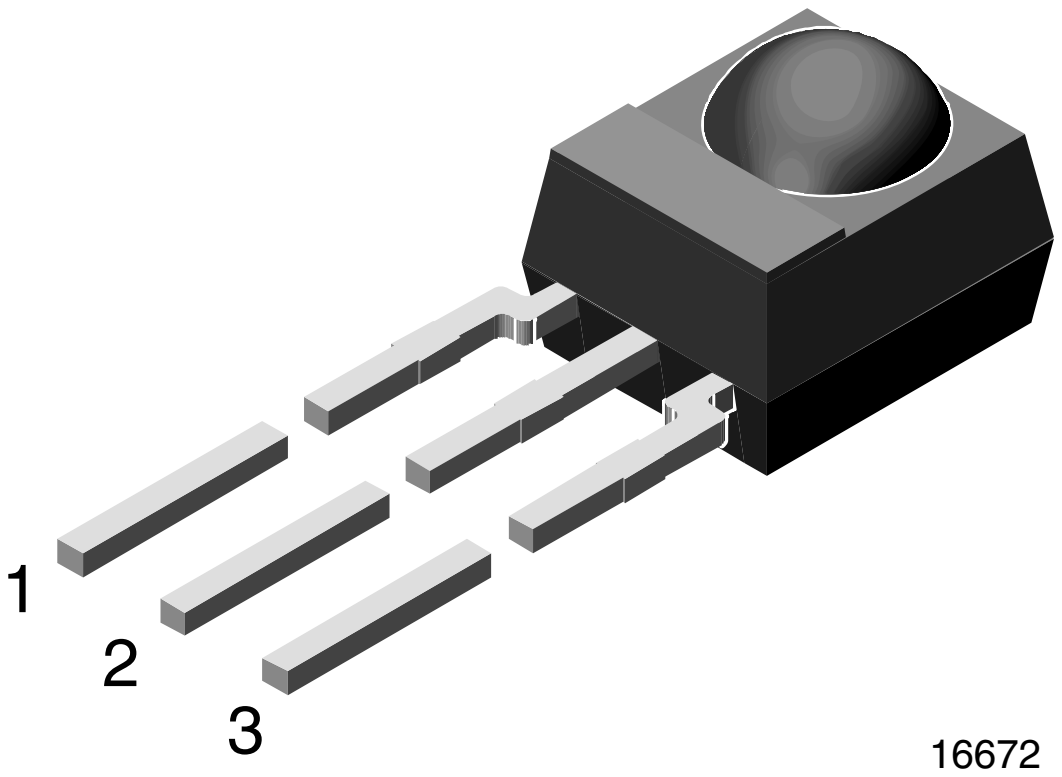
[picture p110: page 1]
