jorgenmk/avr-cansat/CPU-kort/Rapport/tsop34838-circuit.pdf

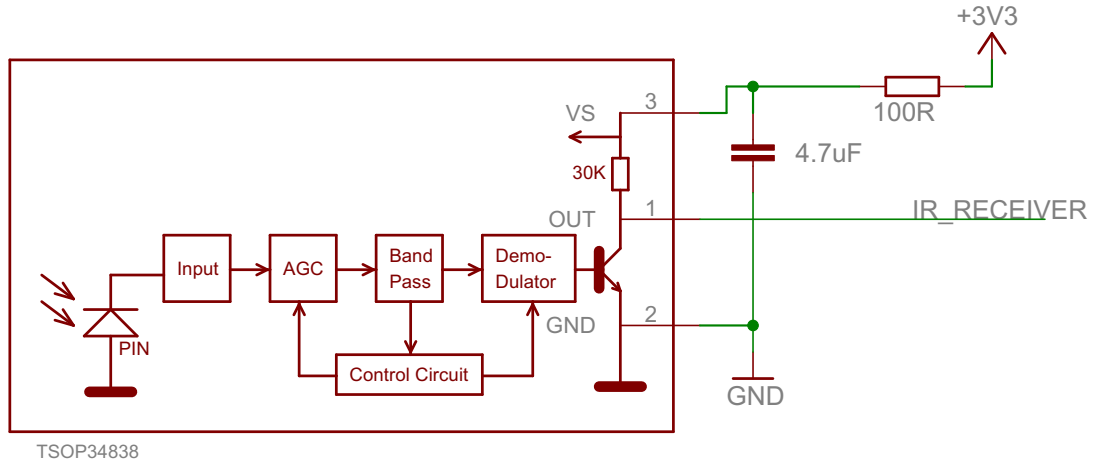
[picture p111: page 1]
