jorgenmk/avr-cansat/rapport/Hovedkort/f4.pdf

LDO | QUASI-LDO | STD

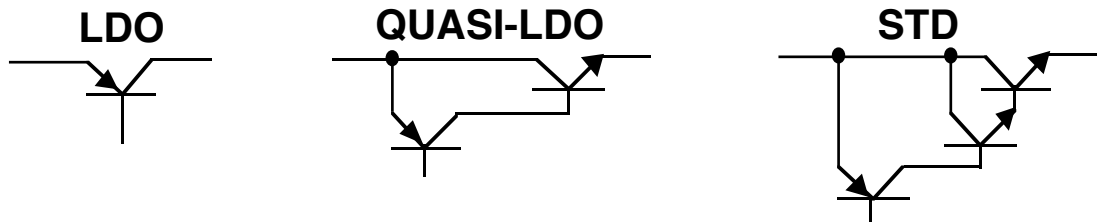
[picture p112: page 1]
VD = PNP SAT; VD =2 VBE + PNP SAT V = D VBE + PNP SAT
