jorgenmk/avr-cansat/rapport/Hovedkort/ft232r-circuit.pdf

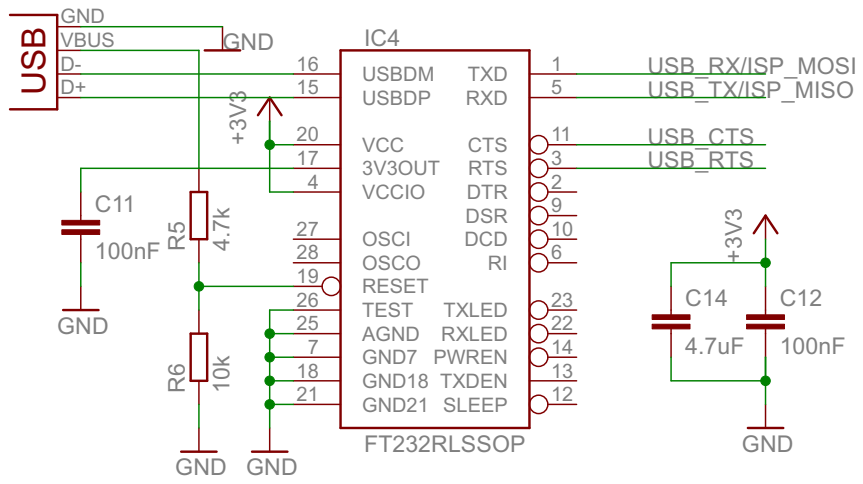
[picture p113: page 1]
