jorgenmk/avr-cansat/rapport/Hovedkort/leds-circuit.pdf

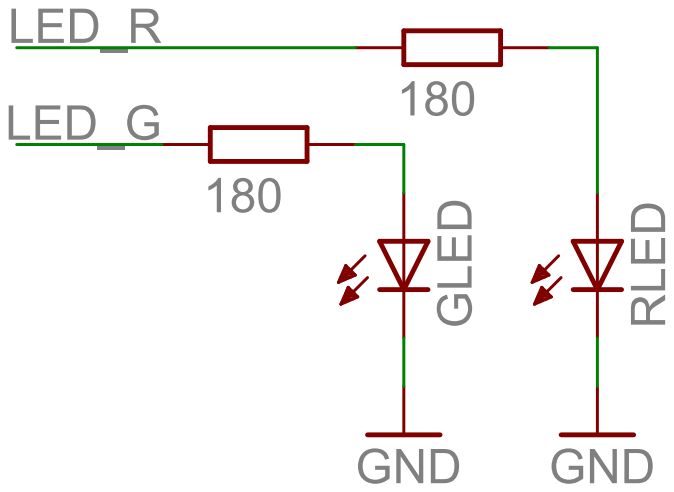
[picture p114: page 1]
