jorgenmk/avr-cansat/rapport/Hovedkort/MX53261.pdf

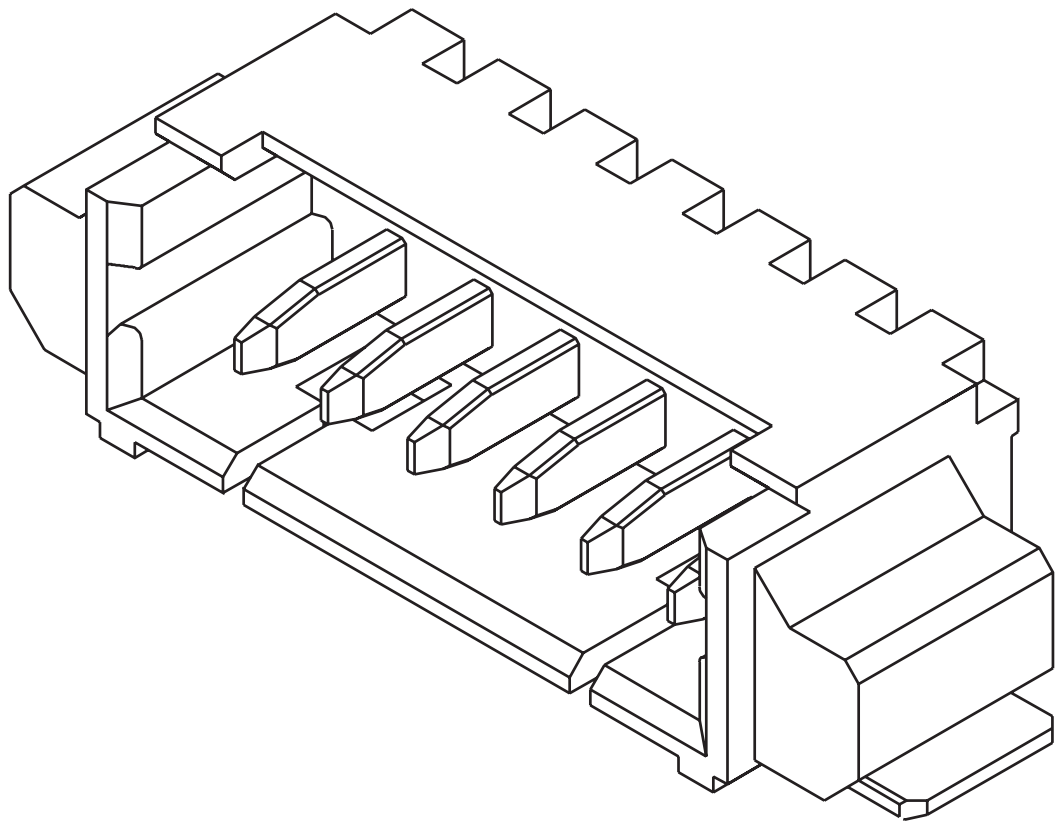
[picture p115: page 1]
