jorgenmk/avr-cansat/rapport/vedlegg/kretsskjemaradiokort.pdf

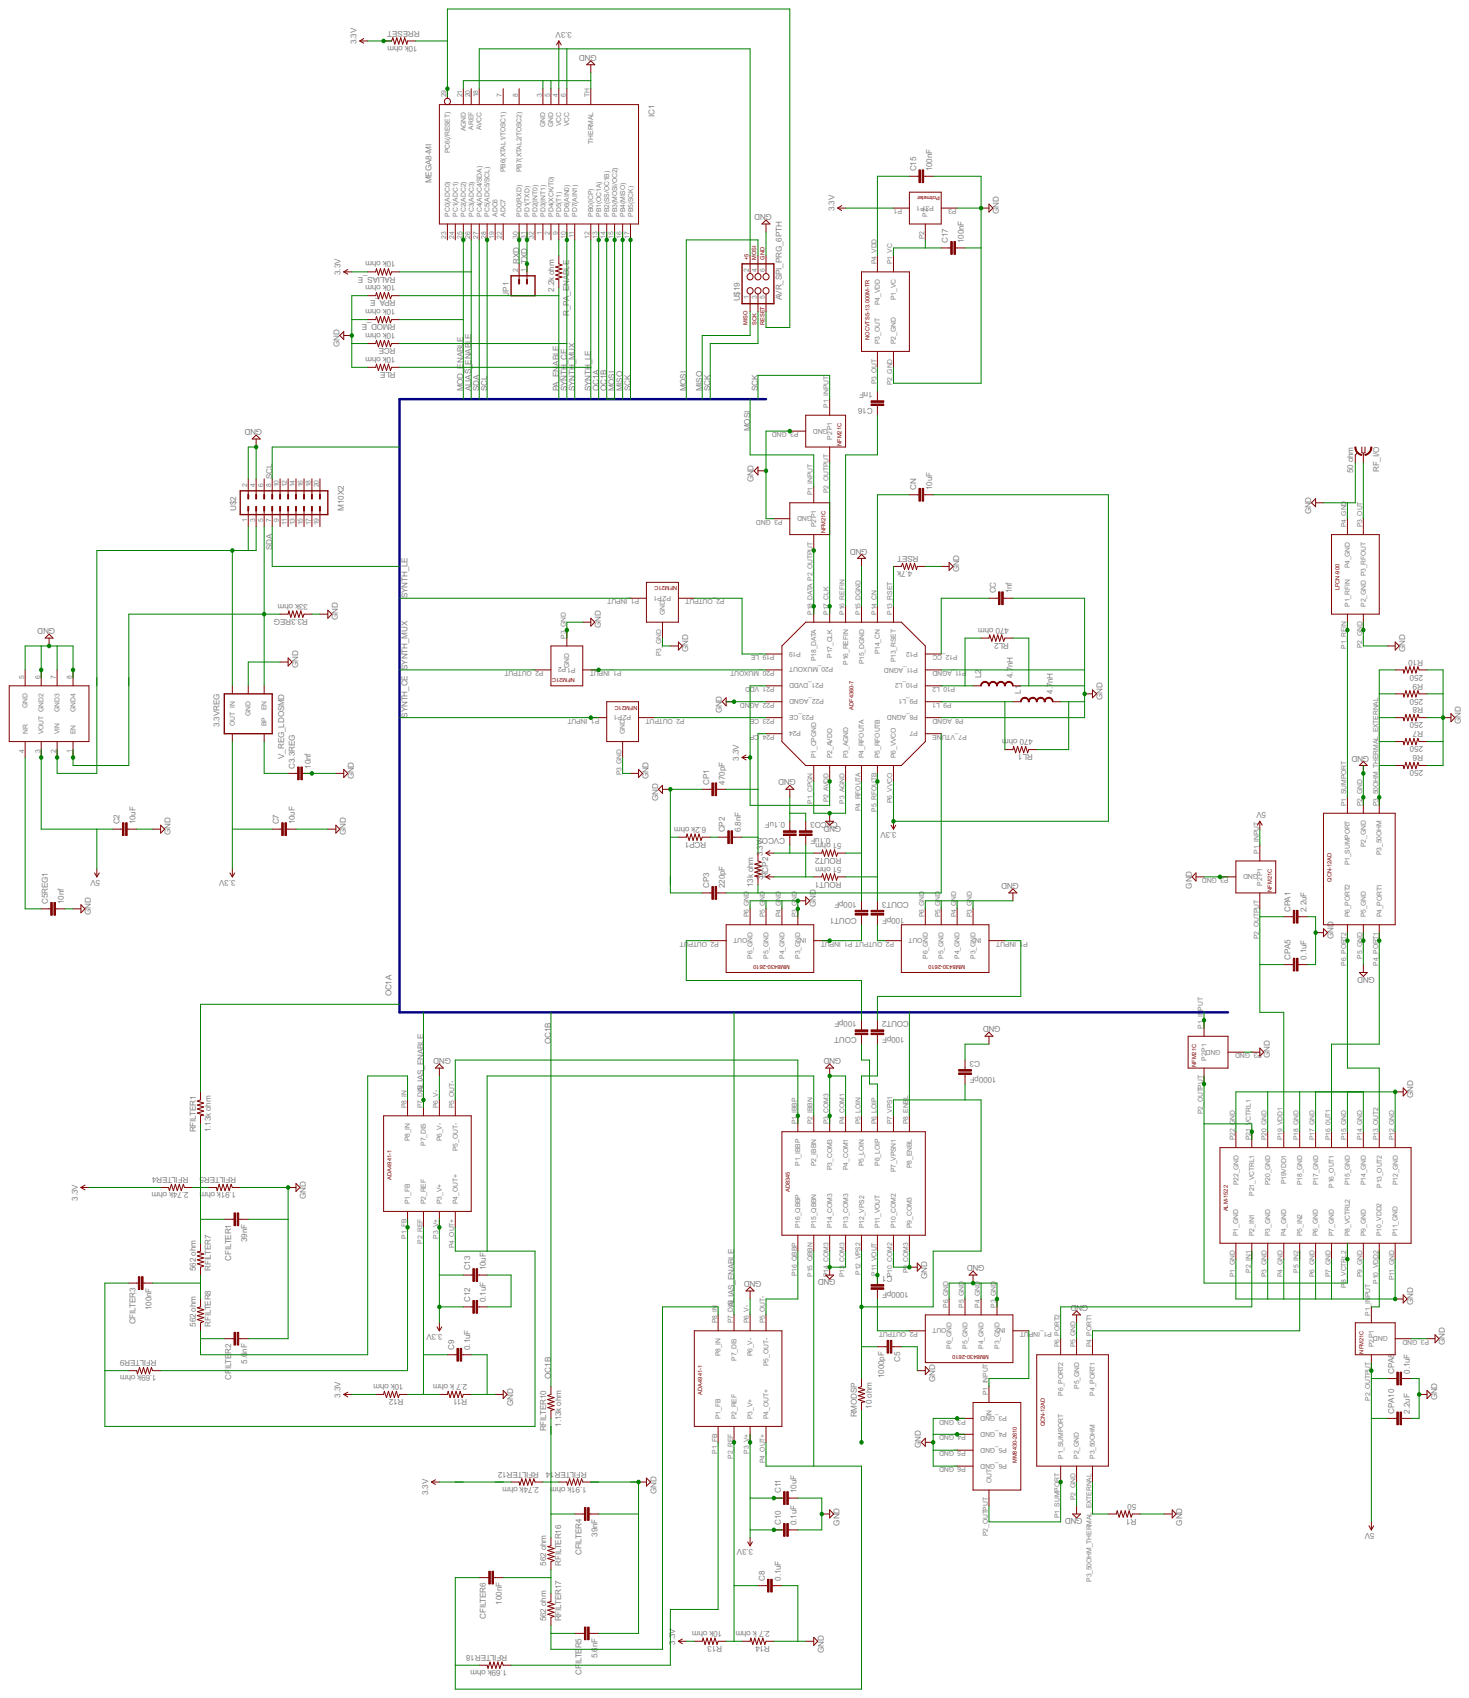
[picture p116: page 1]

PB4(MISO) 16 PB3(MOSI/OC2) 15 PB2(SS/OC1B) 14 PB1(OC1A) 13 PB0(ICP) 12 PD7(AIN1) 11 PD6(AIN0) 10 PD5(T1) 9 PD4(XCK/T0) 2 PD3(INT1) 1 PD2(INT0) 32 PD1(TXD) 31 PD0(RXD) 30 ADC7

MOSI RESET SCK MISO +5GND
