jorgenmk/avr-cansat/rapport/vedlegg/kretsutleggradiokortBunn.pdf

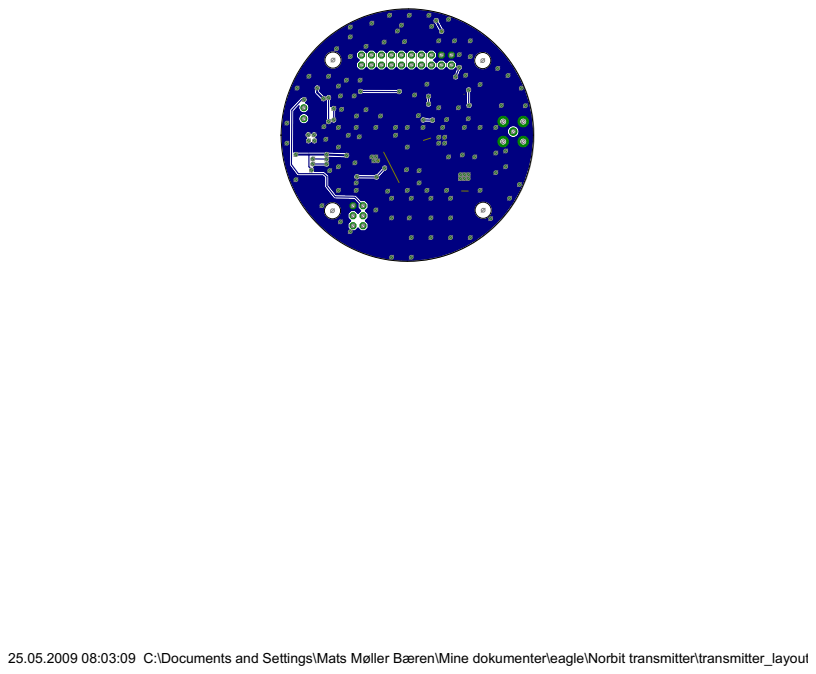
[picture p117: page 1]

25.05.2009 08:03:09 C:\Documents and Settings\Mats Møller Bæren\Mine dokumenter\eagle\Norbit transmitter\transmitter_layout_v2._mGND.brd
