jorgenmk/avr-cansat/rapport/vedlegg/kretsutleggradiokortTop.pdf

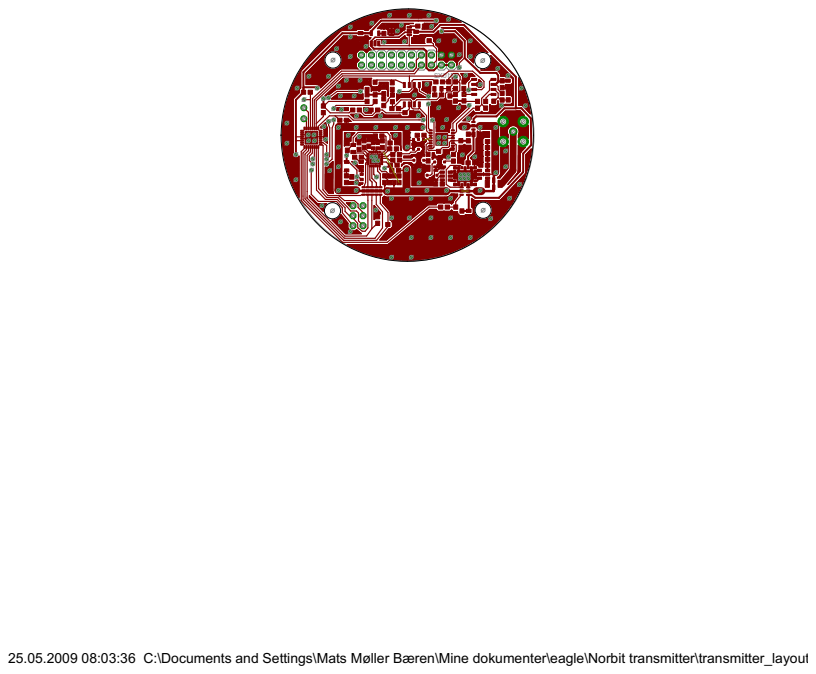
[picture p118: page 1]

25.05.2009 08:03:36 C:\Documents and Settings\Mats Møller Bæren\Mine dokumenter\eagle\Norbit transmitter\transmitter_layout_v2._mGND.brd
