jorgenmk/avr-cansat/Xbeekort/defines.h

#define F_CPU    1000000UL

#define LED      PD5

#define F_CPU 1000000UL
#define LED      PD5


#define F_CPU       1000000UL
#define BAUD        9600
#define MYUBRR      F_CPU/16/BAUD-1

#define UART_PORT   PORTD
#define UART_PIN    PIND
#define RTS         PD3
#define CTS         PD2


#define FLOW_CONTROL
